MinhNhut223/Automated-Poultry-Farming-Machine/HinhAnh/z6175985604822_b02541a4a94ac1b592ec28021ac87eae.jpg

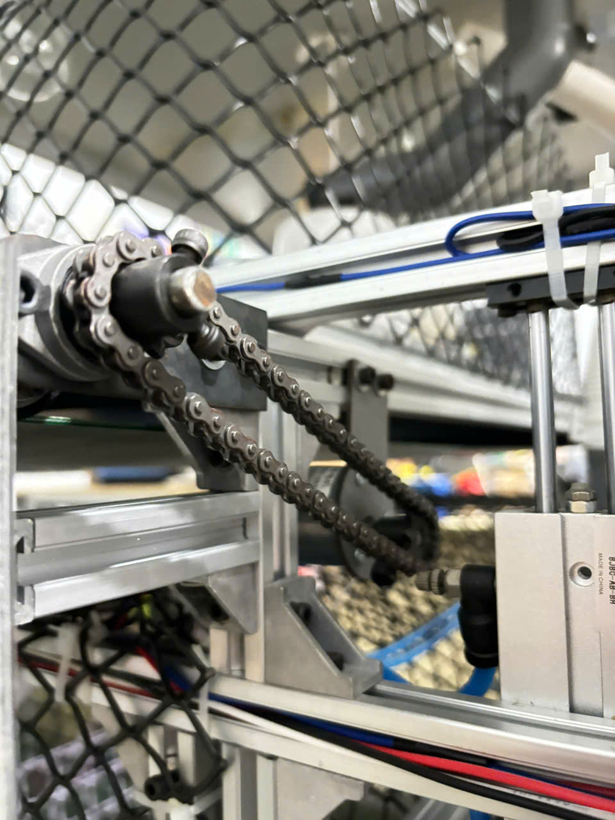
HinhAnh/z6175985604822_b02541a4a94ac1b592ec28021ac87eae.jpg
