MinhNhut223/Automated-Poultry-Farming-Machine/HinhAnh/z6175985603185_9a857a15ade55823d01da177bfa1e83b.jpg

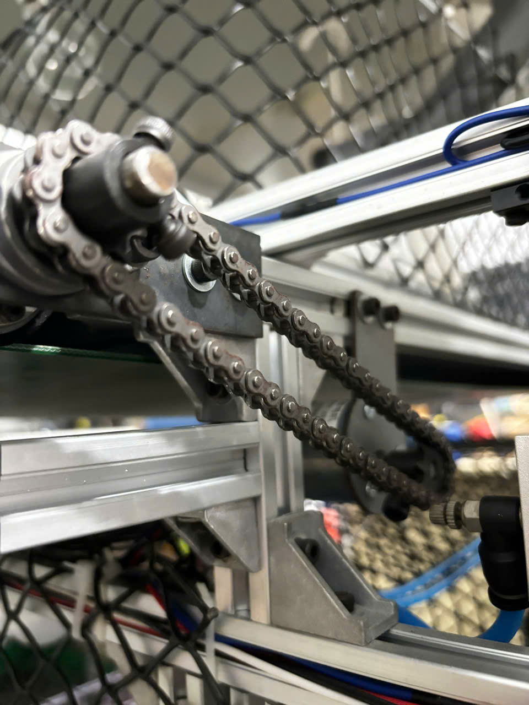
HinhAnh/z6175985603185_9a857a15ade55823d01da177bfa1e83b.jpg
