MinhNhut223/Automated-Poultry-Farming-Machine/chuongga/PerformanceLog.txt

Number of Contacts: 0
Number of contact data: 0
