MinhNhut223/Automated-Poultry-Farming-Machine/chuongga/khung-Static 1-1.docx

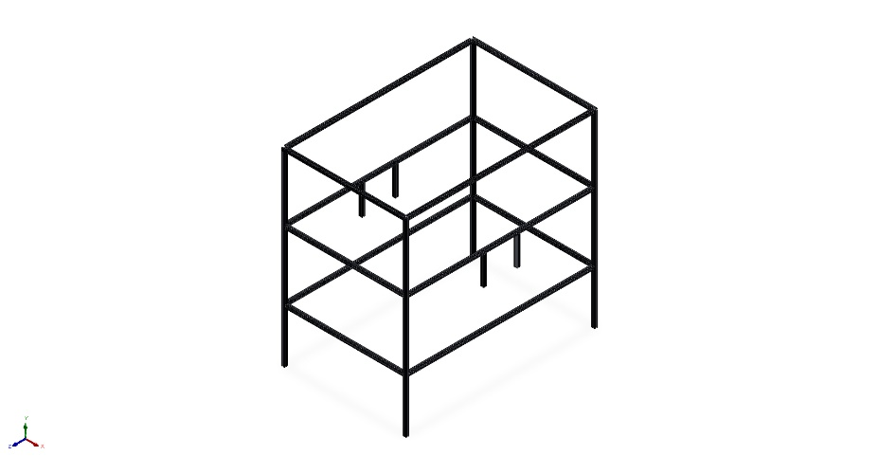
[picture p3: figure]

Simulation of khung

Date: Friday, December 27, 2024
Designer: Solidworks

Study name: Static 1

Analysis type: Static
Description No Data

# Assumptions

# Model Information

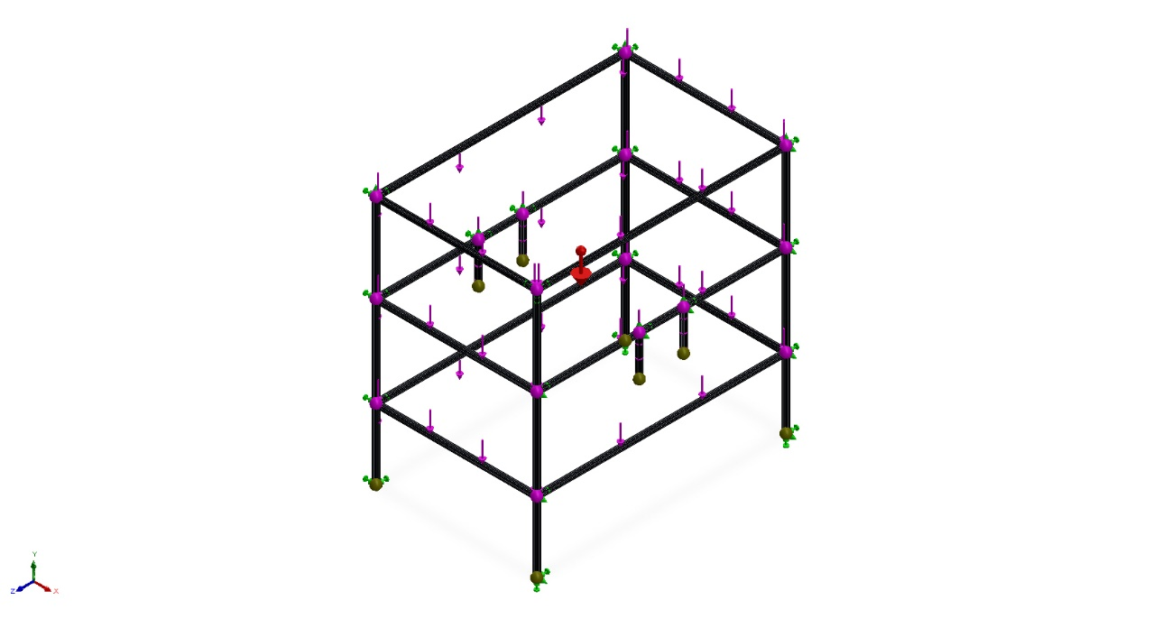
[picture p4: figure]

Model name: khung

Current Configuration: Default<As Machined>

Beam Bodies:
Document Name and Reference | Formulation | Properties | Document Path/Date Modified
SolidBody 1( C:\THUVIENSOLIDWORKS\ALUMINUM FRAMES25102020\SERI 5 (20,40)\20X20S5 - IS MISSING(1)[8]) | Beam – Uniform C/S | Section Standard-Aluminum Frames25102020/SERI 5 (20,40)/20x20S5 Section Area: 0.000172186m^2 Length:780mm Volume:0.000134512m^3 Mass Density:2,700kg/m^3 Mass:0.363182kg Weight:3.55919N | C:\Users\Asus\Desktop\chuongga\chuongga\khung.SLDPRT Dec 23 21:09:03 2024
SolidBody 2( C:\THUVIENSOLIDWORKS\ALUMINUM FRAMES25102020\SERI 5 (20,40)\20X20S5 - IS MISSING(1)[6]) | Beam – Uniform C/S | Section Standard-Aluminum Frames25102020/SERI 5 (20,40)/20x20S5 Section Area: 0.000172186m^2 Length:780mm Volume:0.000134512m^3 Mass Density:2,700kg/m^3 Mass:0.363182kg Weight:3.55919N | C:\Users\Asus\Desktop\chuongga\chuongga\khung.SLDPRT Dec 23 21:09:03 2024
SolidBody 3( C:\THUVIENSOLIDWORKS\ALUMINUM FRAMES25102020\SERI 5 (20,40)\20X20S5 - IS MISSING(1)[16]) | Beam – Uniform C/S | Section Standard-Aluminum Frames25102020/SERI 5 (20,40)/20x20S5 Section Area: 0.000172186m^2 Length:190.4mm Volume:3.27842e-05m^3 Mass Density:2,700kg/m^3 Mass:0.0885173kg Weight:0.86747N | C:\Users\Asus\Desktop\chuongga\chuongga\khung.SLDPRT Dec 23 21:09:03 2024
SolidBody 4( C:\THUVIENSOLIDWORKS\ALUMINUM FRAMES25102020\SERI 5 (20,40)\20X20S5 - IS MISSING(1)[10]) | Beam – Uniform C/S | Section Standard-Aluminum Frames25102020/SERI 5 (20,40)/20x20S5 Section Area: 0.000172186m^2 Length:1,220.8mm Volume:0.000210205m^3 Mass Density:2,700kg/m^3 Mass:0.567552kg Weight:5.56201N | C:\Users\Asus\Desktop\chuongga\chuongga\khung.SLDPRT Dec 23 21:09:03 2024
SolidBody 5( C:\THUVIENSOLIDWORKS\ALUMINUM FRAMES25102020\SERI 5 (20,40)\20X20S5 - IS MISSING(1)[11]) | Beam – Uniform C/S | Section Standard-Aluminum Frames25102020/SERI 5 (20,40)/20x20S5 Section Area: 0.000172186m^2 Length:1,220.8mm Volume:0.000210205m^3 Mass Density:2,700kg/m^3 Mass:0.567552kg Weight:5.56201N | C:\Users\Asus\Desktop\chuongga\chuongga\khung.SLDPRT Dec 23 21:09:03 2024
SolidBody 6( C:\THUVIENSOLIDWORKS\ALUMINUM FRAMES25102020\SERI 5 (20,40)\20X20S5 - IS MISSING(1)[2]) | Beam – Uniform C/S | Section Standard-Aluminum Frames25102020/SERI 5 (20,40)/20x20S5 Section Area: 0.000172186m^2 Length:1,240mm Volume:0.00021351m^3 Mass Density:2,700kg/m^3 Mass:0.576478kg Weight:5.64949N | C:\Users\Asus\Desktop\chuongga\chuongga\khung.SLDPRT Dec 23 21:09:03 2024
SolidBody 7( C:\THUVIENSOLIDWORKS\ALUMINUM FRAMES25102020\SERI 5 (20,40)\20X20S5 - IS MISSING(1)[14]) | Beam – Uniform C/S | Section Standard-Aluminum Frames25102020/SERI 5 (20,40)/20x20S5 Section Area: 0.000172186m^2 Length:190.4mm Volume:3.27842e-05m^3 Mass Density:2,700kg/m^3 Mass:0.0885173kg Weight:0.86747N | C:\Users\Asus\Desktop\chuongga\chuongga\khung.SLDPRT Dec 23 21:09:03 2024
SolidBody 8( C:\THUVIENSOLIDWORKS\ALUMINUM FRAMES25102020\SERI 5 (20,40)\20X20S5 - IS MISSING(1)[18]) | Beam – Uniform C/S | Section Standard-Aluminum Frames25102020/SERI 5 (20,40)/20x20S5 Section Area: 0.000172186m^2 Length:780mm Volume:0.000134305m^3 Mass Density:2,700kg/m^3 Mass:0.362623kg Weight:3.55371N | C:\Users\Asus\Desktop\chuongga\chuongga\khung.SLDPRT Dec 23 21:09:03 2024
SolidBody 9( C:\THUVIENSOLIDWORKS\ALUMINUM FRAMES25102020\SERI 5 (20,40)\20X20S5 - IS MISSING(1)[9]) | Beam – Uniform C/S | Section Standard-Aluminum Frames25102020/SERI 5 (20,40)/20x20S5 Section Area: 0.000172186m^2 Length:1,220.8mm Volume:0.000210205m^3 Mass Density:2,700kg/m^3 Mass:0.567552kg Weight:5.56201N | C:\Users\Asus\Desktop\chuongga\chuongga\khung.SLDPRT Dec 23 21:09:03 2024
SolidBody 10( C:\THUVIENSOLIDWORKS\ALUMINUM FRAMES25102020\SERI 5 (20,40)\20X20S5 - IS MISSING(1)[4]) | Beam – Uniform C/S | Section Standard-Aluminum Frames25102020/SERI 5 (20,40)/20x20S5 Section Area: 0.000172186m^2 Length:1,240mm Volume:0.00021351m^3 Mass Density:2,700kg/m^3 Mass:0.576478kg Weight:5.64949N | C:\Users\Asus\Desktop\chuongga\chuongga\khung.SLDPRT Dec 23 21:09:03 2024
SolidBody 11( C:\THUVIENSOLIDWORKS\ALUMINUM FRAMES25102020\SERI 5 (20,40)\20X20S5 - IS MISSING(1)[19]) | Beam – Uniform C/S | Section Standard-Aluminum Frames25102020/SERI 5 (20,40)/20x20S5 Section Area: 0.000172186m^2 Length:780mm Volume:0.000134305m^3 Mass Density:2,700kg/m^3 Mass:0.362623kg Weight:3.55371N | C:\Users\Asus\Desktop\chuongga\chuongga\khung.SLDPRT Dec 23 21:09:03 2024
SolidBody 12( C:\THUVIENSOLIDWORKS\ALUMINUM FRAMES25102020\SERI 5 (20,40)\20X20S5 - IS MISSING(1)[12]) | Beam – Uniform C/S | Section Standard-Aluminum Frames25102020/SERI 5 (20,40)/20x20S5 Section Area: 0.000172186m^2 Length:1,220.8mm Volume:0.000210205m^3 Mass Density:2,700kg/m^3 Mass:0.567552kg Weight:5.56201N | C:\Users\Asus\Desktop\chuongga\chuongga\khung.SLDPRT Dec 23 21:09:03 2024
SolidBody 13( C:\THUVIENSOLIDWORKS\ALUMINUM FRAMES25102020\SERI 5 (20,40)\20X20S5 - IS MISSING(1)[1]) | Beam – Uniform C/S | Section Standard-Aluminum Frames25102020/SERI 5 (20,40)/20x20S5 Section Area: 0.000172186m^2 Length:1,240mm Volume:0.00021351m^3 Mass Density:2,700kg/m^3 Mass:0.576478kg Weight:5.64949N | C:\Users\Asus\Desktop\chuongga\chuongga\khung.SLDPRT Dec 23 21:09:03 2024
SolidBody 14( C:\THUVIENSOLIDWORKS\ALUMINUM FRAMES25102020\SERI 5 (20,40)\20X20S5 - IS MISSING(1)[5]) | Beam – Uniform C/S | Section Standard-Aluminum Frames25102020/SERI 5 (20,40)/20x20S5 Section Area: 0.000172186m^2 Length:1,220.8mm Volume:0.000210203m^3 Mass Density:2,700kg/m^3 Mass:0.567547kg Weight:5.56196N | C:\Users\Asus\Desktop\chuongga\chuongga\khung.SLDPRT Dec 23 21:09:03 2024
SolidBody 15( C:\THUVIENSOLIDWORKS\ALUMINUM FRAMES25102020\SERI 5 (20,40)\20X20S5 - IS MISSING(1)[15]) | Beam – Uniform C/S | Section Standard-Aluminum Frames25102020/SERI 5 (20,40)/20x20S5 Section Area: 0.000172186m^2 Length:190.4mm Volume:3.27842e-05m^3 Mass Density:2,700kg/m^3 Mass:0.0885173kg Weight:0.86747N | C:\Users\Asus\Desktop\chuongga\chuongga\khung.SLDPRT Dec 23 21:09:03 2024
SolidBody 16( C:\THUVIENSOLIDWORKS\ALUMINUM FRAMES25102020\SERI 5 (20,40)\20X20S5 - IS MISSING(1)[7]) | Beam – Uniform C/S | Section Standard-Aluminum Frames25102020/SERI 5 (20,40)/20x20S5 Section Area: 0.000172186m^2 Length:1,220.8mm Volume:0.000210203m^3 Mass Density:2,700kg/m^3 Mass:0.567547kg Weight:5.56196N | C:\Users\Asus\Desktop\chuongga\chuongga\khung.SLDPRT Dec 23 21:09:03 2024
SolidBody 17( C:\THUVIENSOLIDWORKS\ALUMINUM FRAMES25102020\SERI 5 (20,40)\20X20S5 - IS MISSING(1)[17]) | Beam – Uniform C/S | Section Standard-Aluminum Frames25102020/SERI 5 (20,40)/20x20S5 Section Area: 0.000172186m^2 Length:780mm Volume:0.000134305m^3 Mass Density:2,700kg/m^3 Mass:0.362623kg Weight:3.55371N | C:\Users\Asus\Desktop\chuongga\chuongga\khung.SLDPRT Dec 23 21:09:03 2024
SolidBody 18( C:\THUVIENSOLIDWORKS\ALUMINUM FRAMES25102020\SERI 5 (20,40)\20X20S5 - IS MISSING(1)[3]) | Beam – Uniform C/S | Section Standard-Aluminum Frames25102020/SERI 5 (20,40)/20x20S5 Section Area: 0.000172186m^2 Length:1,240mm Volume:0.00021351m^3 Mass Density:2,700kg/m^3 Mass:0.576478kg Weight:5.64949N | C:\Users\Asus\Desktop\chuongga\chuongga\khung.SLDPRT Dec 23 21:09:03 2024
SolidBody 19( C:\THUVIENSOLIDWORKS\ALUMINUM FRAMES25102020\SERI 5 (20,40)\20X20S5 - IS MISSING(1)[20]) | Beam – Uniform C/S | Section Standard-Aluminum Frames25102020/SERI 5 (20,40)/20x20S5 Section Area: 0.000172186m^2 Length:780mm Volume:0.000134305m^3 Mass Density:2,700kg/m^3 Mass:0.362623kg Weight:3.55371N | C:\Users\Asus\Desktop\chuongga\chuongga\khung.SLDPRT Dec 23 21:09:03 2024
SolidBody 20( C:\THUVIENSOLIDWORKS\ALUMINUM FRAMES25102020\SERI 5 (20,40)\20X20S5 - IS MISSING(1)[13]) | Beam – Uniform C/S | Section Standard-Aluminum Frames25102020/SERI 5 (20,40)/20x20S5 Section Area: 0.000172186m^2 Length:190.4mm Volume:3.27842e-05m^3 Mass Density:2,700kg/m^3 Mass:0.0885173kg Weight:0.86747N | C:\Users\Asus\Desktop\chuongga\chuongga\khung.SLDPRT Dec 23 21:09:03 2024

# Study Properties

Study name | Static 1
Analysis type | Static
Mesh type | Beam Mesh
Solver type | Automatic
Inplane Effect: | Off
Soft Spring: | Off
Inertial Relief: | Off
Incompatible bonding options | Automatic
Large displacement | Off
Compute free body forces | On
Result folder | SOLIDWORKS document (C:\Users\Asus\Desktop\chuongga\chuongga)

# Units

Unit system: | SI (MKS)
Length/Displacement | mm
Temperature | Kelvin
Angular velocity | Rad/sec
Pressure/Stress | N/m^2

# Material Properties

Model Reference | Properties | Components

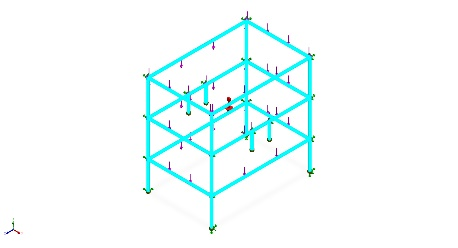
[picture p5: figure]

Name: | 6061 Alloy
Model type: | Linear Elastic Isotropic
Default failure criterion: | Unknown
Yield strength: | 5.51485e+07 N/m^2
Tensile strength: | 1.24084e+08 N/m^2
Elastic modulus: | 6.9e+10 N/m^2
Poisson's ratio: | 0.33
Mass density: | 2,700 kg/m^3
Shear modulus: | 2.6e+10 N/m^2
Thermal expansion coefficient: | 2.4e-05 /Kelvin

SolidBody 1( C:\THUVIENSOLIDWORKS\ALUMINUM FRAMES25102020\SERI 5 (20,40)\20X20S5 - IS MISSING(1)[8])(khung),

SolidBody 2( C:\THUVIENSOLIDWORKS\ALUMINUM FRAMES25102020\SERI 5 (20,40)\20X20S5 - IS MISSING(1)[6])(khung),

SolidBody 3( C:\THUVIENSOLIDWORKS\ALUMINUM FRAMES25102020\SERI 5 (20,40)\20X20S5 - IS MISSING(1)[16])(khung),

SolidBody 4( C:\THUVIENSOLIDWORKS\ALUMINUM FRAMES25102020\SERI 5 (20,40)\20X20S5 - IS MISSING(1)[10])(khung),

SolidBody 5( C:\THUVIENSOLIDWORKS\ALUMINUM FRAMES25102020\SERI 5 (20,40)\20X20S5 - IS MISSING(1)[11])(khung),

SolidBody 6( C:\THUVIENSOLIDWORKS\ALUMINUM FRAMES25102020\SERI 5 (20,40)\20X20S5 - IS MISSING(1)[2])(khung),

SolidBody 7( C:\THUVIENSOLIDWORKS\ALUMINUM FRAMES25102020\SERI 5 (20,40)\20X20S5 - IS MISSING(1)[14])(khung),

SolidBody 8( C:\THUVIENSOLIDWORKS\ALUMINUM FRAMES25102020\SERI 5 (20,40)\20X20S5 - IS MISSING(1)[18])(khung),

SolidBody 9( C:\THUVIENSOLIDWORKS\ALUMINUM FRAMES25102020\SERI 5 (20,40)\20X20S5 - IS MISSING(1)[9])(khung),

SolidBody 10( C:\THUVIENSOLIDWORKS\ALUMINUM FRAMES25102020\SERI 5 (20,40)\20X20S5 - IS MISSING(1)[4])(khung),

SolidBody 11( C:\THUVIENSOLIDWORKS\ALUMINUM FRAMES25102020\SERI 5 (20,40)\20X20S5 - IS MISSING(1)[19])(khung),

SolidBody 12( C:\THUVIENSOLIDWORKS\ALUMINUM FRAMES25102020\SERI 5 (20,40)\20X20S5 - IS MISSING(1)[12])(khung),

SolidBody 13( C:\THUVIENSOLIDWORKS\ALUMINUM FRAMES25102020\SERI 5 (20,40)\20X20S5 - IS MISSING(1)[1])(khung),

SolidBody 14( C:\THUVIENSOLIDWORKS\ALUMINUM FRAMES25102020\SERI 5 (20,40)\20X20S5 - IS MISSING(1)[5])(khung),

SolidBody 15( C:\THUVIENSOLIDWORKS\ALUMINUM FRAMES25102020\SERI 5 (20,40)\20X20S5 - IS MISSING(1)[15])(khung),

SolidBody 16( C:\THUVIENSOLIDWORKS\ALUMINUM FRAMES25102020\SERI 5 (20,40)\20X20S5 - IS MISSING(1)[7])(khung),

SolidBody 17( C:\THUVIENSOLIDWORKS\ALUMINUM FRAMES25102020\SERI 5 (20,40)\20X20S5 - IS MISSING(1)[17])(khung),

SolidBody 18( C:\THUVIENSOLIDWORKS\ALUMINUM FRAMES25102020\SERI 5 (20,40)\20X20S5 - IS MISSING(1)[3])(khung),

SolidBody 19( C:\THUVIENSOLIDWORKS\ALUMINUM FRAMES25102020\SERI 5 (20,40)\20X20S5 - IS MISSING(1)[20])(khung),

SolidBody 20( C:\THUVIENSOLIDWORKS\ALUMINUM FRAMES25102020\SERI 5 (20,40)\20X20S5 - IS MISSING(1)[13])(khung)

Curve Data:N/A

# Loads and Fixtures

Fixture name | Fixture Image | Fixture Details

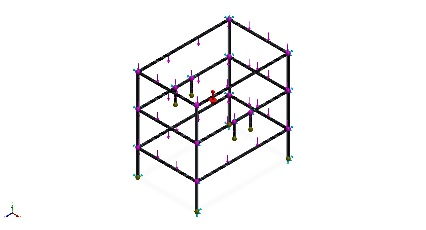
[picture p6: figure]

Fixed-1 | | Entities: 20 Joint(s) Type: Fixed Geometry

Load name | Load Image | Load Details

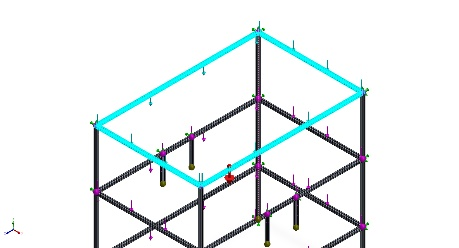
[picture p7: figure]

Force-1 | | Entities: 4 Beam (s) Reference: Edge< 1 > Type: Apply force Values: ---, ---, -10 N Moments: ---, ---, --- N.m

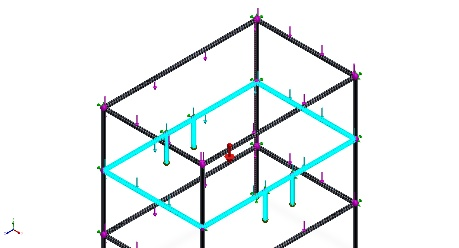
[picture p8: figure]

Force-2 | | Entities: 8 Beam (s) Reference: Edge< 1 > Type: Apply force Values: ---, ---, -30 N Moments: ---, ---, --- N.m

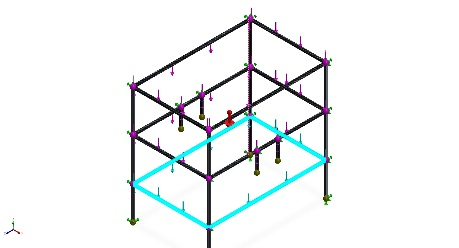
[picture p9: figure]

Force-3 | | Entities: 4 Beam (s) Reference: Edge< 1 > Type: Apply force Values: ---, ---, -50 N Moments: ---, ---, --- N.m

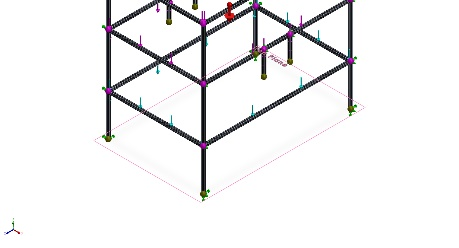
[picture p10: figure]

Gravity-1 | | Reference: Top Plane Values: 0 0 -9.81 Units: m/s^2

# Connector Definitions

No Data

# Contact Information

No Data

# Mesh information

Mesh type | Beam Mesh

## Mesh information - Details

Total Nodes | 534
Total Elements | 522
Time to complete mesh(hh;mm;ss): | 00:00:02
Computer name:

# Sensor Details

No Data

# Resultant Forces

## Reaction forces

Selection set | Units | Sum X | Sum Y | Sum Z | Resultant
Entire Model | N | -3.52429e-12 | 562.219 | -7.16227e-12 | 562.219

## Reaction Moments

Selection set | Units | Sum X | Sum Y | Sum Z | Resultant
Entire Model | N.m | 1.66893e-06 | -1.36078e-06 | 1.00662e-06 | 2.37704e-06

## Free body forces

Selection set | Units | Sum X | Sum Y | Sum Z | Resultant
Entire Model | N | 0 | 0 | 0 | 0

## Free body moments

Selection set | Units | Sum X | Sum Y | Sum Z | Resultant
Entire Model | N.m | 0 | 0 | 0 | 0

# Beams

## Beam Forces

Beam Name | Joints | Axial(N) | Shear1(N) | Shear2(N) | Moment1(N.m) | Moment2(N.m) | Torque(N.m)
Beam-1( C:\THUVIENSOLIDWORKS\ALUMINUM FRAMES25102020\SERI 5 (20,40)\20X20S5 - IS MISSING(1)[8]) | 1 | -1.77085e-16 | -9.06675e-16 | 6.88757 | -0.918342 | -1.2089e-16 | 3.66772e-23
| 2 | -1.77085e-16 | -9.06675e-16 | 6.88757 | 0.918342 | 1.2089e-16 | -3.81442e-23
Beam-2( C:\THUVIENSOLIDWORKS\ALUMINUM FRAMES25102020\SERI 5 (20,40)\20X20S5 - IS MISSING(1)[6]) | 1 | 1.74871e-16 | -6.82428 | 8.95341e-16 | -1.19379e-16 | -0.909903 | 0
| 2 | 1.74871e-16 | -6.82428 | 8.95341e-16 | 1.19379e-16 | 0.909903 | 0
Beam-3( C:\THUVIENSOLIDWORKS\ALUMINUM FRAMES25102020\SERI 5 (20,40)\20X20S5 - IS MISSING(1)[16]) | 1 | -6.31308e-08 | -1.26216e-18 | -1.06341e-13 | 1.22094e-15 | -2.83555e-21 | -4.73604e-31
| 2 | 30.9121 | -4.53032e-10 | -5.52753e-05 | -6.14169e-07 | 5.03368e-12 | -1.05574e-23
Beam-4( C:\THUVIENSOLIDWORKS\ALUMINUM FRAMES25102020\SERI 5 (20,40)\20X20S5 - IS MISSING(1)[10]) | 1 | 0.000216503 | -2.09023e-15 | 27.8276 | -5.75104 | -3.92446e-08 | 4.56072e-22
| 2 | -0.000216503 | 3.87871e-15 | 27.8276 | 5.75104 | 3.92446e-08 | -2.81416e-22
Beam-5( C:\THUVIENSOLIDWORKS\ALUMINUM FRAMES25102020\SERI 5 (20,40)\20X20S5 - IS MISSING(1)[11]) | 1 | -0.000216503 | 3.88184e-15 | 27.8276 | 5.75104 | 3.924e-08 | 9.21475e-08
| 2 | 0.000216503 | -2.0802e-15 | 27.8276 | -5.75104 | -3.924e-08 | 9.21475e-08
Beam-6( C:\THUVIENSOLIDWORKS\ALUMINUM FRAMES25102020\SERI 5 (20,40)\20X20S5 - IS MISSING(1)[2]) | 1 | 0.79812 | -9.93364e-24 | 0 | 0 | -1.53932e-25 | 0
| 2 | 1.00335 | 1.233e-23 | -9.86403e-23 | -1.14358e-24 | -1.42944e-25 | 0
| 3 | 0.79812 | 9.93364e-24 | 0 | 0 | -1.53932e-25 | 0
| 4 | 1.02615 | 1.23306e-23 | -9.86449e-23 | -1.17058e-24 | -1.4632e-25 | 0
Beam-7( C:\THUVIENSOLIDWORKS\ALUMINUM FRAMES25102020\SERI 5 (20,40)\20X20S5 - IS MISSING(1)[14]) | 1 | -6.31308e-08 | -1.7651e-24 | 1.46579e-23 | 1.41025e-26 | -1.67768e-26 | 0
| 2 | 30.9121 | 1.0912e-15 | 5.37205e-15 | 5.37205e-16 | -1.0912e-16 | 0
Beam-8( C:\THUVIENSOLIDWORKS\ALUMINUM FRAMES25102020\SERI 5 (20,40)\20X20S5 - IS MISSING(1)[18]) | 1 | -5.45599e-16 | -2.68602e-15 | 16.8243 | -2.24324 | -3.58136e-16 | 8.95916e-23
| 2 | -5.45599e-16 | -2.68602e-15 | 16.8243 | 2.24324 | 3.58136e-16 | -9.31749e-23
Beam-9( C:\THUVIENSOLIDWORKS\ALUMINUM FRAMES25102020\SERI 5 (20,40)\20X20S5 - IS MISSING(1)[9]) | 1 | -1.53871e-06 | -5.52206e-06 | 6.35469 | 0.390569 | 1.66734e-07 | -2.84458e-14
| 2 | 1.43929e-05 | -0.00023052 | 7.33233 | -0.623248 | -1.98611e-05 | -5.58873e-13
| 3 | -1.43929e-05 | -5.93324e-05 | 7.33233 | 0.623248 | 5.08344e-06 | -7.04428e-14
| 4 | -4.76553e-16 | 9.67998e-17 | 3.16297 | 0.115975 | -3.54932e-18 | -5.44744e-25
Beam-10( C:\THUVIENSOLIDWORKS\ALUMINUM FRAMES25102020\SERI 5 (20,40)\20X20S5 - IS MISSING(1)[4]) | 1 | 0.79812 | 0 | 0 | 0 | 0 | 0
| 2 | 1.00335 | -1.77699e-06 | -3.55387e-06 | -4.12014e-08 | 2.0601e-08 | -1.5734e-17
| 3 | 0.79812 | 0 | 0 | 0 | 0 | 0
| 4 | 1.02615 | -1.77698e-06 | -3.55408e-06 | -4.21749e-08 | 2.10863e-08 | -1.57168e-17
Beam-11( C:\THUVIENSOLIDWORKS\ALUMINUM FRAMES25102020\SERI 5 (20,40)\20X20S5 - IS MISSING(1)[19]) | 1 | 0.000154913 | -6.53009e-14 | 26.8243 | -3.57657 | -4.70573e-08 | 1.43147e-21
| 2 | -0.000154913 | 5.63506e-14 | 26.8243 | 3.57657 | 4.70573e-08 | -1.29185e-21
Beam-12( C:\THUVIENSOLIDWORKS\ALUMINUM FRAMES25102020\SERI 5 (20,40)\20X20S5 - IS MISSING(1)[12]) | 1 | -1.26789e-05 | 5.14208e-05 | -6.35468 | 0.390569 | 3.20058e-06 | -8.0124e-07
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
| 2 | -3.16866e-12 | 3.35221e+06 | -5.13629e-10 | 0 | 3.35221e+06
Beam-18( C:\THUVIENSOLIDWORKS\ALUMINUM FRAMES25102020\SERI 5 (20,40)\20X20S5 - IS MISSING(1)[3]) | 1 | 5,827.14 | 0.0307853 | -2.07063e-07 | -3.11671e-14 | 5,827.17
| 2 | -4,635.23 | 0 | 0 | 0 | 4,635.23
| 3 | 4,635.23 | 0 | 0 | 0 | 4,635.23
| 4 | 5,959.58 | 0.0315122 | 2.06334e-07 | 1.32972e-14 | 5,959.61
Beam-19( C:\THUVIENSOLIDWORKS\ALUMINUM FRAMES25102020\SERI 5 (20,40)\20X20S5 - IS MISSING(1)[20]) | 1 | -0.899684 | 5.3447e+06 | -0.0674883 | -2.30936e-14 | 5.3447e+06
| 2 | -0.899684 | 5.3447e+06 | -0.0674882 | -2.04871e-14 | 5.3447e+06
Beam-20( C:\THUVIENSOLIDWORKS\ALUMINUM FRAMES25102020\SERI 5 (20,40)\20X20S5 - IS MISSING(1)[13]) | 1 | 0.000366643 | -2.10735e-20 | -6.0194e-22 | 0 | 0.000366643
| 2 | 179,528 | 8.02779e-10 | 9.45912e-12 | 3.89062e-31 | 179,528

# Study Results

Name | Type | Min | Max
Stress1 | Upper bound axial and bending | 4.482e+02N/m^2 Element: 154 | 8.594e+06N/m^2 Element: 53

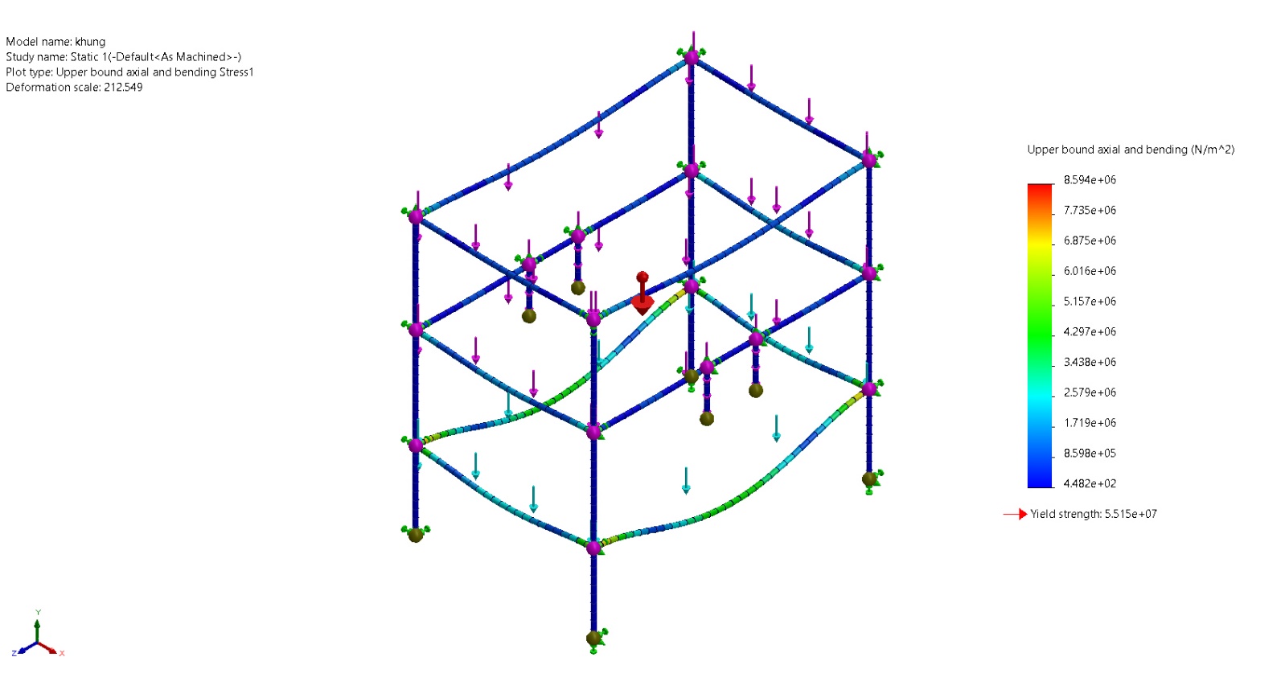
[picture p11: figure]

khung-Static 1-Stress-Stress1

Name | Type | Min | Max
Displacement1 | URES: Resultant Displacement | 0.000e+00mm Node: 1 | 6.304e-01mm Node: 74

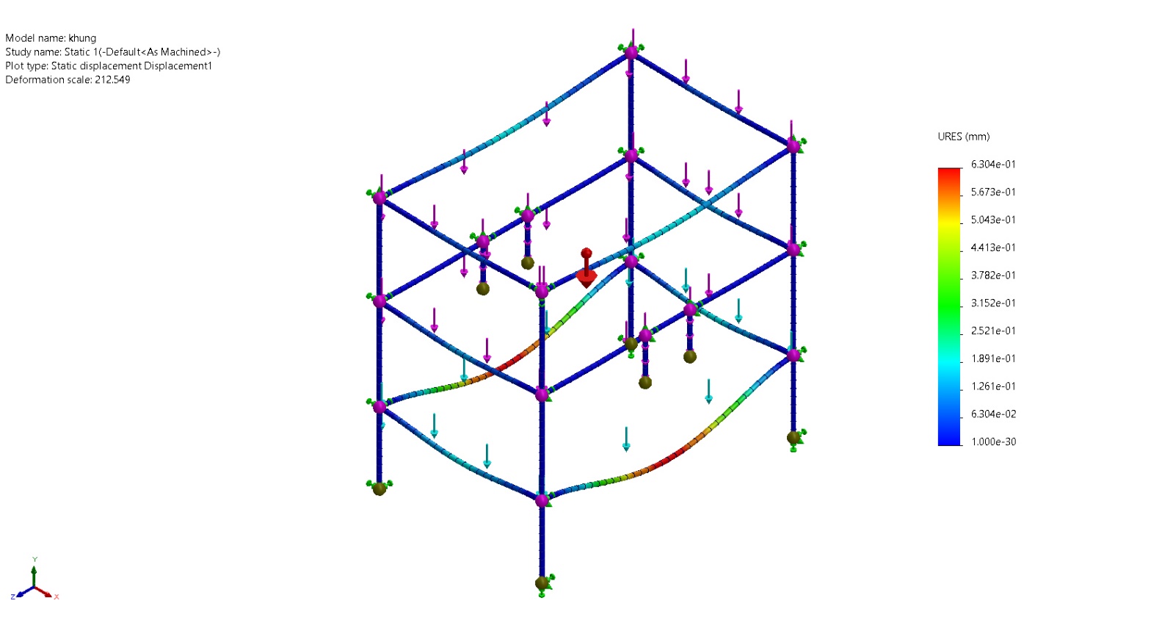
[picture p12: figure]

khung-Static 1-Displacement-Displacement1

Name | Type | Min | Max
Factor of Safety1 | Automatic | 6.417e+00 Node: 56 | 5.949e+04 Node: 135

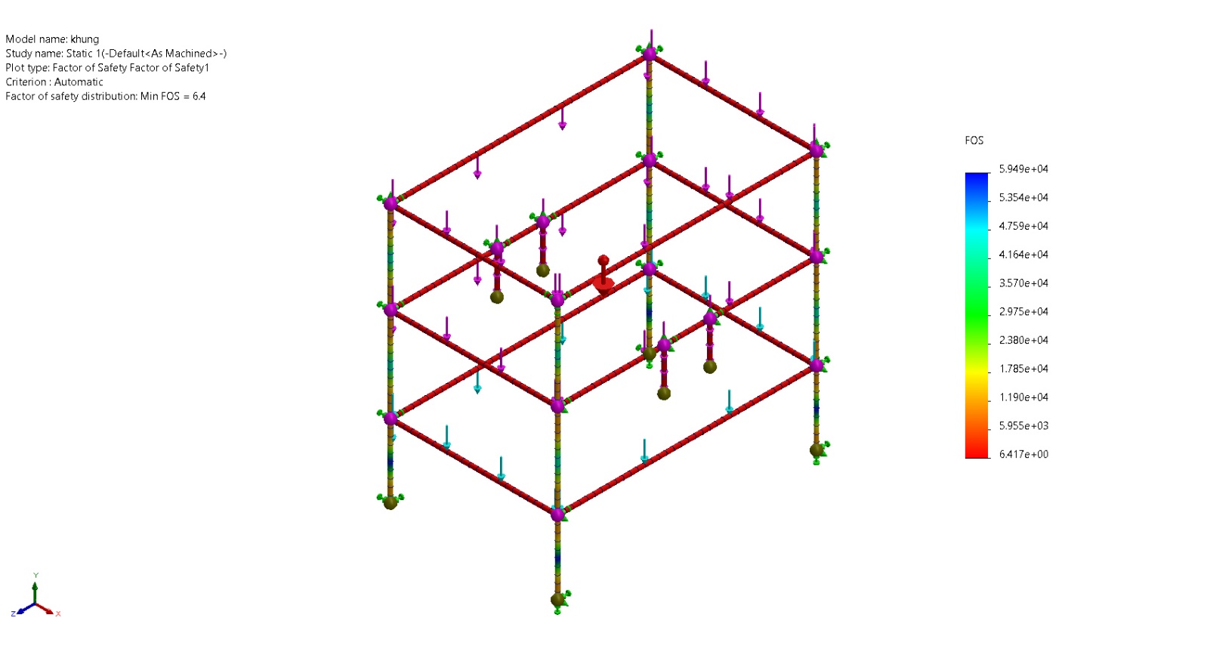
[picture p13: figure]

khung-Static 1-Factor of Safety-Factor of Safety1

# Conclusion

Analyzed with SOLIDWORKS Simulation Simulation of khung 16

Analyzed with SOLIDWORKS Simulation Simulation of khung 1
