MinhNhut223/Automated-Poultry-Farming-Machine/HinhAnh/z6133500936533_f67e374bdd0fcb332703e1a60a8dc8ce.jpg

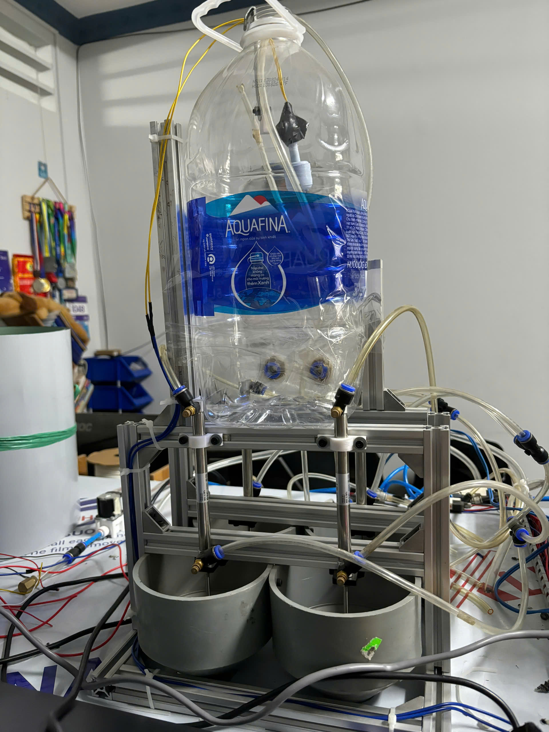
HinhAnh/z6133500936533_f67e374bdd0fcb332703e1a60a8dc8ce.jpg
