MinhNhut223/Automated-Poultry-Farming-Machine/HinhAnh/z6147042925820_783dffd860c2b915a9cced8f3b0c9add.jpg

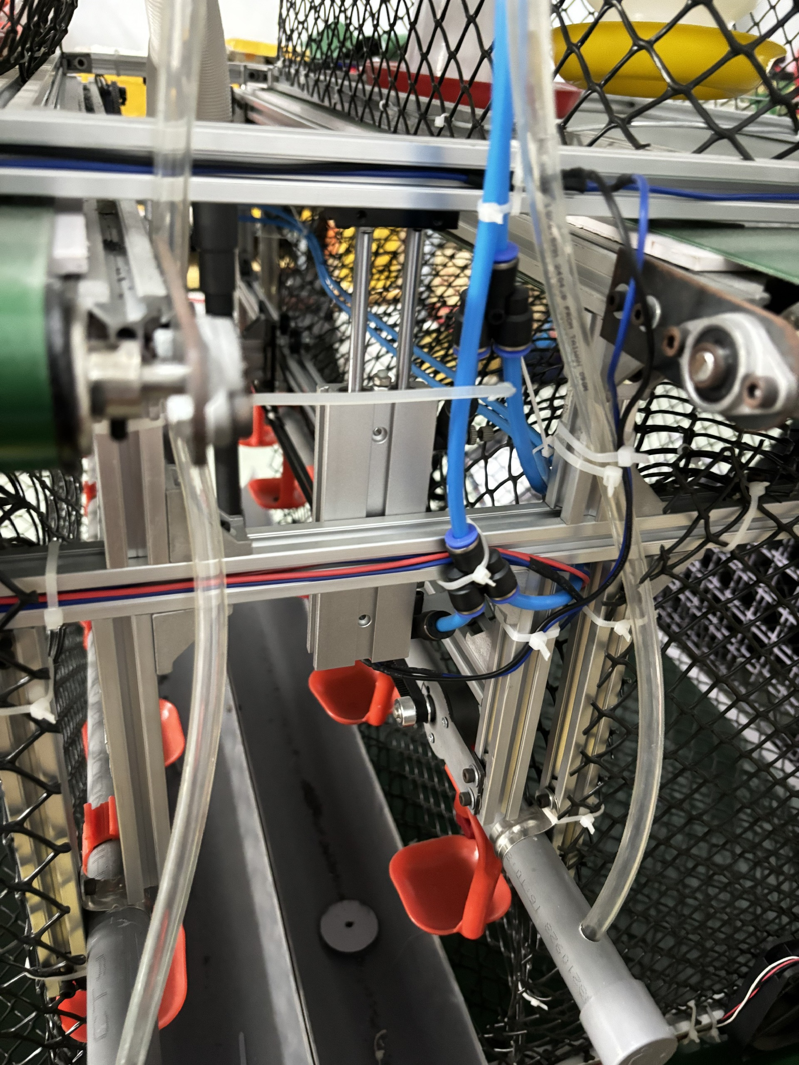
HinhAnh/z6147042925820_783dffd860c2b915a9cced8f3b0c9add.jpg
