MinhNhut223/Automated-Poultry-Farming-Machine/HinhAnh/z6175985514939_288a3877c3d74501aef89e6e031daaca.jpg

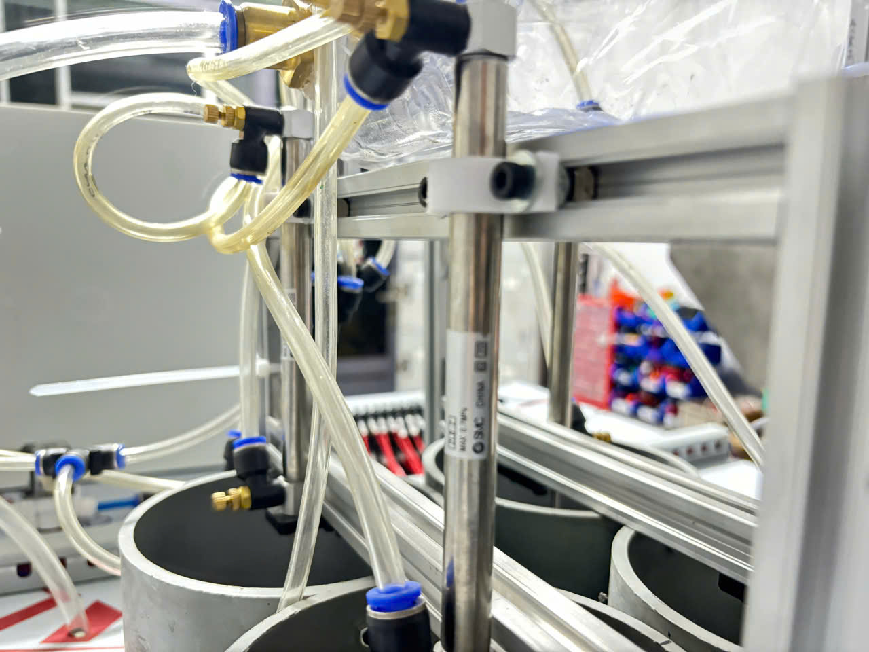
HinhAnh/z6175985514939_288a3877c3d74501aef89e6e031daaca.jpg
