MinhNhut223/Automated-Poultry-Farming-Machine/HinhAnh/z6175985522130_83845dab220dedee1d31ad316e043a9e.jpg

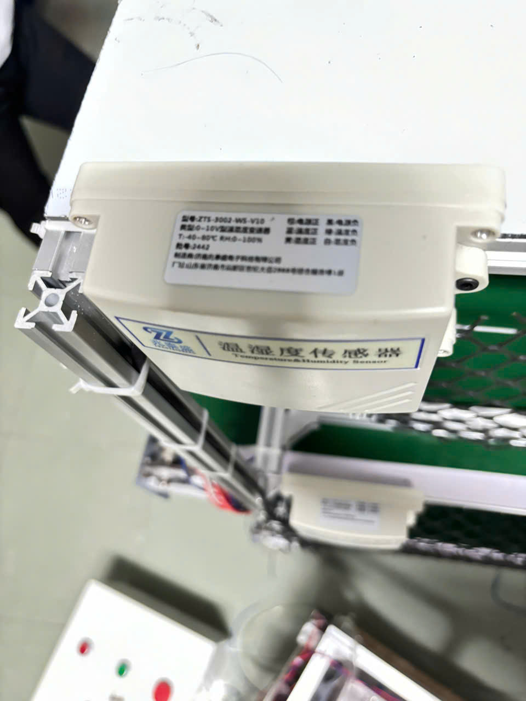
HinhAnh/z6175985522130_83845dab220dedee1d31ad316e043a9e.jpg
