MinhNhut223/Automated-Poultry-Farming-Machine/HinhAnh/z6175985527701_5b1d5e3dc922e62f0e787b937440c625.jpg

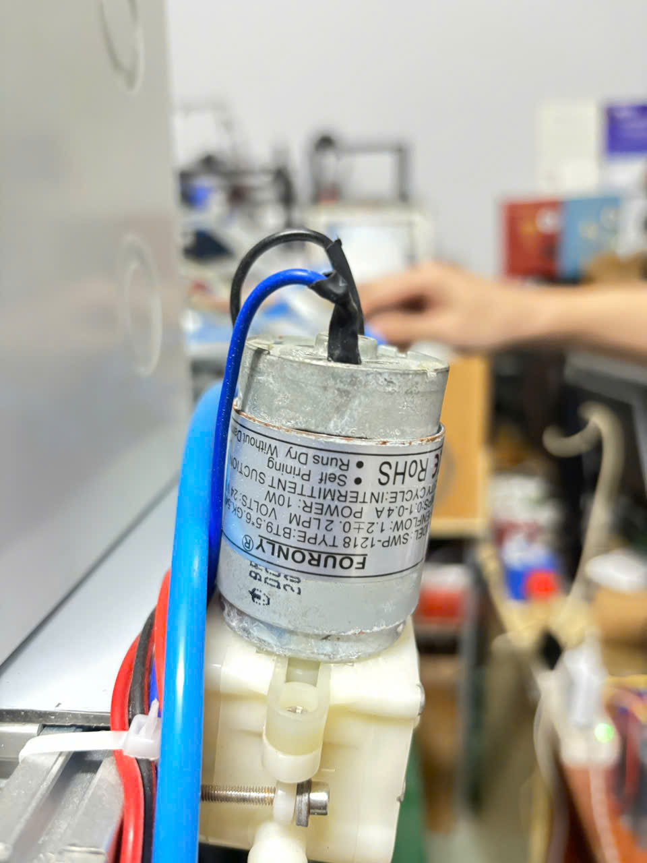
HinhAnh/z6175985527701_5b1d5e3dc922e62f0e787b937440c625.jpg
