MinhNhut223/Automated-Poultry-Farming-Machine/HinhAnh/z6175985534618_f18e18349bee8b5670a0fcbffc3b1ef2.jpg

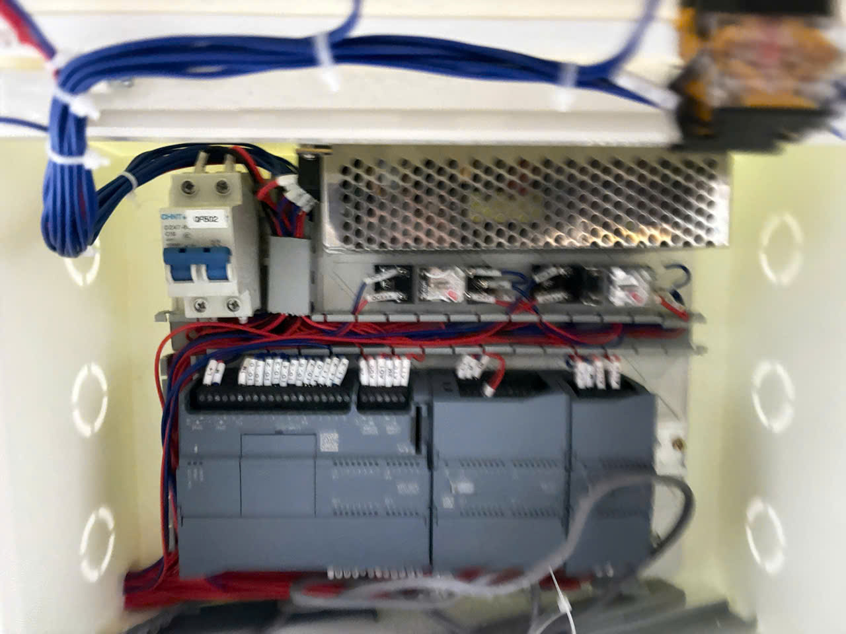
HinhAnh/z6175985534618_f18e18349bee8b5670a0fcbffc3b1ef2.jpg
