MinhNhut223/Automated-Poultry-Farming-Machine/HinhAnh/z6175985535728_11be2fed2e8fe7dd487282a688a94e54.jpg

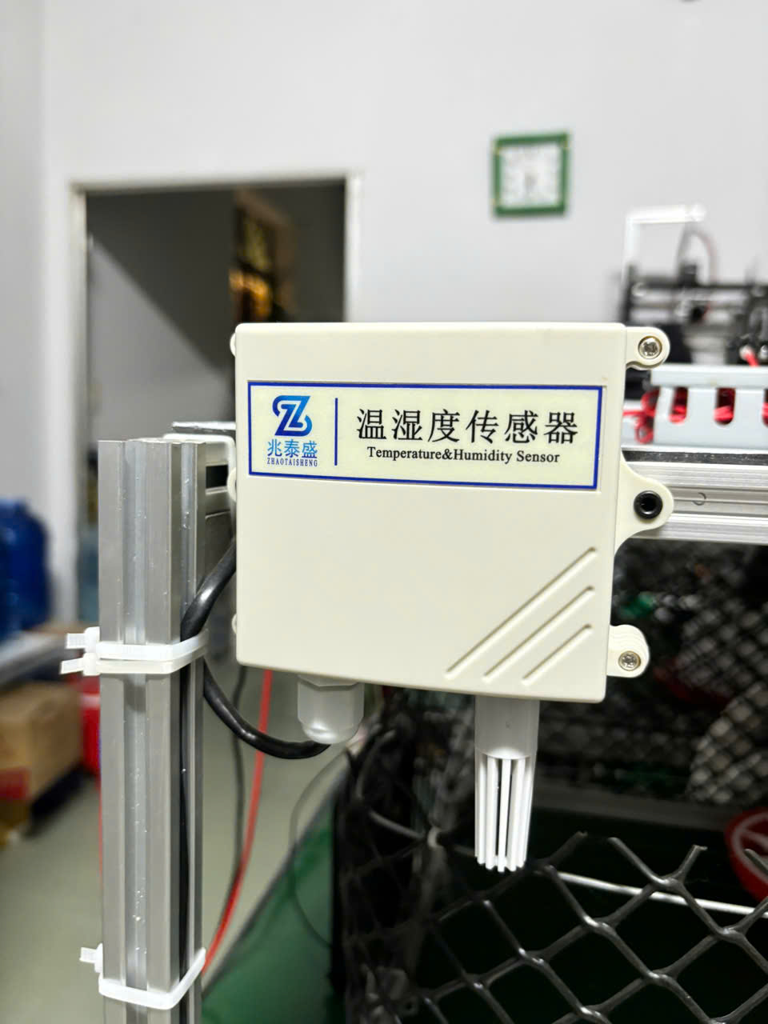
HinhAnh/z6175985535728_11be2fed2e8fe7dd487282a688a94e54.jpg
