MinhNhut223/Automated-Poultry-Farming-Machine/HinhAnh/z6175985539687_55dcc8e0c95181a05c519e080be61253.jpg

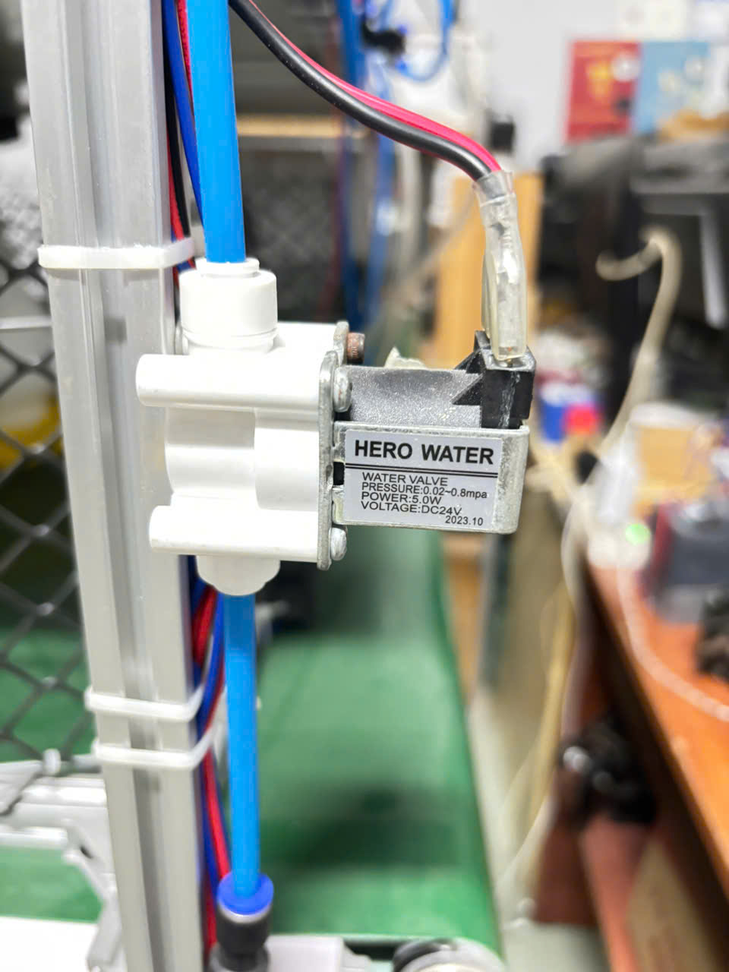
HinhAnh/z6175985539687_55dcc8e0c95181a05c519e080be61253.jpg
