MinhNhut223/Automated-Poultry-Farming-Machine/HinhAnh/z6175985541596_ed6177d2220c7401a862fb1e90e1272f.jpg

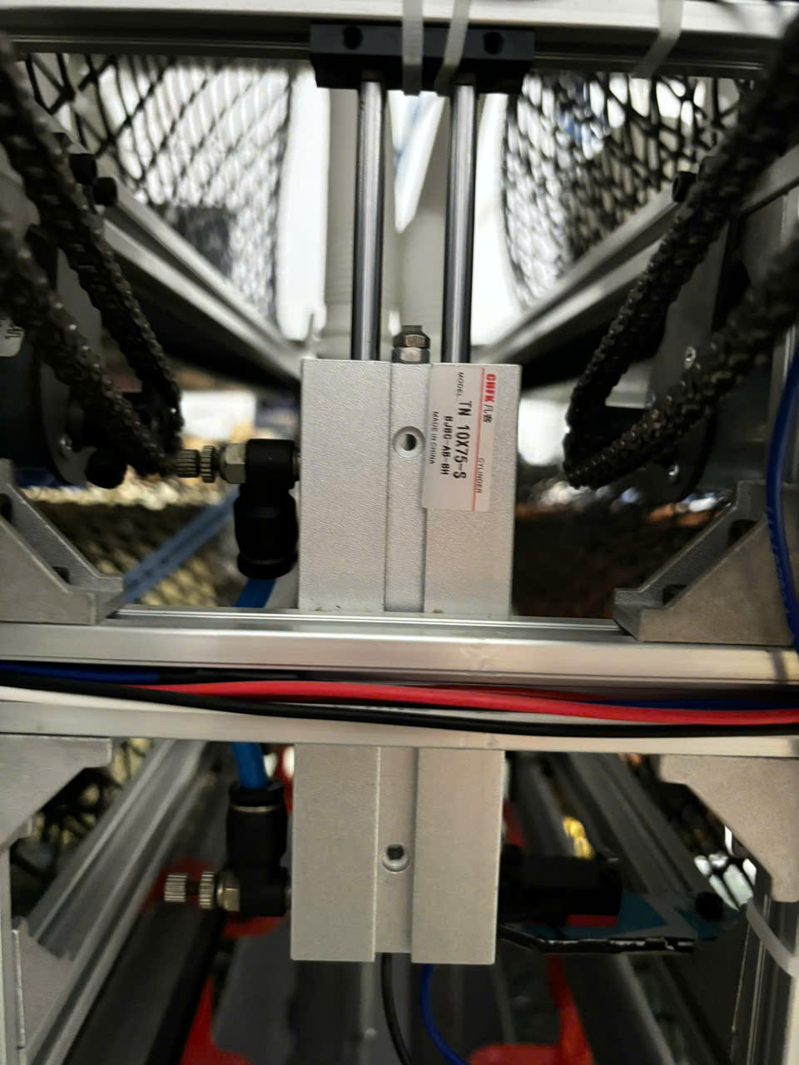
HinhAnh/z6175985541596_ed6177d2220c7401a862fb1e90e1272f.jpg
