MinhNhut223/Automated-Poultry-Farming-Machine/HinhAnh/z6175985547227_1bd644113b6d162239f35bd4506fcd88.jpg

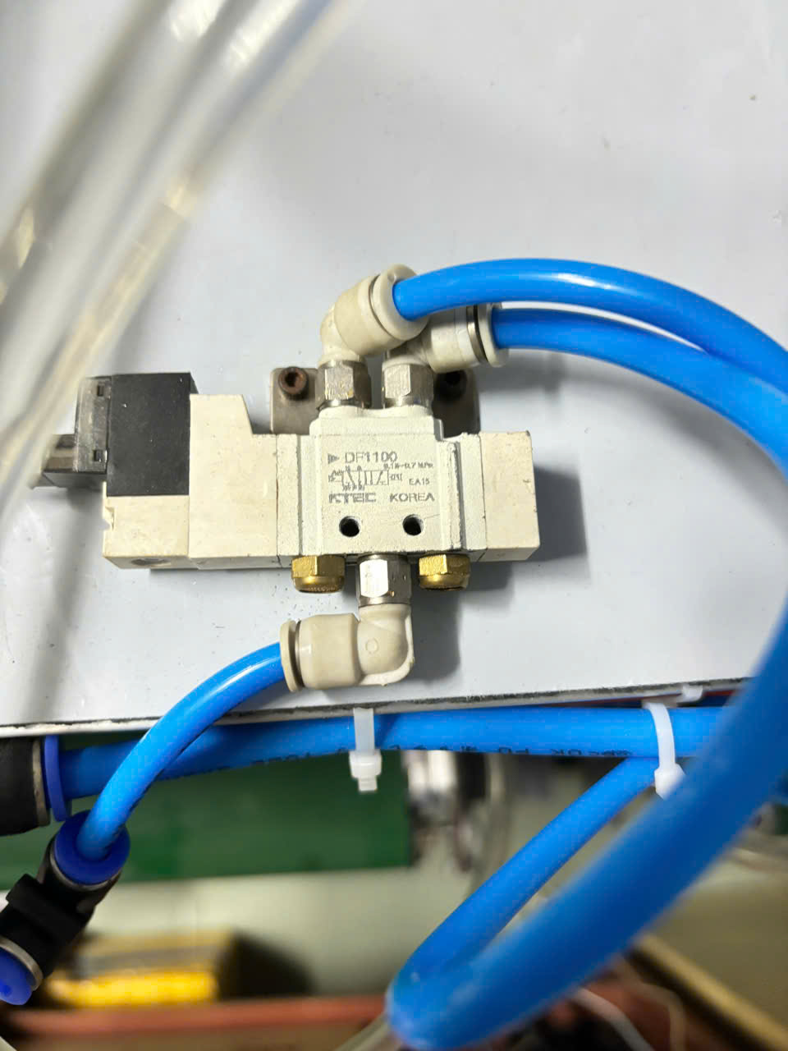
HinhAnh/z6175985547227_1bd644113b6d162239f35bd4506fcd88.jpg
