MinhNhut223/Automated-Poultry-Farming-Machine/HinhAnh/z6175985589705_baeef1de1ef4c2e4808714e5e42f03f7.jpg

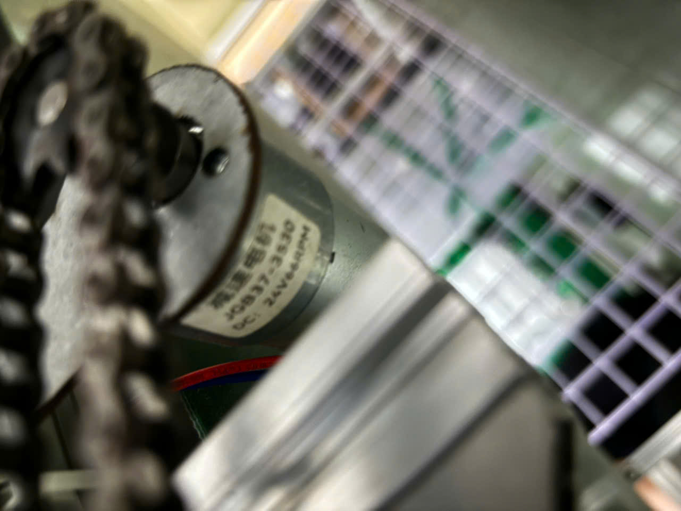
HinhAnh/z6175985589705_baeef1de1ef4c2e4808714e5e42f03f7.jpg
