MinhNhut223/Automated-Poultry-Farming-Machine/HinhAnh/z6175985590844_4abc7c96e6b7e47cde0360b80029135b.jpg

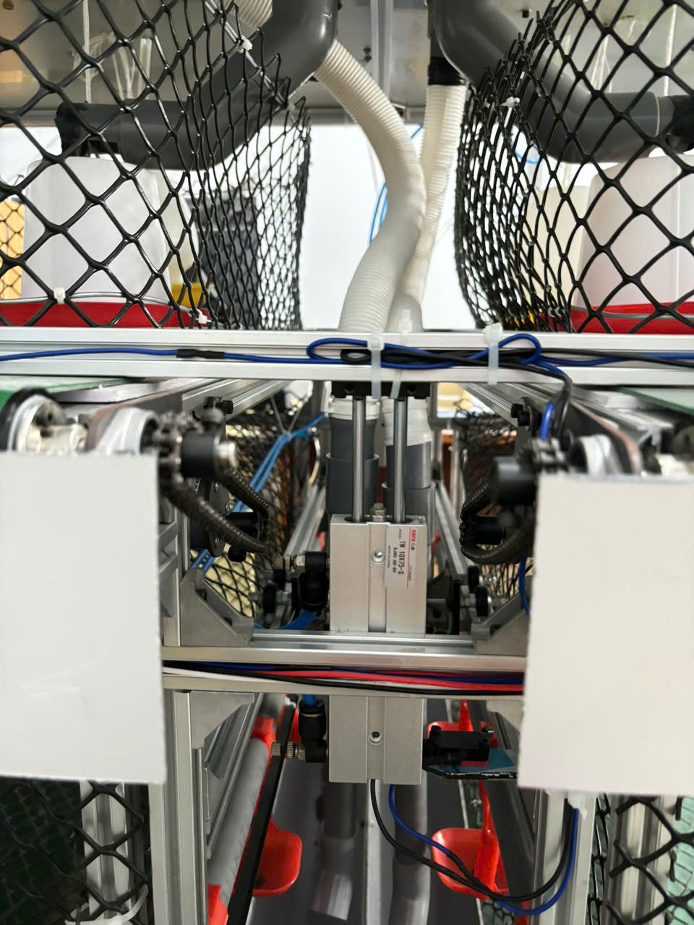
HinhAnh/z6175985590844_4abc7c96e6b7e47cde0360b80029135b.jpg
