MinhNhut223/Automated-Poultry-Farming-Machine/HinhAnh/z6175985599233_fd49453efe321ff98339c8ec095f6222.jpg

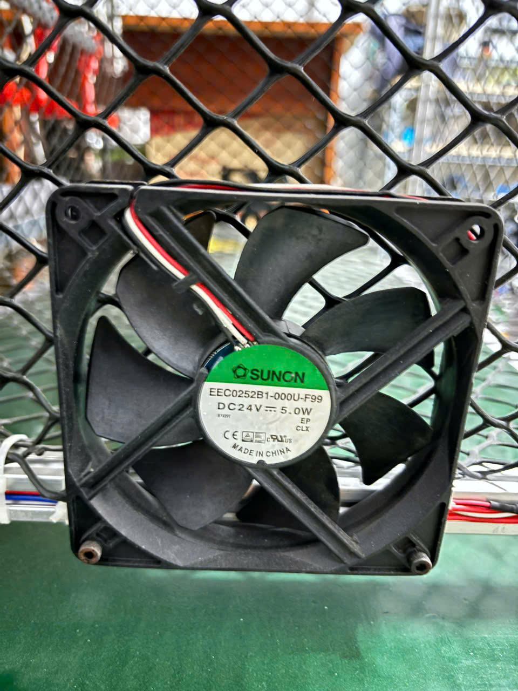
HinhAnh/z6175985599233_fd49453efe321ff98339c8ec095f6222.jpg
