MinhNhut223/Automated-Poultry-Farming-Machine/HinhAnh/z6175985605198_5d6e343832682354420701f3862bd3a5.jpg

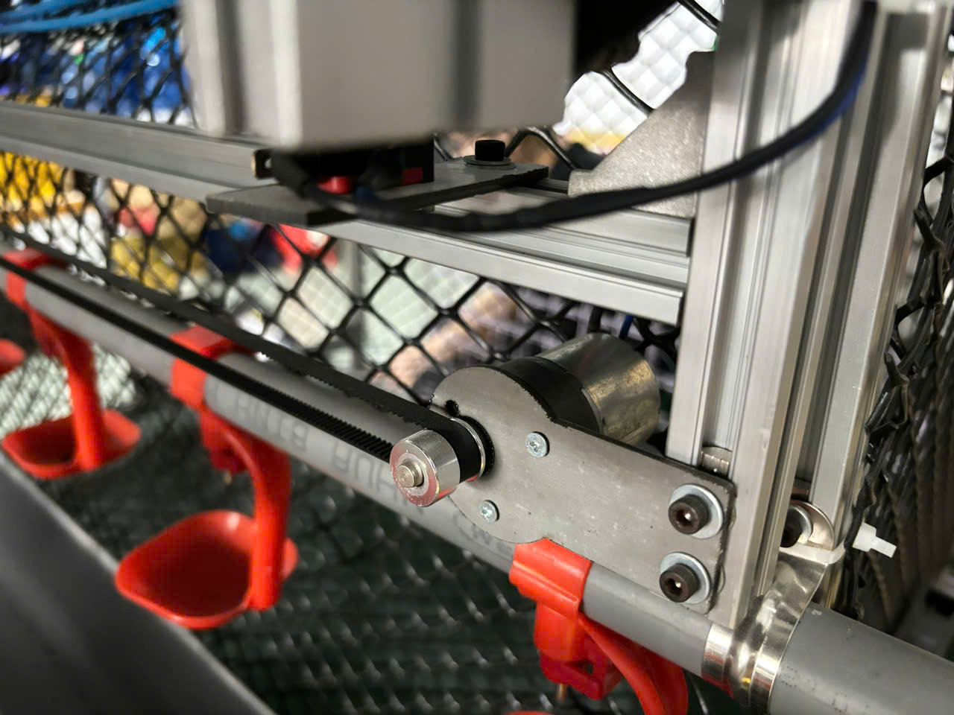
HinhAnh/z6175985605198_5d6e343832682354420701f3862bd3a5.jpg
