MinhNhut223/Automated-Poultry-Farming-Machine/HinhAnh/z6175985608458_d32dac861b734126c05554ae6e281720.jpg

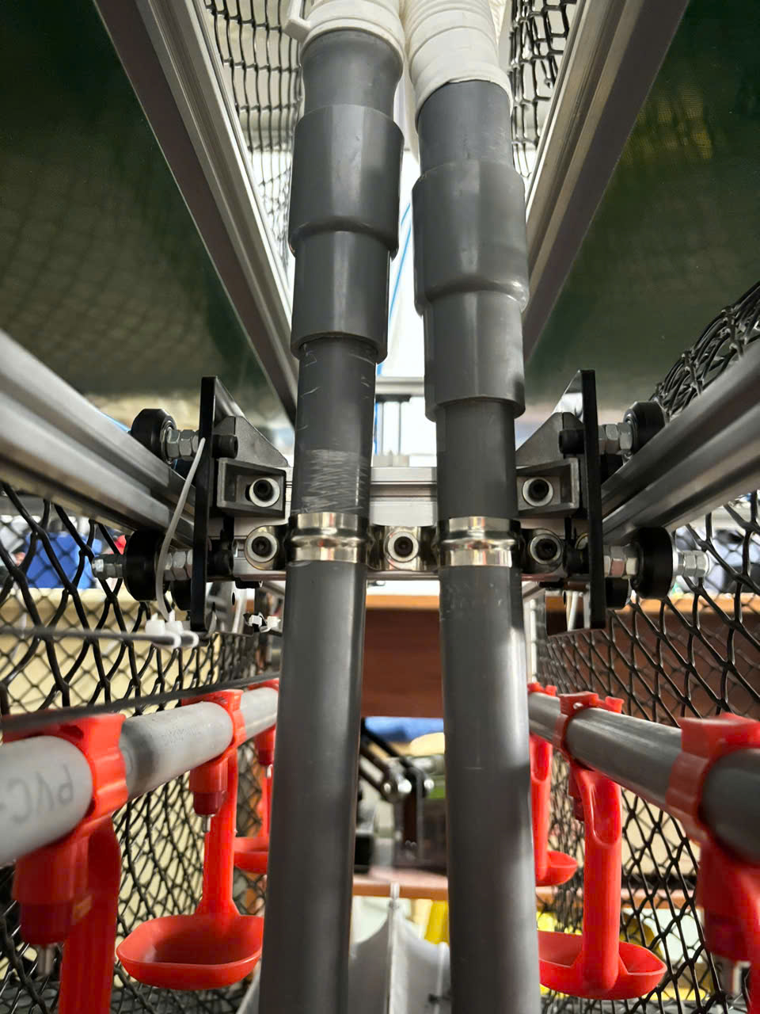
HinhAnh/z6175985608458_d32dac861b734126c05554ae6e281720.jpg
