MinhNhut223/Automated-Poultry-Farming-Machine/HinhAnh/z6175985616857_c82ac1a947d9183dc23fbea4e9678dff.jpg

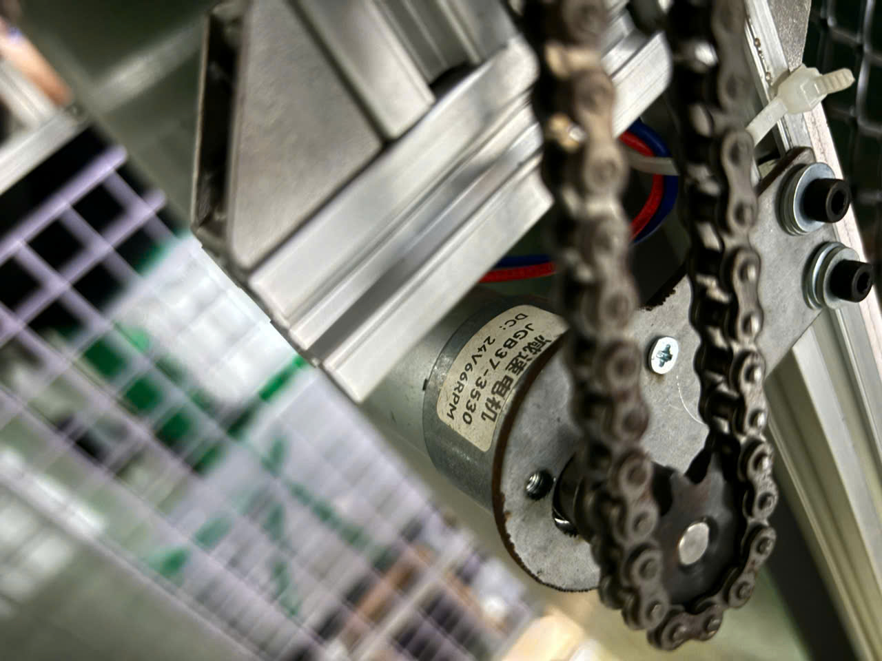
HinhAnh/z6175985616857_c82ac1a947d9183dc23fbea4e9678dff.jpg
