MinhNhut223/Automated-Poultry-Farming-Machine/HinhAnh/z6175985617010_a42d2ca3950fb5d358b09714c0bc3013.jpg

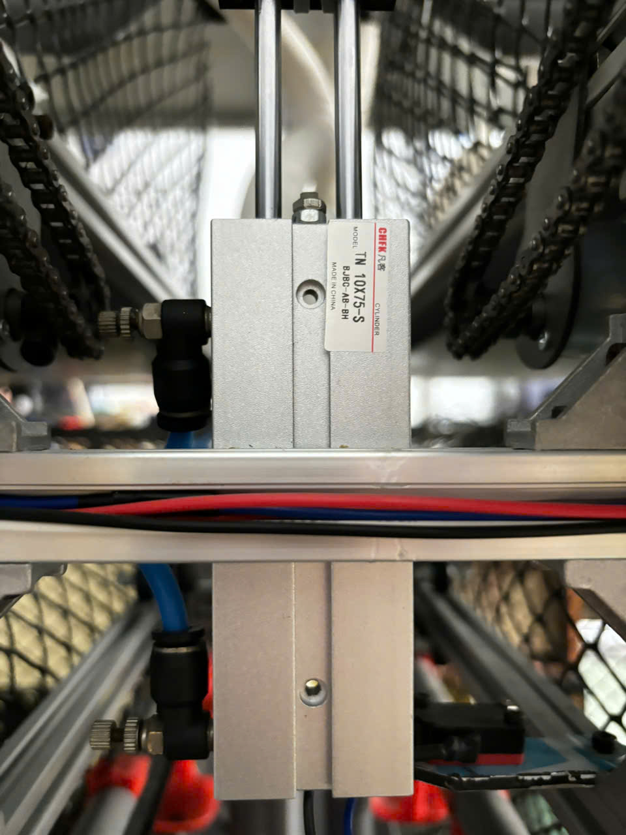
HinhAnh/z6175985617010_a42d2ca3950fb5d358b09714c0bc3013.jpg
