MinhNhut223/Automated-Poultry-Farming-Machine/HinhAnh/z6175985623816_c94f6d3f9d52ea5da7471bce4ad5ae5d.jpg

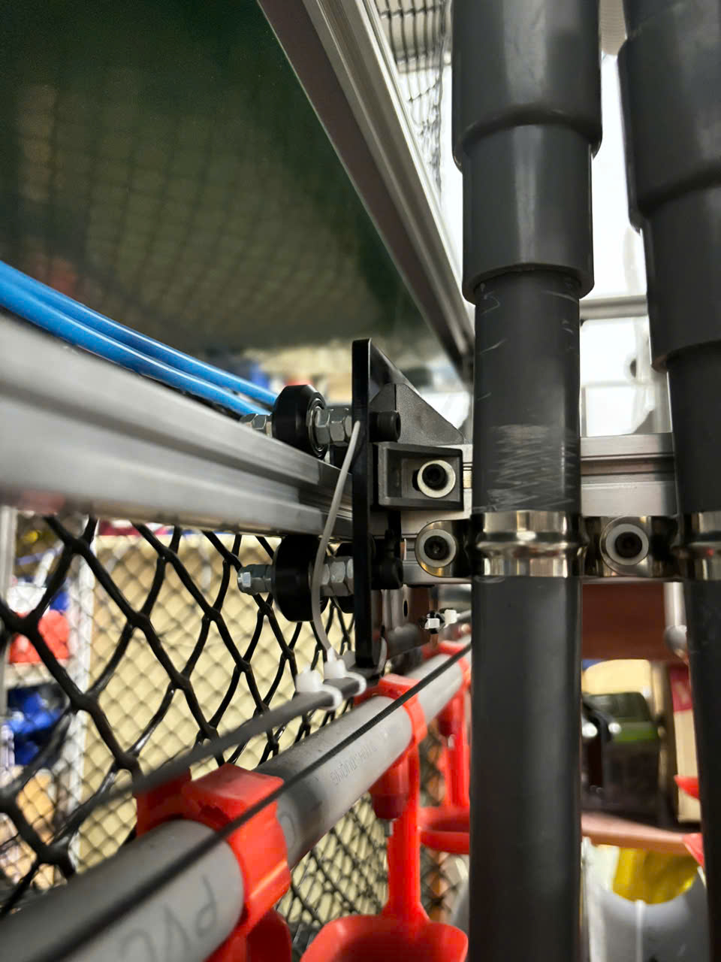
HinhAnh/z6175985623816_c94f6d3f9d52ea5da7471bce4ad5ae5d.jpg
