MinhNhut223/Automated-Poultry-Farming-Machine/HinhAnh/z6175986195078_cad02310e310b46676ffe9fb7b9901ec.jpg

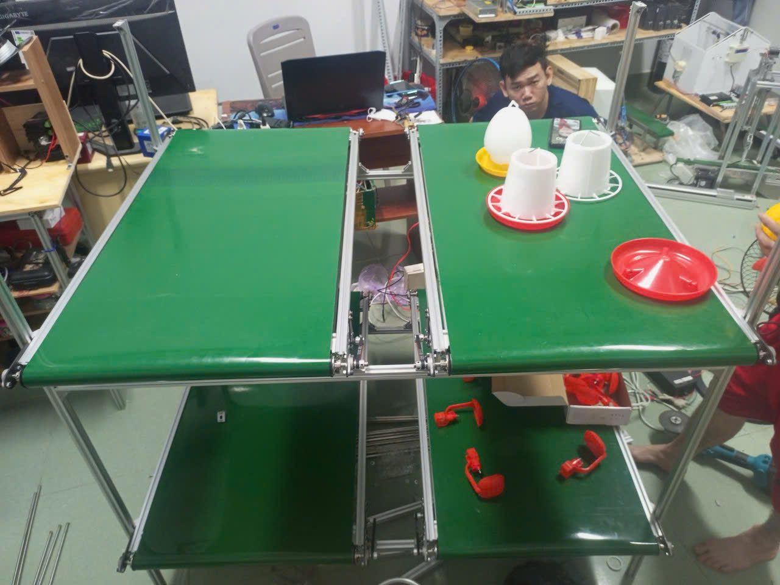
HinhAnh/z6175986195078_cad02310e310b46676ffe9fb7b9901ec.jpg
