MinhNhut223/Automated-Poultry-Farming-Machine/HinhAnh/z6175986197322_ae5d46eedf371baf78ecfcb012fe6f74.jpg

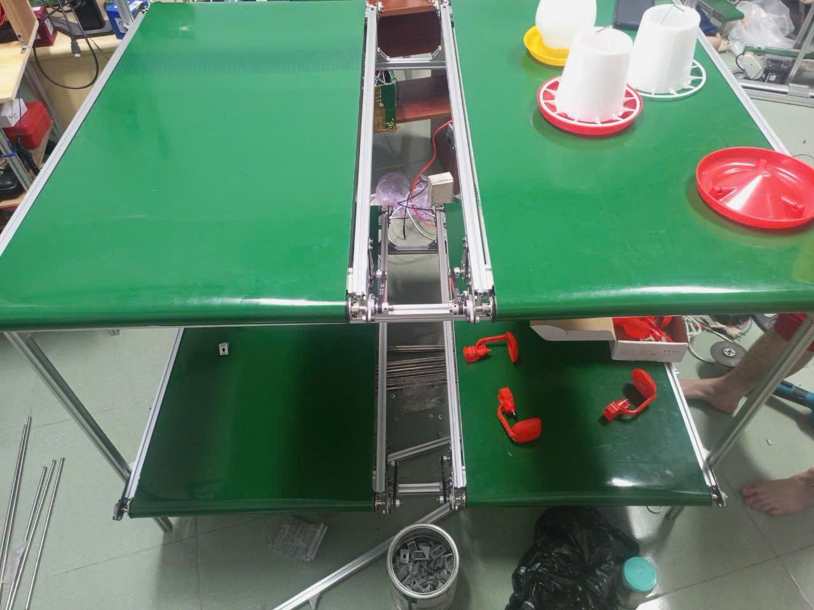
HinhAnh/z6175986197322_ae5d46eedf371baf78ecfcb012fe6f74.jpg
