MinhNhut223/Automated-Poultry-Farming-Machine/HinhAnh/z6175986197750_954cad96693ecf9ddb63daeb40de5900.jpg

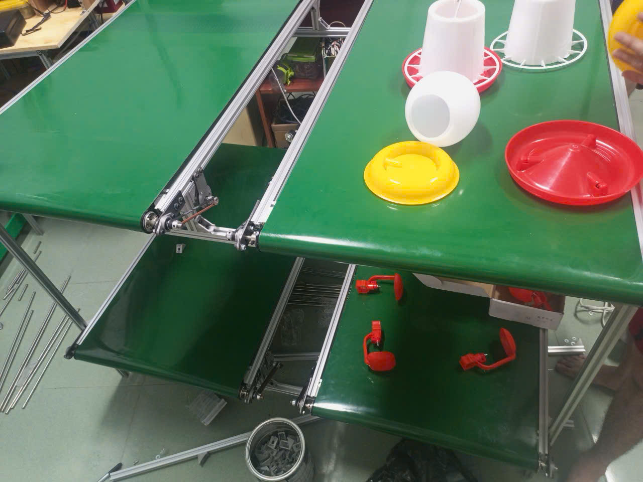
HinhAnh/z6175986197750_954cad96693ecf9ddb63daeb40de5900.jpg
