MinhNhut223/Automated-Poultry-Farming-Machine/HinhAnh/z6175986199265_552692ddbe54ad78f66dc20c59b46ce7.jpg

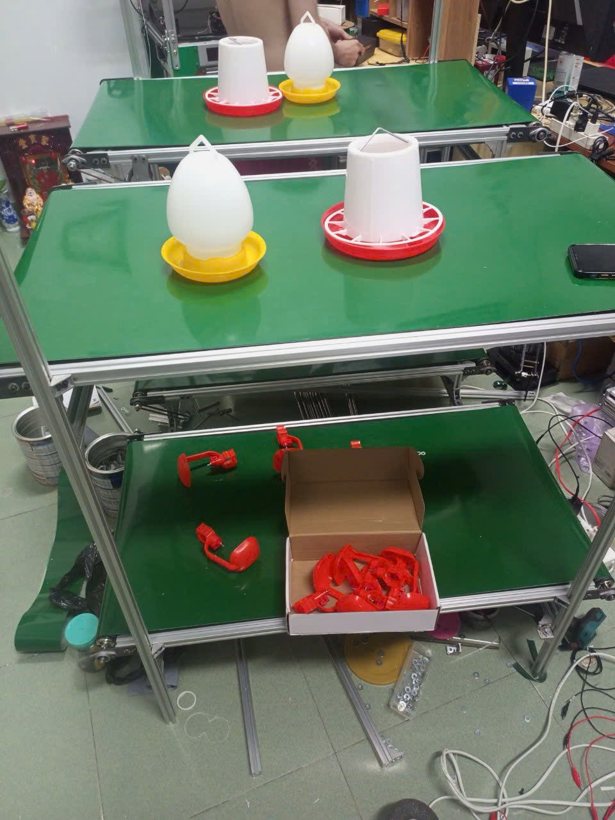
HinhAnh/z6175986199265_552692ddbe54ad78f66dc20c59b46ce7.jpg
