MinhNhut223/Automated-Poultry-Farming-Machine/HinhAnh/z6175986207404_664077bfcce8e5b64ab29852c66789bf.jpg

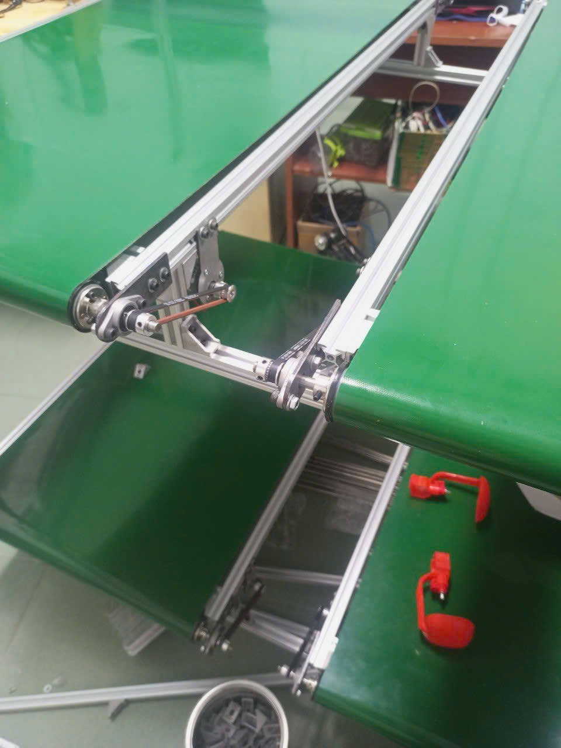
HinhAnh/z6175986207404_664077bfcce8e5b64ab29852c66789bf.jpg
