MinhNhut223/Automated-Poultry-Farming-Machine/HinhAnh/z6175986208022_e011ff081874fc2db4289617dfa2cf06.jpg

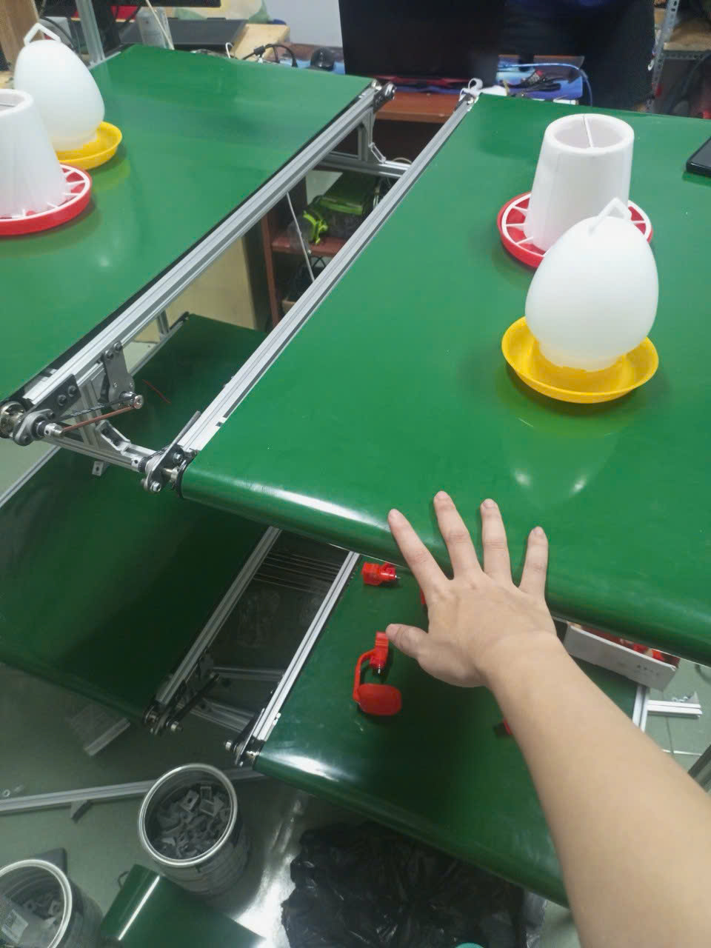
HinhAnh/z6175986208022_e011ff081874fc2db4289617dfa2cf06.jpg
