MinhNhut223/Automated-Poultry-Farming-Machine/HinhAnh/z6203705830008_c08bd596902ccff51ce6e4a904293440.jpg

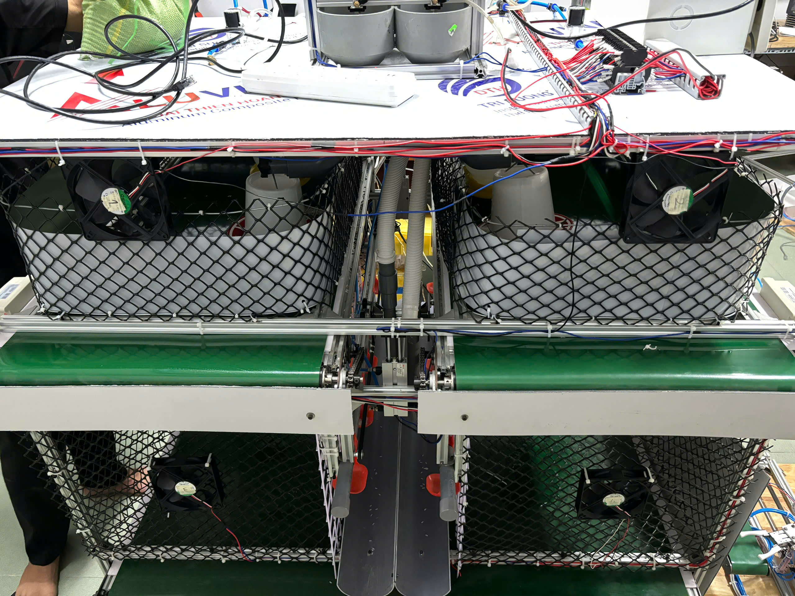
HinhAnh/z6203705830008_c08bd596902ccff51ce6e4a904293440.jpg
