MinhNhut223/Automated-Poultry-Farming-Machine/HinhAnh/z6203705830009_9e08e3556d0b65a6c82757ca12a4472c.jpg

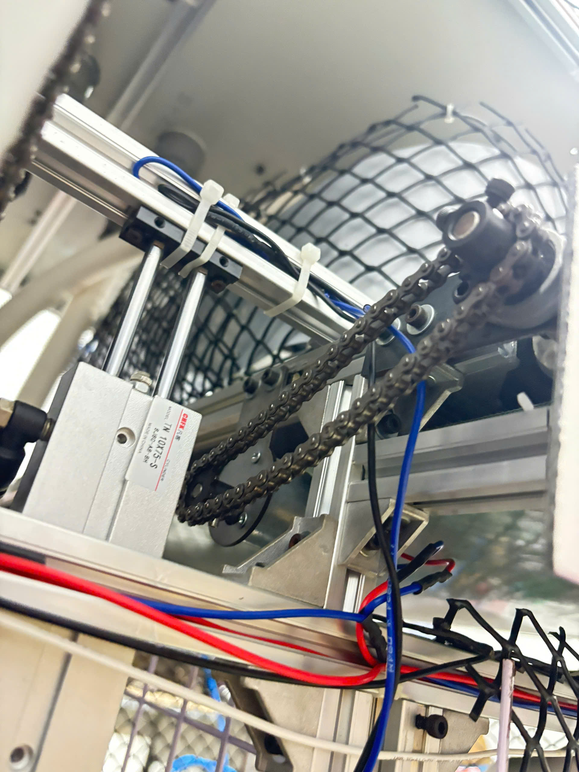
HinhAnh/z6203705830009_9e08e3556d0b65a6c82757ca12a4472c.jpg
