MinhNhut223/Automated-Poultry-Farming-Machine/HinhAnh/z6203705830010_fb7a308fda7bdcaefb058e98c608ee8b.jpg

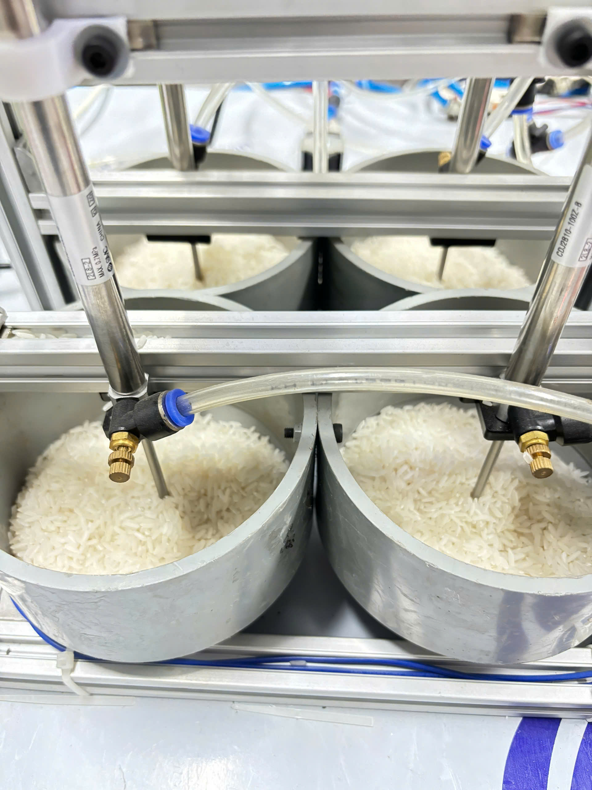
HinhAnh/z6203705830010_fb7a308fda7bdcaefb058e98c608ee8b.jpg
