MinhNhut223/Automated-Poultry-Farming-Machine/HinhAnh/z6203705830460_16ed2099a5f639fa446e1a28b4ee799f.jpg

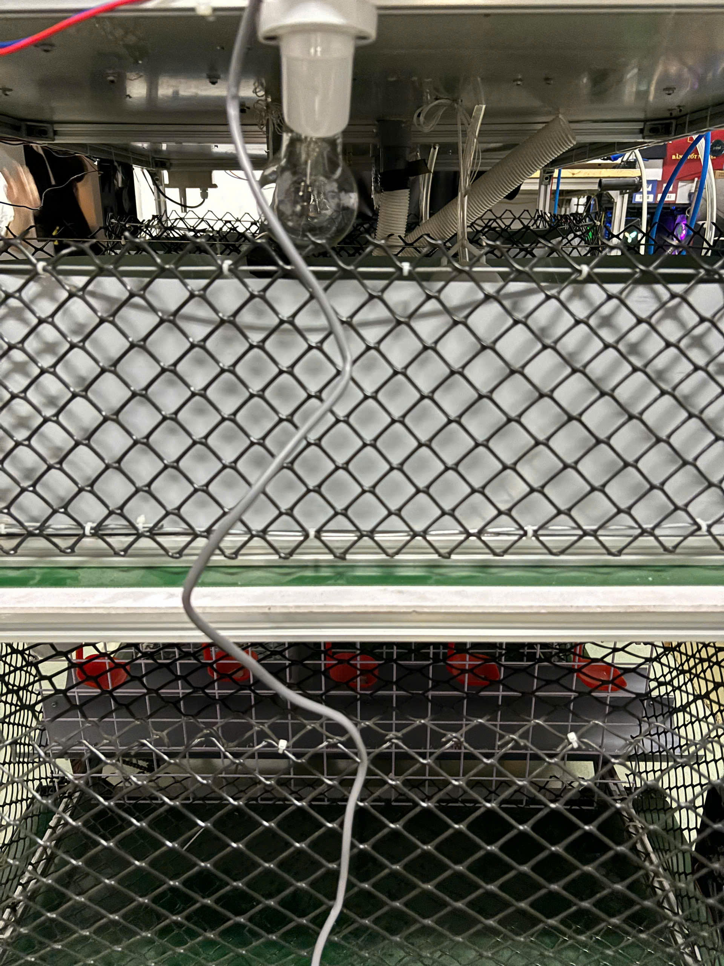
HinhAnh/z6203705830460_16ed2099a5f639fa446e1a28b4ee799f.jpg
