MinhNhut223/Automated-Poultry-Farming-Machine/HinhAnh/z6203705835590_263ccfd5a4e08e3ba379bd19c54865cc.jpg

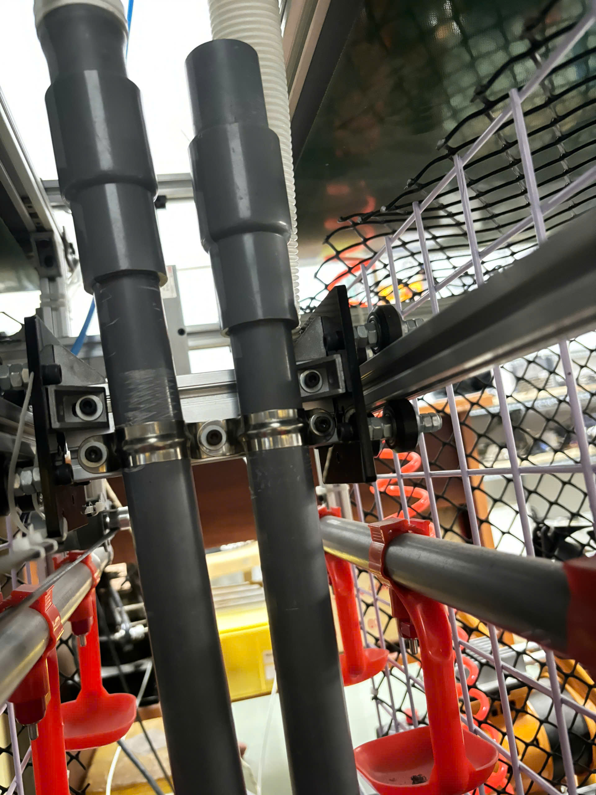
HinhAnh/z6203705835590_263ccfd5a4e08e3ba379bd19c54865cc.jpg
