MinhNhut223/Automated-Poultry-Farming-Machine/HinhAnh/z6203705835791_cddcb8f88e2031293794924304c519c4.jpg

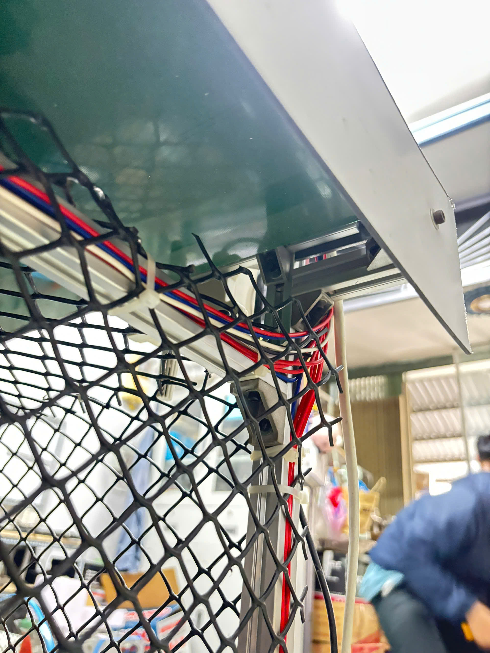
HinhAnh/z6203705835791_cddcb8f88e2031293794924304c519c4.jpg
