MinhNhut223/Automated-Poultry-Farming-Machine/HinhAnh/z6203705835792_c690b186209888b516f0a61a6bd865b2.jpg

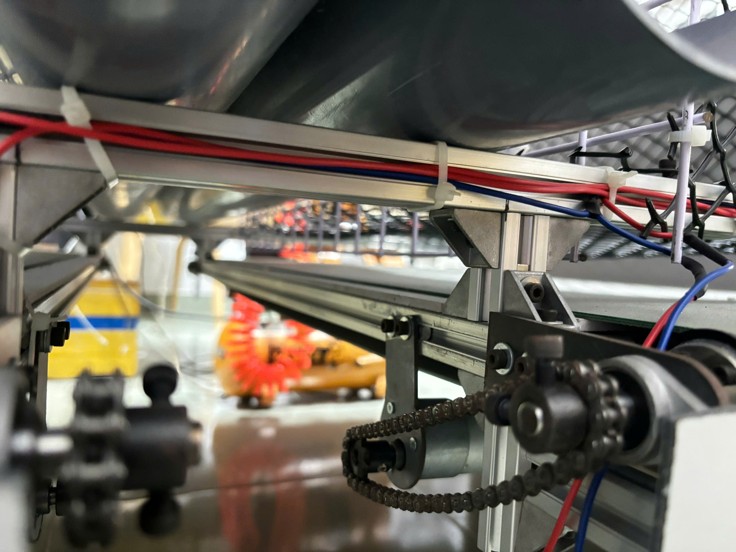
HinhAnh/z6203705835792_c690b186209888b516f0a61a6bd865b2.jpg
