MinhNhut223/Automated-Poultry-Farming-Machine/HinhAnh/z6203705838537_271d74e0b1460745cacf8c31b6496656.jpg

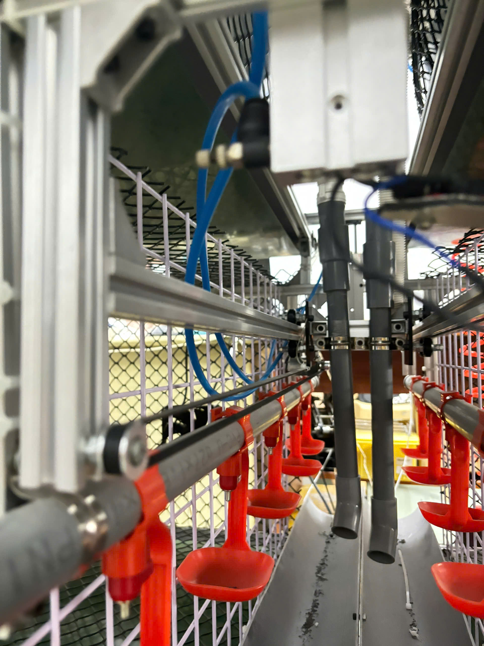
HinhAnh/z6203705838537_271d74e0b1460745cacf8c31b6496656.jpg
