MinhNhut223/Automated-Poultry-Farming-Machine/HinhAnh/z6203705838627_fcbb581a2e3909b1268e37fdecee727e.jpg

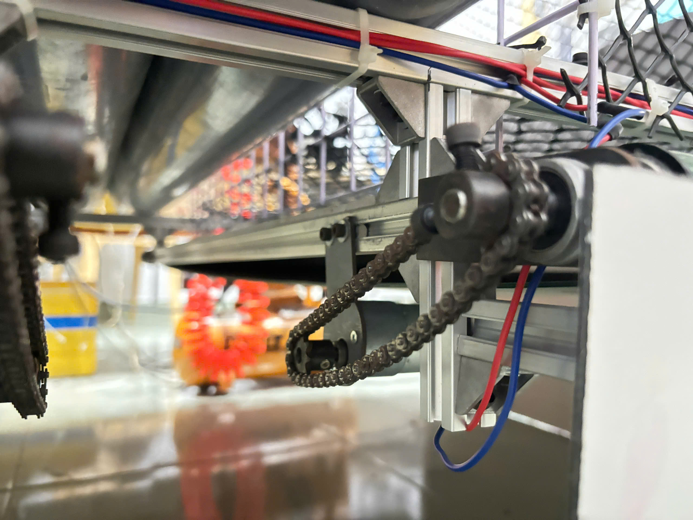
HinhAnh/z6203705838627_fcbb581a2e3909b1268e37fdecee727e.jpg
