MinhNhut223/Automated-Poultry-Farming-Machine/HinhAnh/z6203705839928_d98f24721bfacda6181a50f91a54752f.jpg

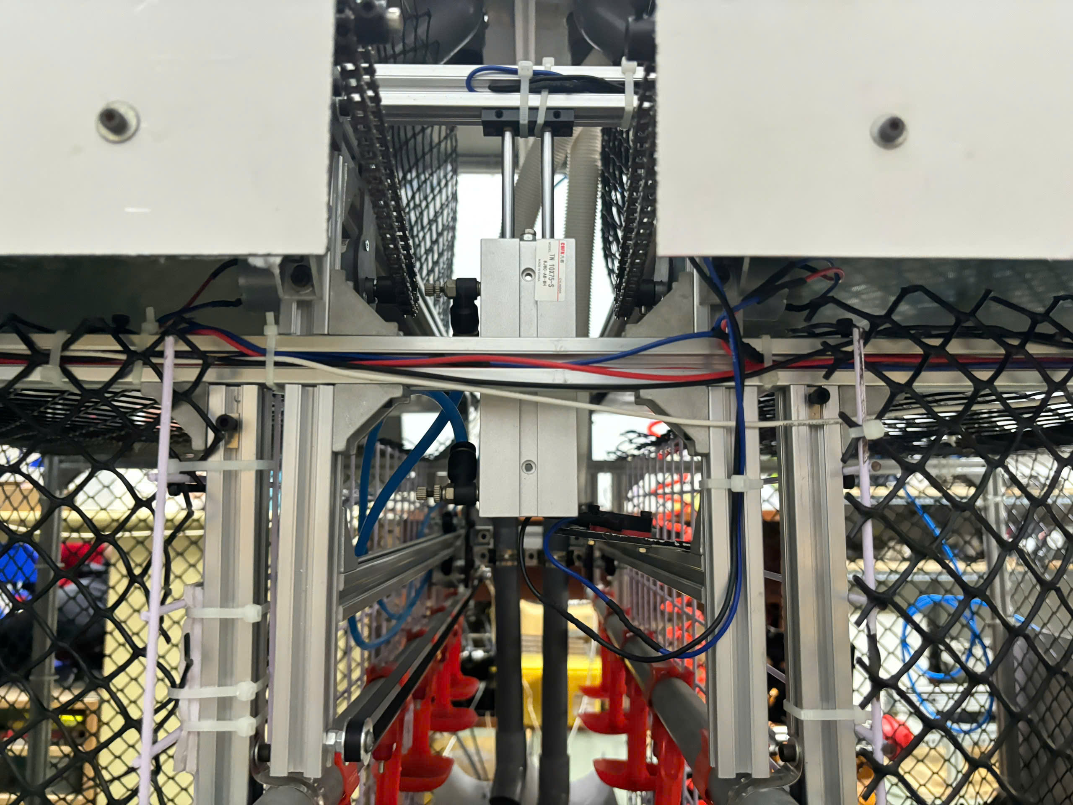
HinhAnh/z6203705839928_d98f24721bfacda6181a50f91a54752f.jpg
