MinhNhut223/Automated-Poultry-Farming-Machine/HinhAnh/z6203705840489_a688f27da2d7c23dc83da3507d9b75e5.jpg

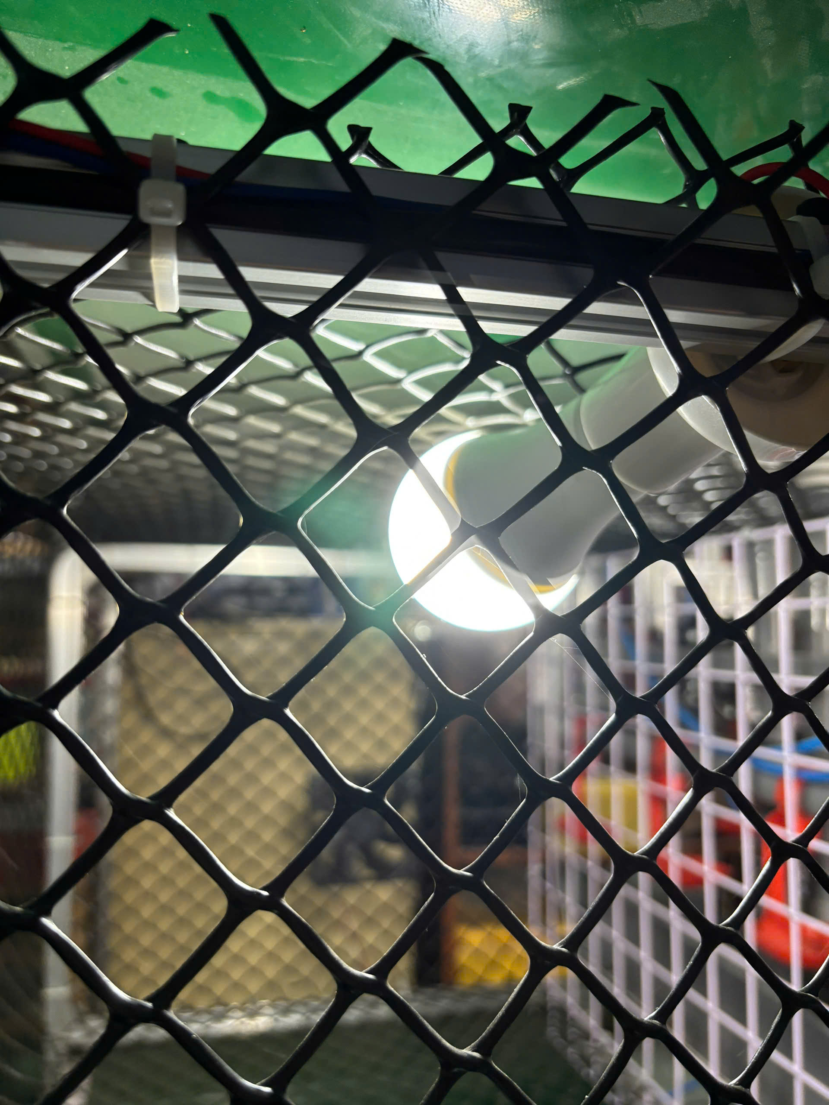
HinhAnh/z6203705840489_a688f27da2d7c23dc83da3507d9b75e5.jpg
