MinhNhut223/Automated-Poultry-Farming-Machine/HinhAnh/z6203705841143_1040e7198baaeded31812c200c242708.jpg

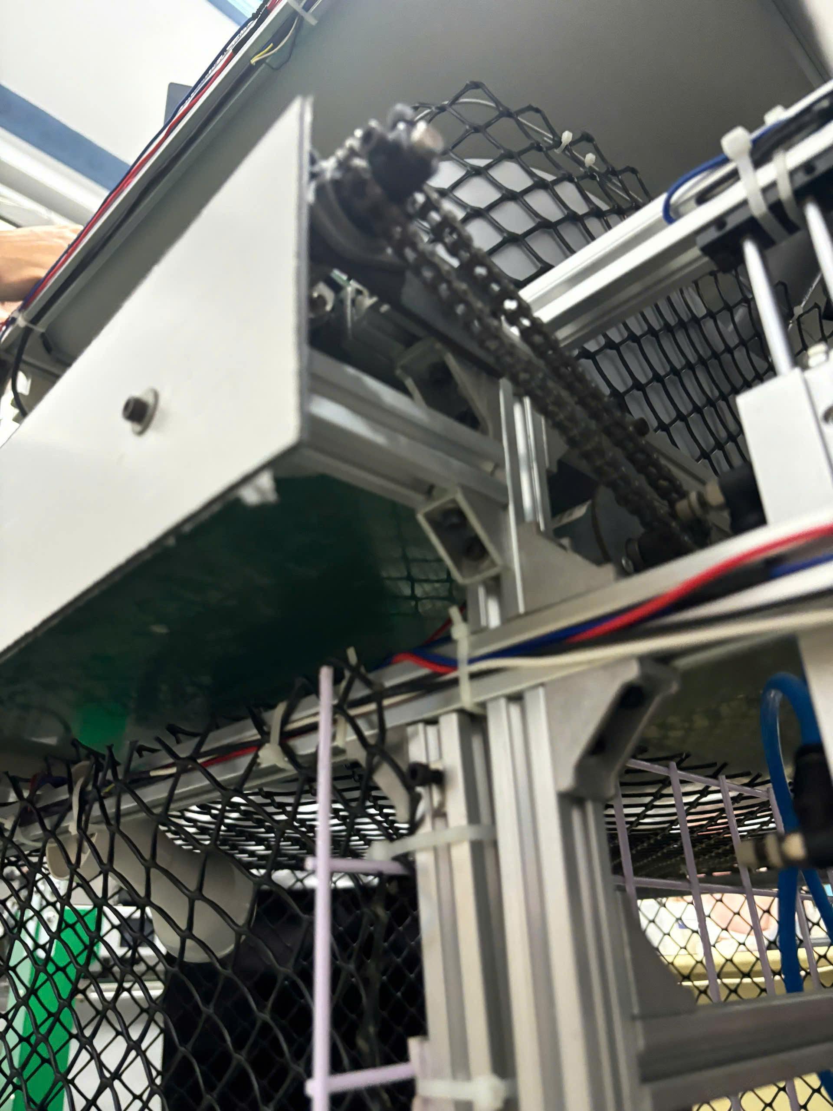
HinhAnh/z6203705841143_1040e7198baaeded31812c200c242708.jpg
