MinhNhut223/Automated-Poultry-Farming-Machine/chuongga/AIRTAC_TN10X60S0/SOLIDWORKS/TN10X50S(0)+().sldasm

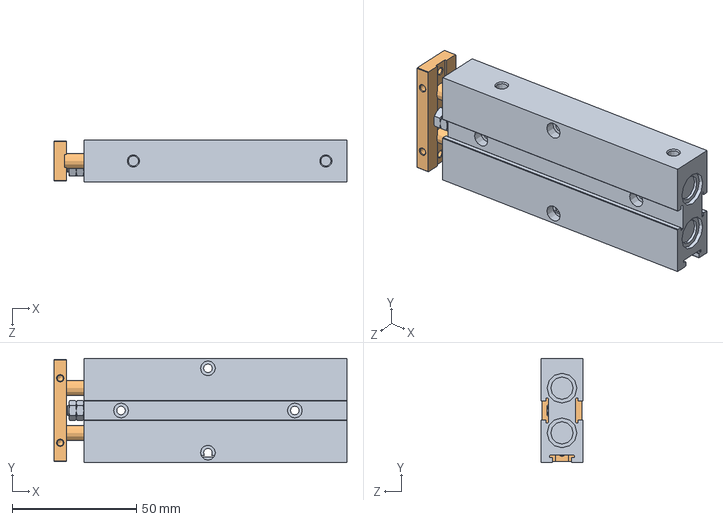
[picture p106: CAD file, 2025-04-01]
chuongga/AIRTAC_TN10X60S0/SOLIDWORKS/TN10X50S(0)+().sldasm
118.0 x 42.0 x 17.0 mm
TN10-60 - 60_b
TN10-60_fp
