MinhNhut223/Automated-Poultry-Farming-Machine/chuongga/betruot/Assem3.SLDASM

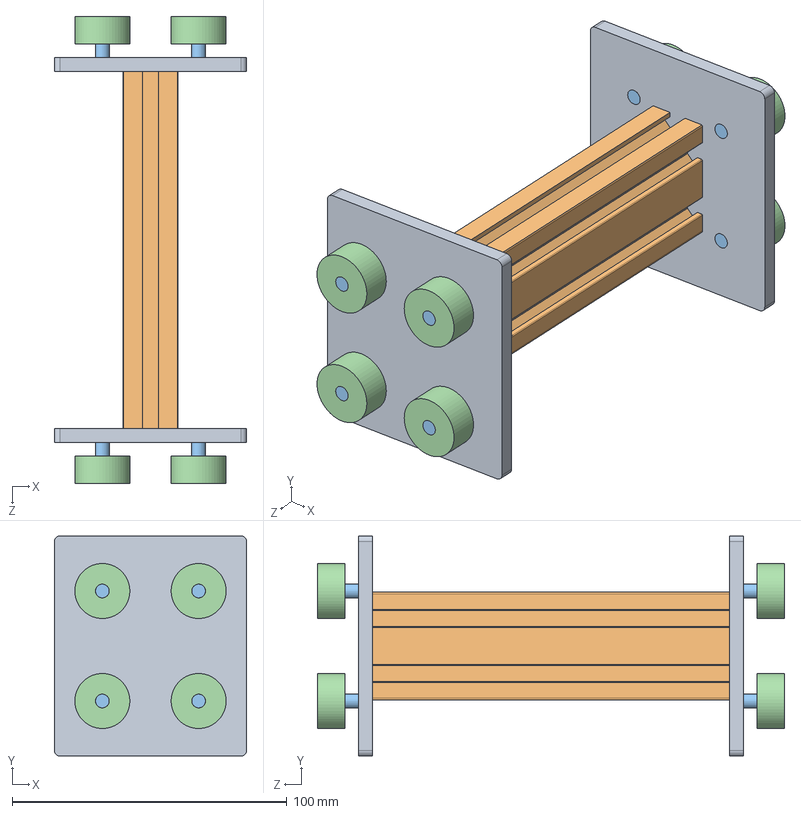
[picture p107: CAD file, 2025-04-01]
chuongga/betruot/Assem3.SLDASM
70.0 x 80.0 x 170.0 mm
padtruot x 2
nhom2040
ti5 x 8
banhxe x 8
