MinhNhut223/Automated-Poultry-Farming-Machine/chuongga/tudein/Assem4.SLDASM

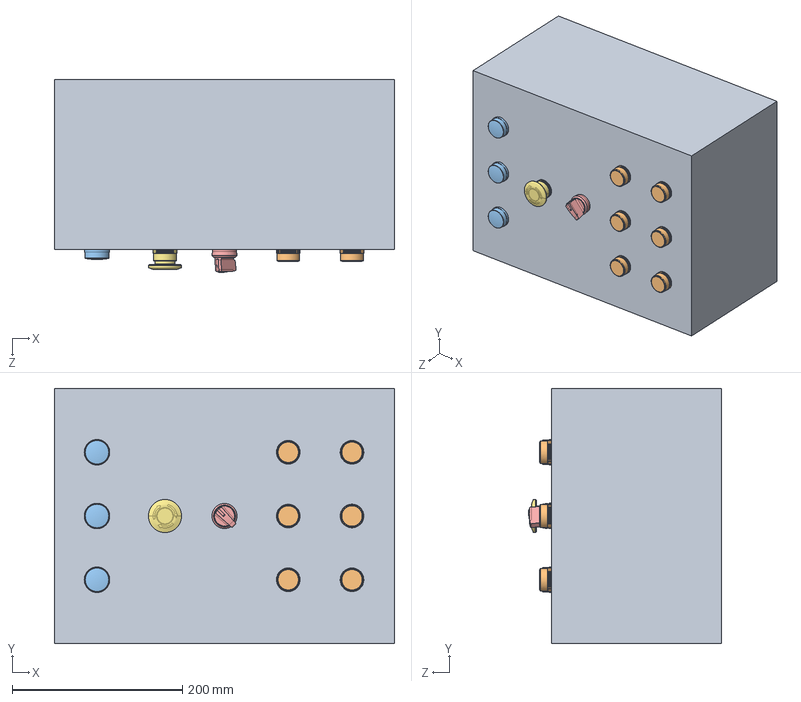
[picture p108: CAD file, 2025-04-01]
chuongga/tudein/Assem4.SLDASM
400.0 x 300.0 x 227.5 mm
tu
abb_CB1-603G_Green Compact Buzzer_1 x 3
abb_CB1-603G_Green Compact Buzzer_2 x 3
Imported.STEP
Imported_2.STEP
Imported_3.STEP
Imported_4.STEP
Imported_5.STEP x 4
Imported_6.STEP x 4
Imported_4xanh x 6
3SU11502BC601BA0_PART1
3SU11502BC601BA0_PART2
3SU11502BC601BA0_PART3
