MinhNhut223/Automated-Poultry-Farming-Machine/chuongga/bangtai/Assem1.SLDASM

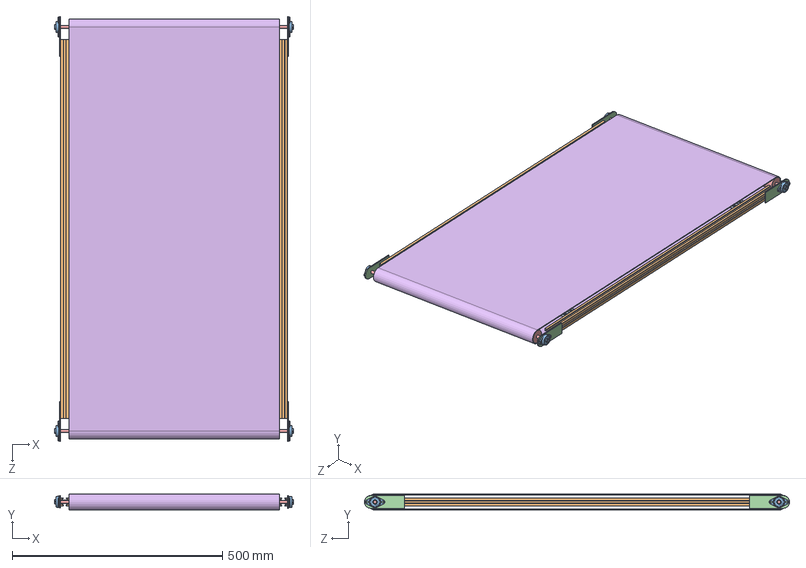
[picture p109: CAD file, 2025-04-01]
chuongga/bangtai/Assem1.SLDASM
567.9 x 38.0 x 1010.0 mm
nhom50 x 2
nhom90 x 2
KFL08 x 4
rulo x 2
Belt2-7^Assem1
