MinhNhut223/Automated-Poultry-Farming-Machine/chuongga/tudein/nutnhanxanh/nutxanh.SLDASM

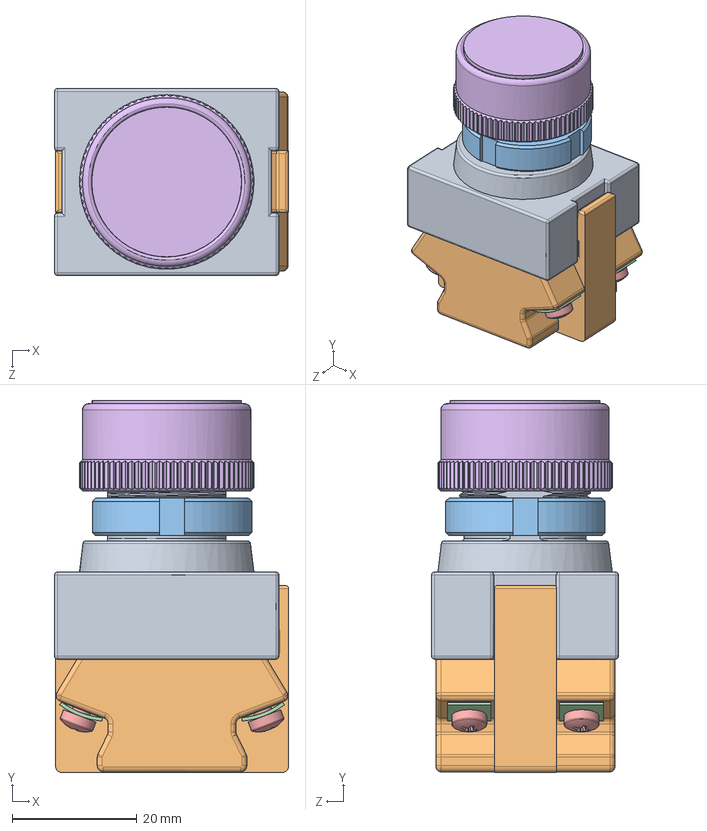
[picture p110: CAD file, 2025-04-01]
chuongga/tudein/nutnhanxanh/nutxanh.SLDASM
37.5 x 59.7 x 30.0 mm
Imported
Imported_2
Imported_3
Imported_5 x 4
Imported_6 x 4
Imported_4xanh
