MinhNhut223/Automated-Poultry-Farming-Machine/chuongga/AIRTAC_TN10X60S0/SOLIDWORKS/TN10X60S(0)+().sldasm

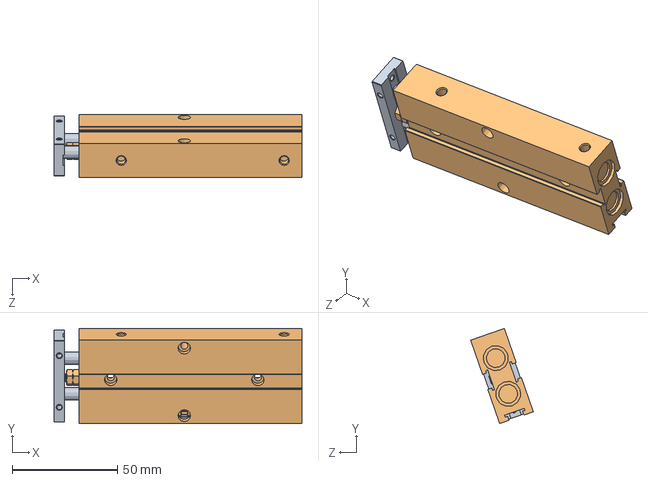
[picture p111: CAD file, 2025-04-01]
chuongga/AIRTAC_TN10X60S0/SOLIDWORKS/TN10X60S(0)+().sldasm
118.0 x 45.3 x 29.9 mm
TN10-60_fp
TN10-60 - 60_b
