MinhNhut223/Automated-Poultry-Farming-Machine/chuongga/20x10.SLDPRT

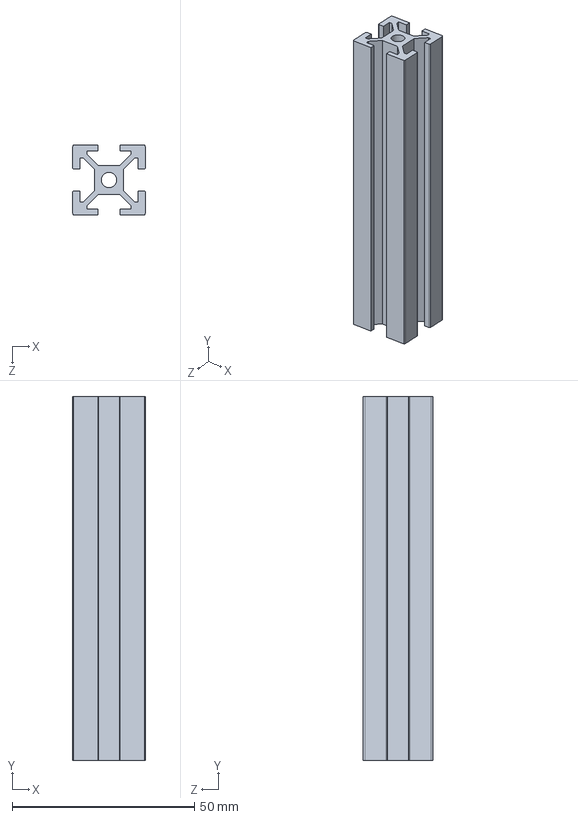
[picture p112: CAD file, 2025-04-01]
chuongga/20x10.SLDPRT
20.0 x 100.0 x 19.2 mm
