MinhNhut223/Automated-Poultry-Farming-Machine/chuongga/bangtai/nhom90.SLDPRT

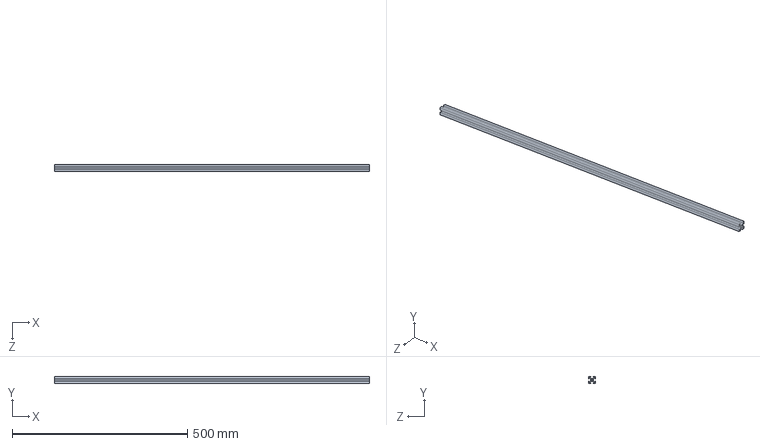
[picture p113: CAD file, 2025-04-01]
chuongga/bangtai/nhom90.SLDPRT
900.0 x 20.0 x 19.2 mm
