MinhNhut223/Automated-Poultry-Farming-Machine/chuongga/fan-12025mbk.step/fan-12025mbk.STEP

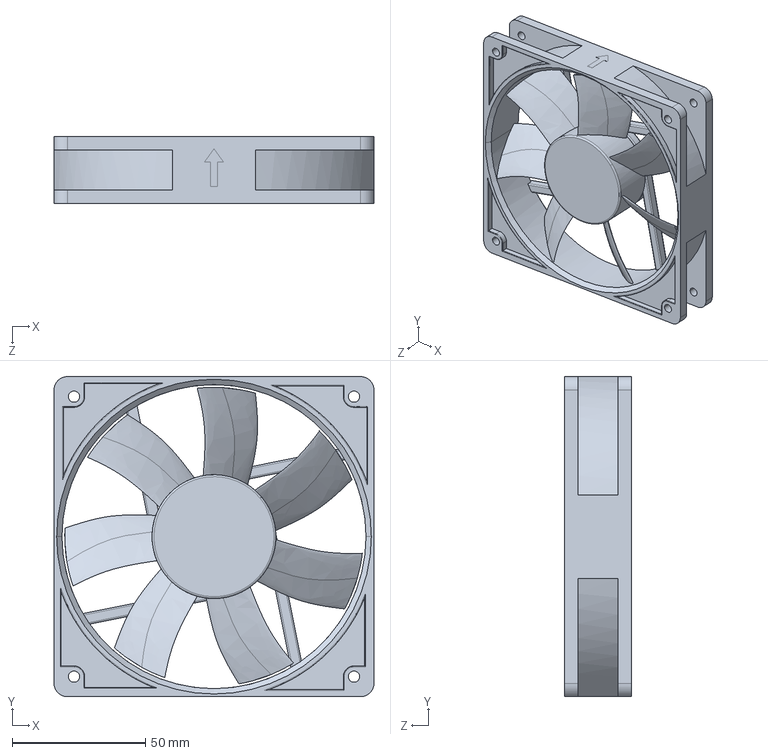
[picture p114: CAD file, 2025-04-01]
chuongga/fan-12025mbk.step/fan-12025mbk.STEP
120.0 x 120.1 x 25.0 mm
