MinhNhut223/Automated-Poultry-Farming-Machine/chuongga/tudein/nutnhanxanh/Imported_4xanh.SLDPRT

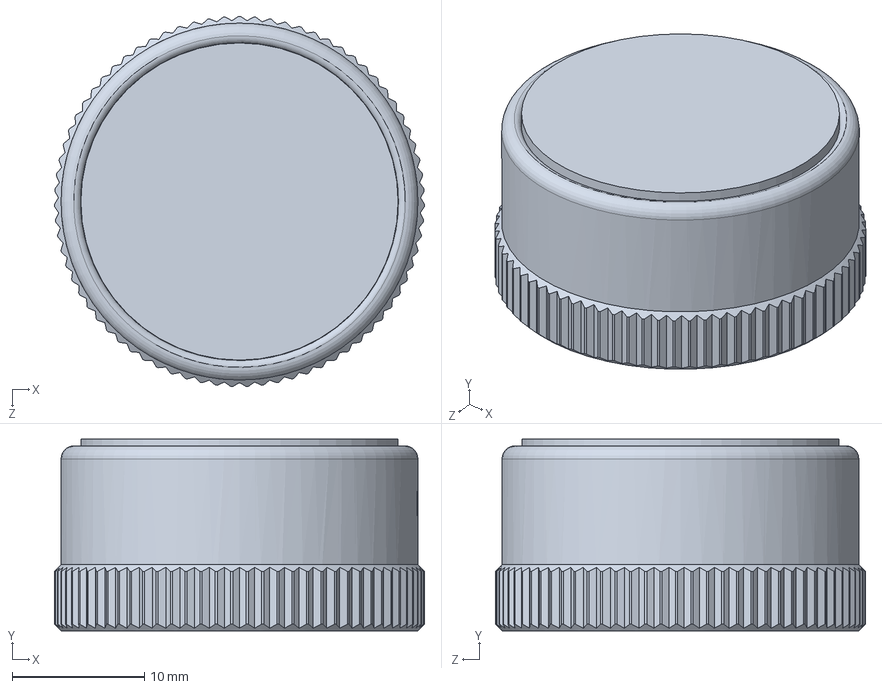
[picture p115: CAD file, 2025-04-01]
chuongga/tudein/nutnhanxanh/Imported_4xanh.SLDPRT
28.0 x 14.5 x 28.0 mm
