MinhNhut223/Automated-Poultry-Farming-Machine/chuongga/betruot/nhom2040.SLDPRT

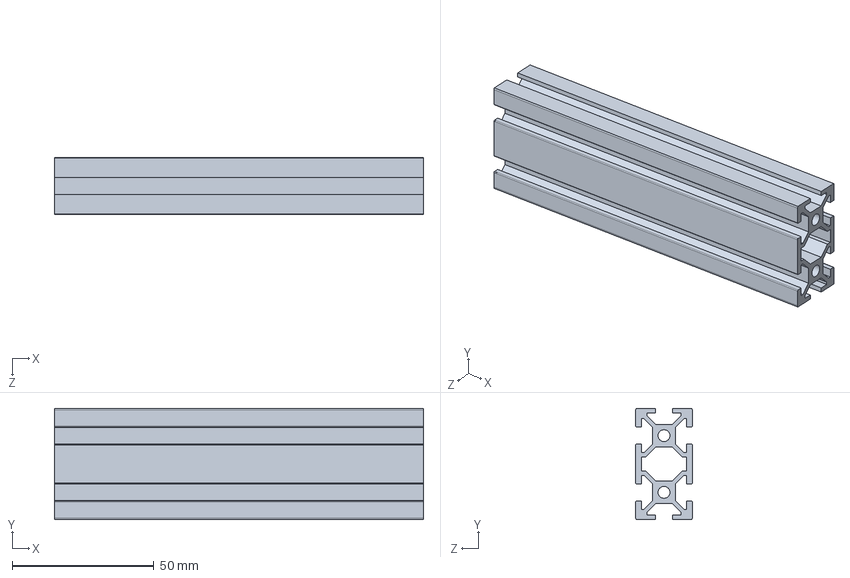
[picture p116: CAD file, 2025-04-01]
chuongga/betruot/nhom2040.SLDPRT
130.0 x 39.2 x 20.0 mm
