MinhNhut223/Automated-Poultry-Farming-Machine/chuongga/chan.SLDPRT

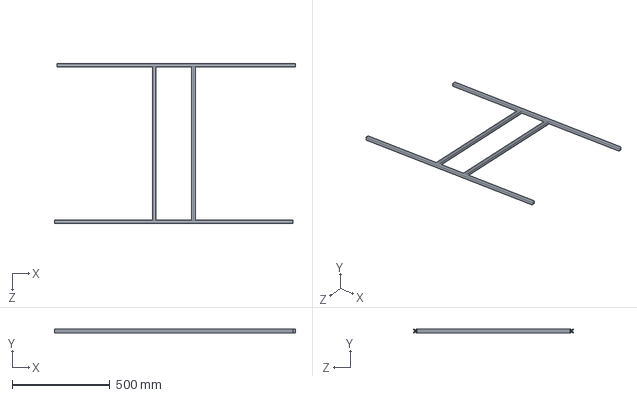
[picture p117: CAD file, 2025-04-01]
chuongga/chan.SLDPRT
1231.7 x 19.2 x 820.0 mm
