MinhNhut223/Automated-Poultry-Farming-Machine/chuongga/tudein/tu.SLDPRT

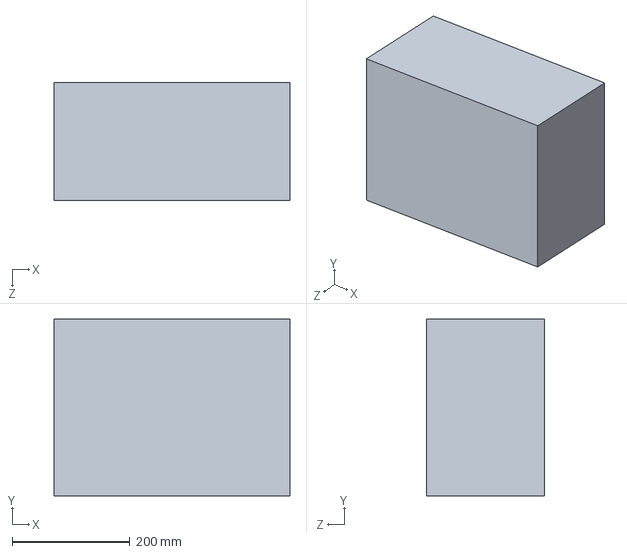
[picture p118: CAD file, 2025-04-01]
chuongga/tudein/tu.SLDPRT
400.0 x 300.0 x 200.0 mm
