MinhNhut223/Automated-Poultry-Farming-Machine/chuongga/bangtai/rulo.SLDPRT

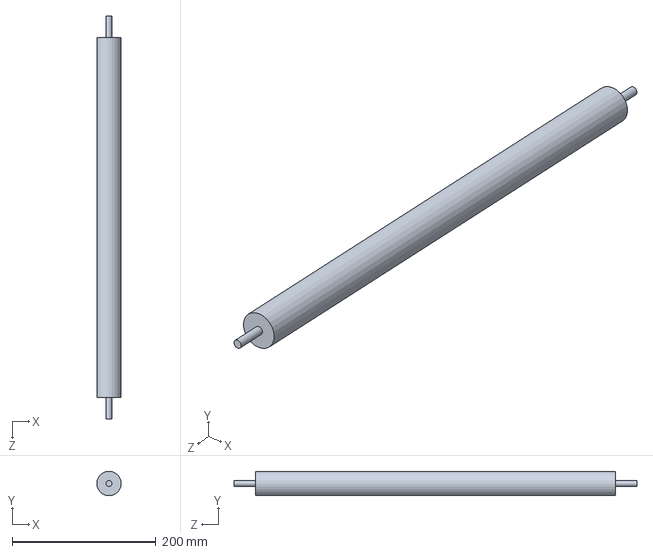
[picture p119: CAD file, 2025-04-01]
chuongga/bangtai/rulo.SLDPRT
34.0 x 34.0 x 560.0 mm
