MinhNhut223/Automated-Poultry-Farming-Machine/chuongga/betruot/ti5.SLDPRT

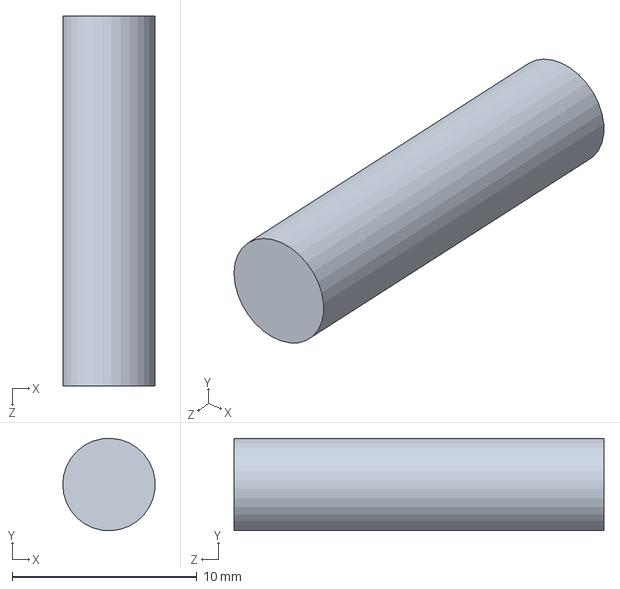
[picture p120: CAD file, 2025-04-01]
chuongga/betruot/ti5.SLDPRT
5.00 x 4.99 x 20.0 mm
