MinhNhut223/Automated-Poultry-Farming-Machine/chuongga/pheu.SLDPRT

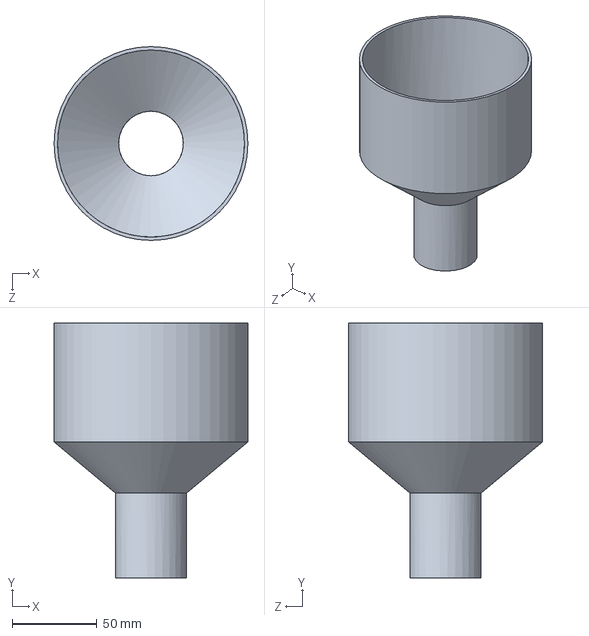
[picture p121: CAD file, 2025-04-01]
chuongga/pheu.SLDPRT
114.0 x 150.0 x 114.0 mm
