MinhNhut223/Automated-Poultry-Farming-Machine/chuongga/bangtai/KFL08 .SLDPRT

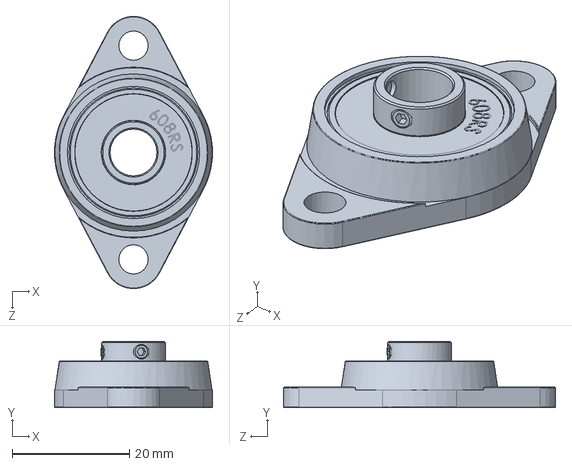
[picture p122: CAD file, 2025-04-01]
chuongga/bangtai/KFL08 .SLDPRT
27.0 x 11.4 x 46.5 mm
