MinhNhut223/Automated-Poultry-Farming-Machine/chuongga/betruot/banhxe.SLDPRT

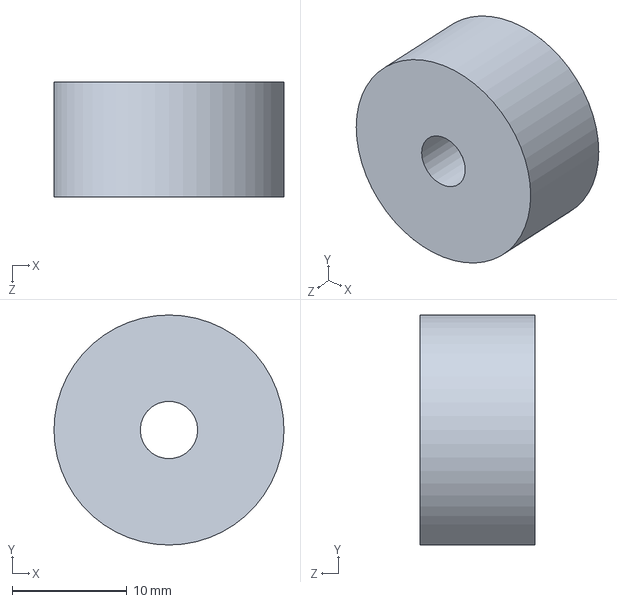
[picture p123: CAD file, 2025-04-01]
chuongga/betruot/banhxe.SLDPRT
20.0 x 20.0 x 10.0 mm
