MinhNhut223/Automated-Poultry-Farming-Machine/chuongga/nap.SLDPRT

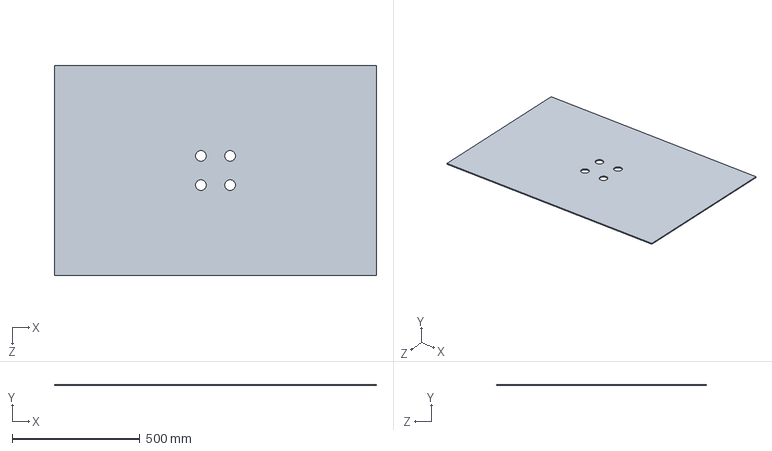
[picture p124: CAD file, 2025-04-01]
chuongga/nap.SLDPRT
1260.0 x 5.00 x 820.0 mm
