MinhNhut223/Automated-Poultry-Farming-Machine/chuongga/bangtai/pad.SLDPRT

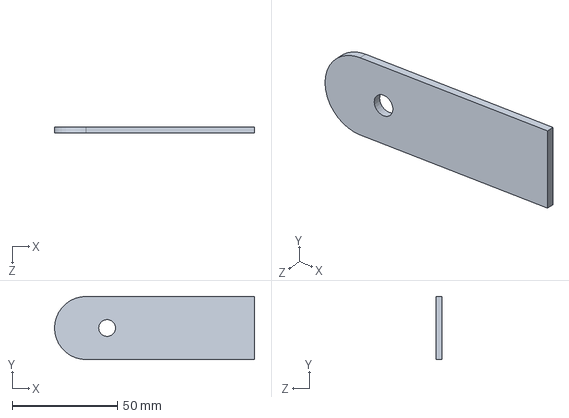
[picture p125: CAD file, 2025-04-01]
chuongga/bangtai/pad.SLDPRT
95.0 x 30.0 x 3.00 mm
