MinhNhut223/Automated-Poultry-Farming-Machine/chuongga/betruot/padtruot.SLDPRT

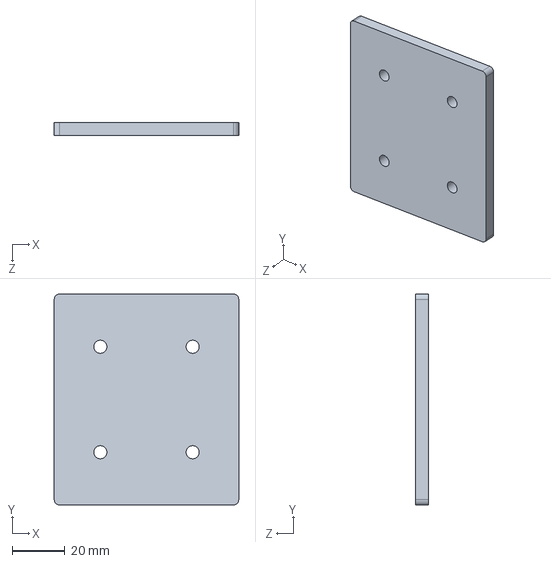
[picture p126: CAD file, 2025-04-01]
chuongga/betruot/padtruot.SLDPRT
70.0 x 80.0 x 5.00 mm
