MinhNhut223/Automated-Poultry-Farming-Machine/chuongga/ongthucan.SLDPRT

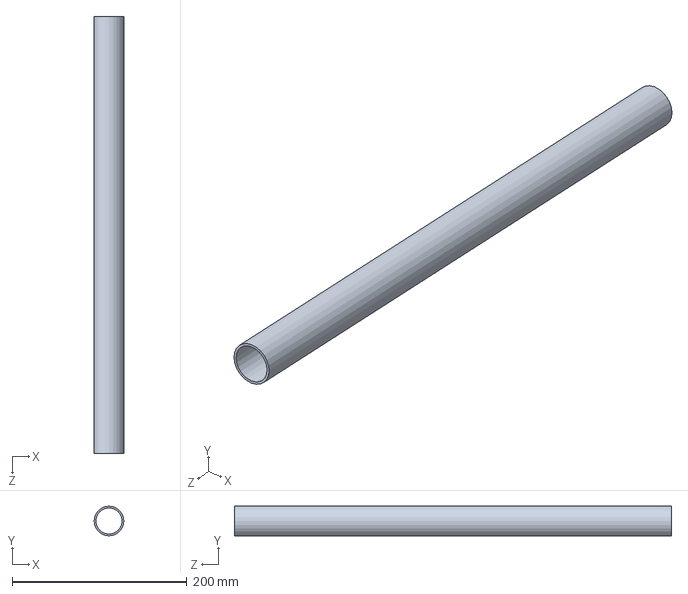
[picture p127: CAD file, 2025-04-01]
chuongga/ongthucan.SLDPRT
34.0 x 34.0 x 500.0 mm
