MinhNhut223/Automated-Poultry-Farming-Machine/chuongga/bangtai/nhom50.SLDPRT

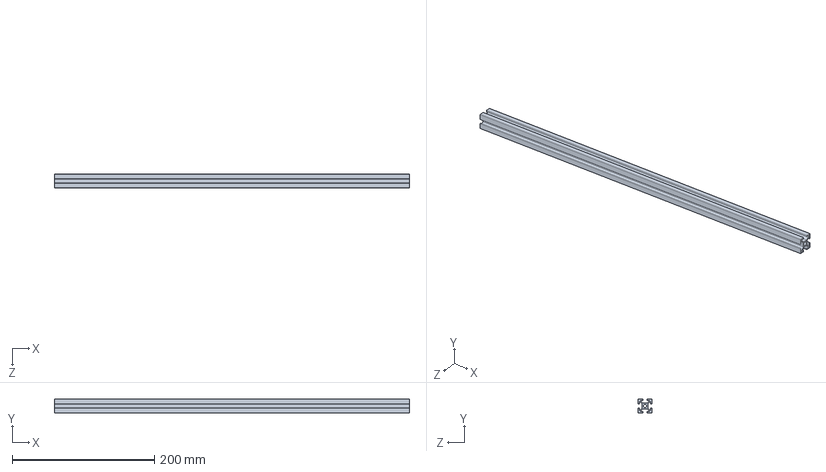
[picture p128: CAD file, 2025-04-01]
chuongga/bangtai/nhom50.SLDPRT
500.0 x 20.0 x 19.2 mm
