MinhNhut223/Automated-Poultry-Farming-Machine/chuongga/ongnuoc.SLDPRT

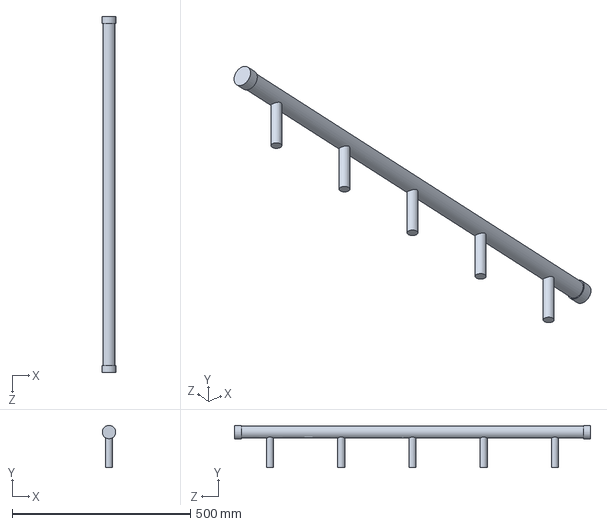
[picture p129: CAD file, 2025-04-01]
chuongga/ongnuoc.SLDPRT
38.0 x 119.0 x 1000.0 mm
