MinhNhut223/Automated-Poultry-Farming-Machine/chuongga/khungpheu.SLDPRT

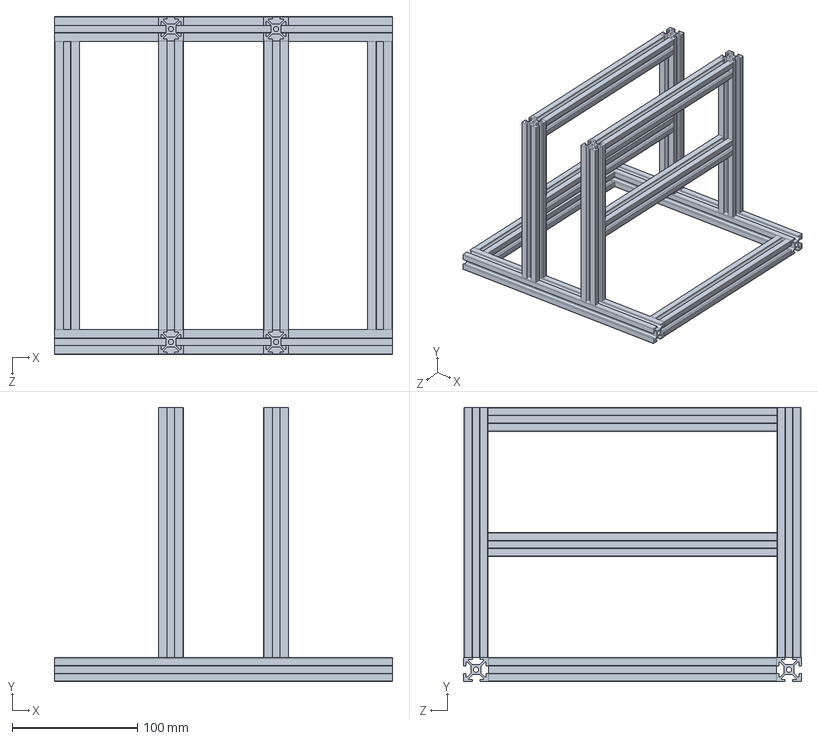
[picture p130: CAD file, 2025-04-01]
chuongga/khungpheu.SLDPRT
270.0 x 219.2 x 270.0 mm
