MinhNhut223/Automated-Poultry-Farming-Machine/chuongga/khung.SLDPRT

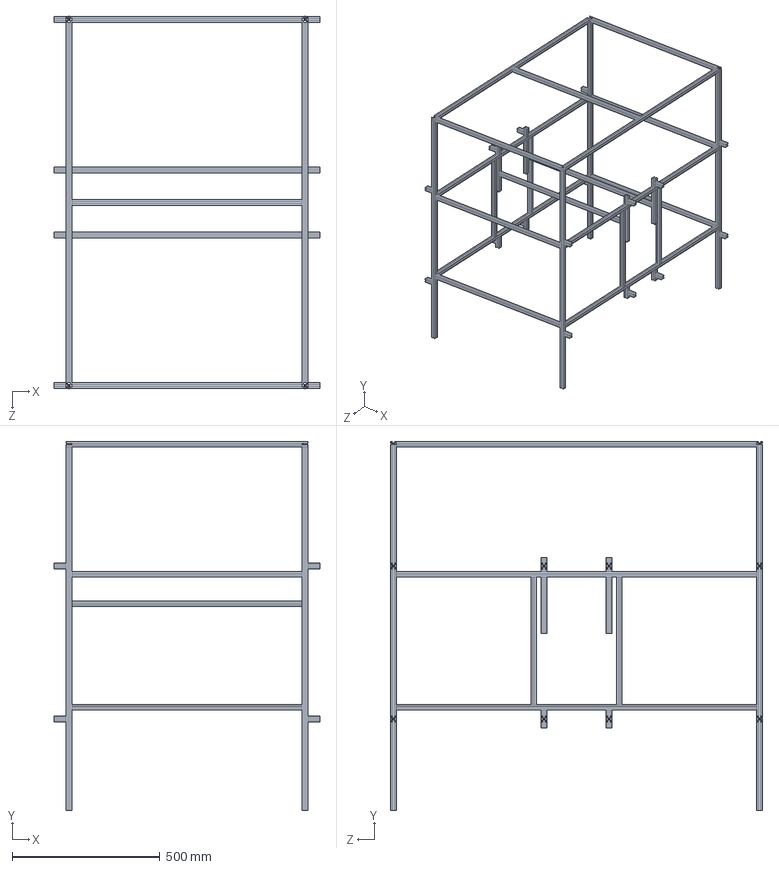
[picture p131: CAD file, 2025-04-01]
chuongga/khung.SLDPRT
900.0 x 1249.6 x 1260.0 mm
