MinhNhut223/Automated-Poultry-Farming-Machine/chuongga/mangnhua.SLDPRT

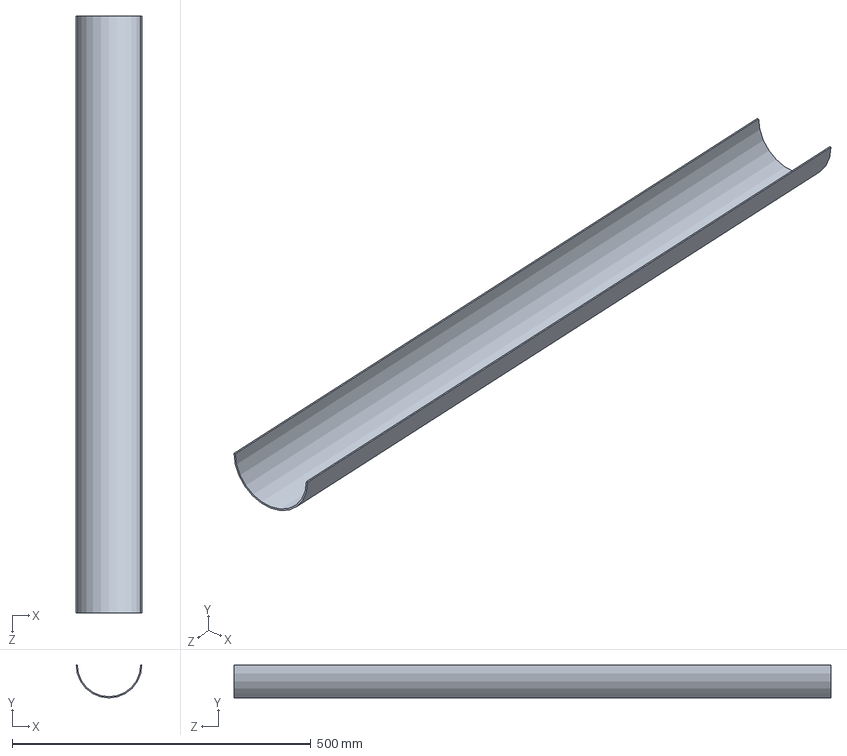
[picture p132: CAD file, 2025-04-01]
chuongga/mangnhua.SLDPRT
110.0 x 55.0 x 1000.0 mm
