MinhNhut223/Automated-Poultry-Farming-Machine/(list of files, cad)

Other CAD files:
chuongga/3dfindit-Festo-2418_EG-12-80---_80_0_-22024110408430313512059d0b6156e/SOLIDWORKS/2418 EG-12-80---(80_0).sldasm
chuongga/tudein/3dfindit-ABB_Low_Voltage___Systems-abb_1SFA619600R6032_CB1-603G_Buzzer-22024101917225392444267d0b6156e/SOLIDWORKS/abb_1SFA619600R6032_CB1-603G Buzzer.sldasm
chuongga/tudein/3dfindit-Siemens_Industry-3SU11502BC601BA0-22024110405584059557500d0b6156e/SOLIDWORKS/3SU11502BC601BA0.sldasm
chuongga/tudein/3dfindit-ABB_Low_Voltage___Systems-abb_1SFA619600R6032_CB1-603G_Buzzer-22024101917225392444267d0b6156e/SOLIDWORKS/abb_CB1-603G_Green Compact Buzzer_1.sldprt
chuongga/tudein/3dfindit-Siemens_Industry-3SU11502BC601BA0-22024110405584059557500d0b6156e/SOLIDWORKS/3SU11502BC601BA0_PART2.sldprt
chuongga/3dfindit-Festo-2418_EG-12-80---_80_0_-22024110408430313512059d0b6156e/SOLIDWORKS/2418 EG-12-80---(80_KS).sldprt
chuongga/AIRTAC_TN10X60S0/SOLIDWORKS/TN10-60_fp.sldprt
chuongga/3dfindit-Festo-2418_EG-12-80---_80_0_-22024110408430313512059d0b6156e/SOLIDWORKS/2418 EG-12-80---(ZR_80_0).sldprt
chuongga/tudein/3dfindit-ABB_Low_Voltage___Systems-abb_1SFA619600R6032_CB1-603G_Buzzer-22024101917225392444267d0b6156e/SOLIDWORKS/abb_CB1-603G_Green Compact Buzzer_2.sldprt
chuongga/tudein/3dfindit-Siemens_Industry-3SU11502BC601BA0-22024110405584059557500d0b6156e/SOLIDWORKS/3SU11502BC601BA0_PART3.sldprt
chuongga/3dfindit-Festo-2418_EG-12-80---_80_0_-22024110408430313512059d0b6156e/SOLIDWORKS/2418 EG-12-80-(N).sldprt
chuongga/AIRTAC_TN10X60S0/SOLIDWORKS/TN10-60 - 60_b.sldprt
chuongga/tudein/3dfindit-Siemens_Industry-3SU11502BC601BA0-22024110405584059557500d0b6156e/SOLIDWORKS/3SU11502BC601BA0_PART1.sldprt
Drawing/BangTai_TiLe110.SLDDRW
Drawing/BeTruot_TiLe12.SLDDRW
Drawing/ChanTang2_TiLe110.SLDDRW
Drawing/CoOng1.SLDDRW
Drawing/CoOng2.SLDDRW
Drawing/KhungPheu_TiLe15 - Copy.SLDDRW
Drawing/KhungPheu_TiLe15.SLDDRW
Drawing/KhungThan_TiLe115 - Copy.SLDDRW
Drawing/KhungThan_TiLe115.SLDDRW
Drawing/MangAnDuoi.SLDDRW
Drawing/MangGat.SLDDRW
Drawing/NapChuong.SLDDRW
Drawing/OngDanThucAn.SLDDRW
Drawing/OngNuocDuoi.SLDDRW
Drawing/Pheu_TiLe12 - Copy.SLDDRW
Drawing/Pheu_TiLe12.SLDDRW
chuongga/3dfindit-Festo-15884_EG-2_5-10-PK-2---_10_0_-22024110408410898511802d0b6156e/SOLIDWORKS/15884 EG-2,5-10-PK-2-(N).sldprt
chuongga/3dfindit-Festo-15884_EG-2_5-10-PK-2---_10_0_-22024110408410898511802d0b6156e/SOLIDWORKS/15884 EG-2,5-10-PK-2---(10_0).sldasm
chuongga/3dfindit-Festo-15884_EG-2_5-10-PK-2---_10_0_-22024110408410898511802d0b6156e/SOLIDWORKS/15884 EG-2,5-10-PK-2---(10_KS).sldprt
chuongga/3dfindit-Festo-15884_EG-2_5-10-PK-2---_10_0_-22024110408410898511802d0b6156e/SOLIDWORKS/15884 EG-2,5-10-PK-2---(ZR_10_0).sldprt
chuongga/tudein/nut_emo.STEP.SLDASM
