MinhNhut223/Automated-Poultry-Farming-Machine/Print/KhungPheu-V2.pdf

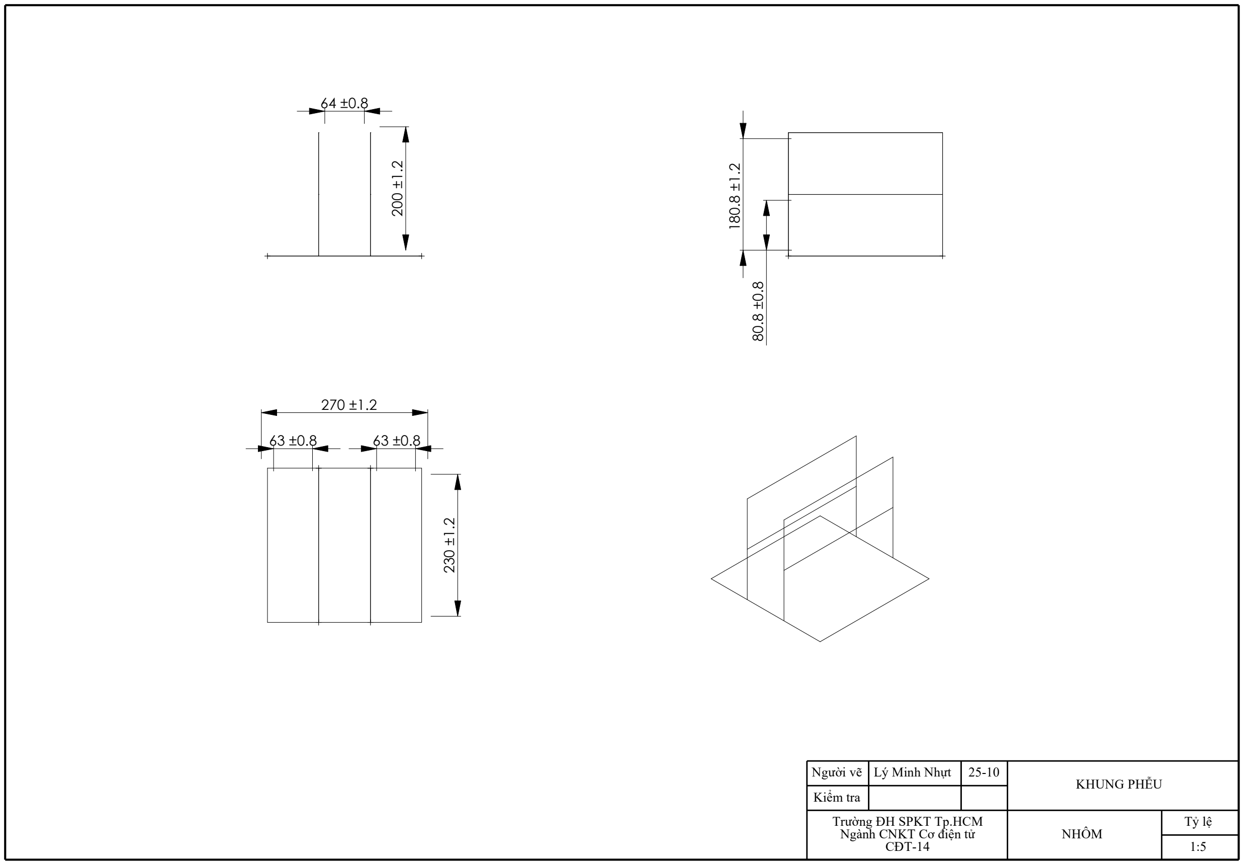
[picture p133: page 1]

Người vẽ | Lý Minh Nhựt | 25-10 | KHUNG PHỄU
Kiểm tra
Trường ĐH SPKT Tp.HCM CĐT-14 | | Tỷ lệ
1:5
Ngành CNKT Cơ điện tử | NHÔM ²⁰⁰ ±1.2

64 ±0.8

63 ±0.8

270 ±1.2

63 ±0.8 | 230 ±1.2 | 80.8 ±0.8 180.8 ±1.2
