MinhNhut223/Automated-Poultry-Farming-Machine/Print/MangGat-V12.pdf

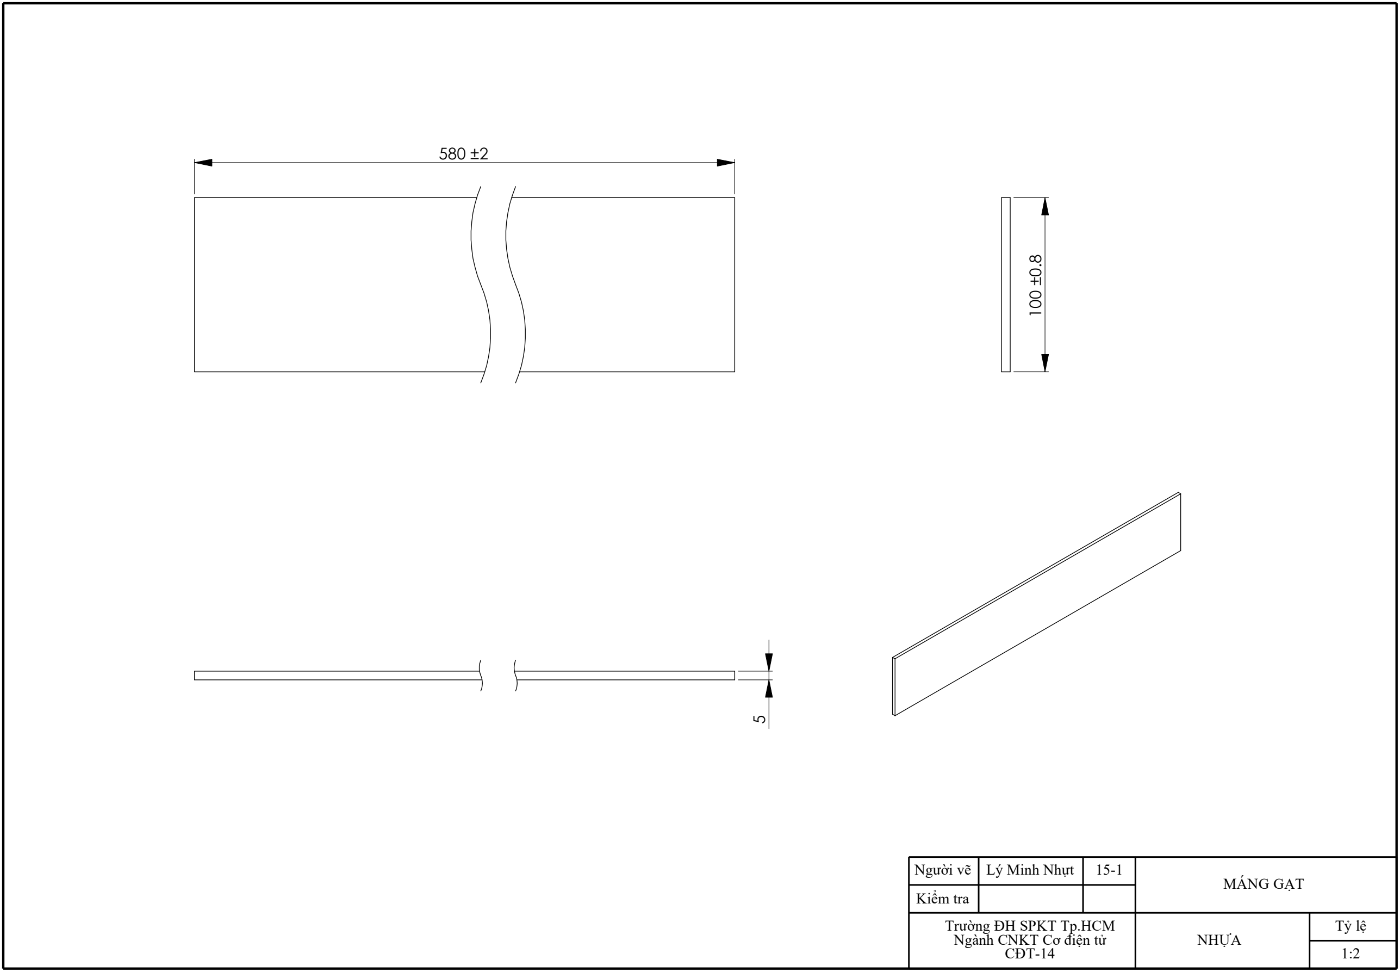
[picture p134: figure]
Người vẽ; Lý Minh Nhựt; MÁNG GẠT; Trường ĐH SPKT Tp.HCM CĐT-14; Kiểm tra; Ngành CNKT Cơ điện tử; NHỰA ⁵
