MinhNhut223/Automated-Poultry-Farming-Machine/chuongga/khung-Static 1-1 (fix).docx

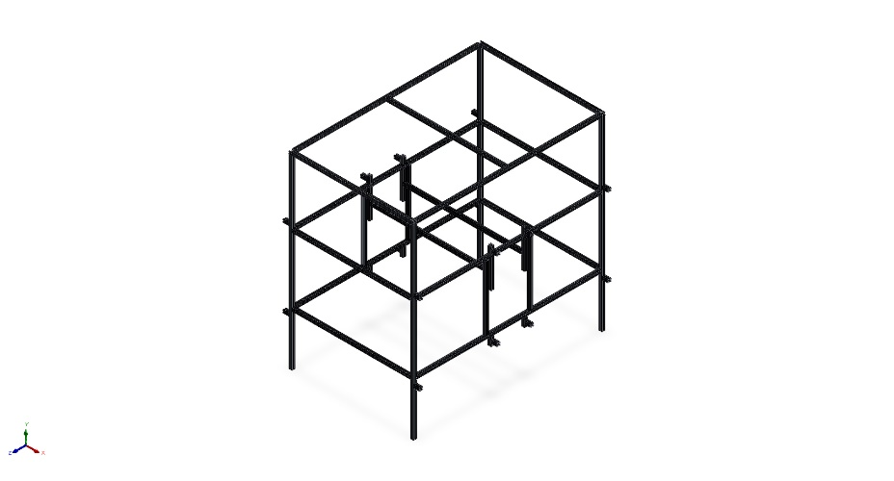
[picture p135: figure]

Simulation of khung

Date: Saturday, January 4, 2025
Designer: Solidworks

Study name: Static 1

Analysis type: Static
Description No Data

# Assumptions

# Model Information

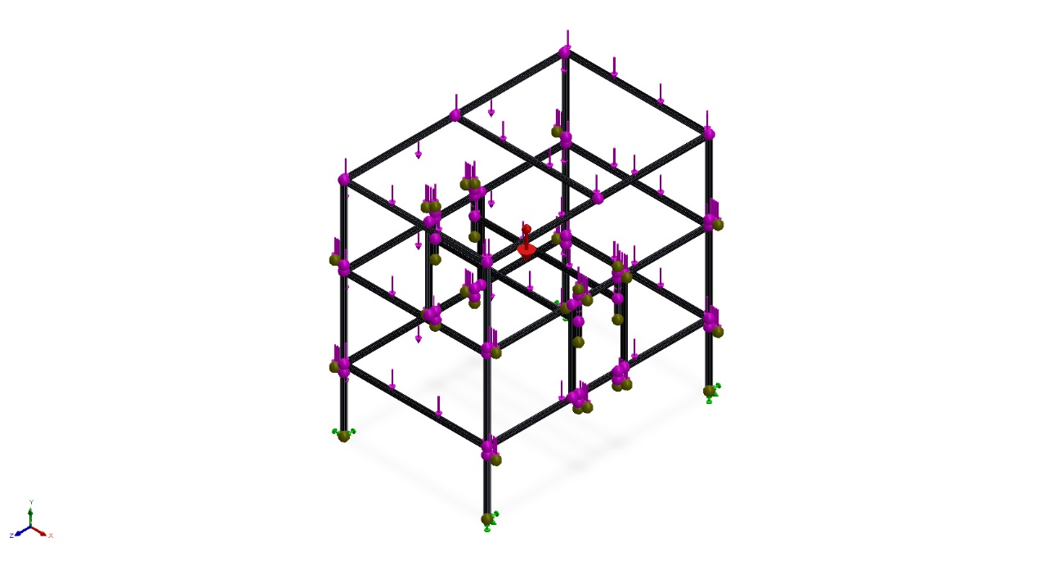
[picture p136: figure]

Model name: khung

Current Configuration: Default<As Machined>

Beam Bodies:
Document Name and Reference | Formulation | Properties | Document Path/Date Modified
SolidBody 1( C:\THUVIENSOLIDWORKS\ALUMINUM FRAMES25102020\SERI 5 (20,40)\20X20S5 - IS MISSING(1)[26]) | Beam – Uniform C/S | Section Standard-Aluminum Frames25102020/SERI 5 (20,40)/20x20S5 Section Area: 0.000172186m^2 Length:780mm Volume:0.000134305m^3 Mass Density:2,700kg/m^3 Mass:0.362623kg Weight:3.55371N | C:\Users\Asus\Desktop\chuongga\chuongga\khung.SLDPRT Jan 4 21:18:41 2025
SolidBody 2( C:\THUVIENSOLIDWORKS\ALUMINUM FRAMES25102020\SERI 5 (20,40)\20X20S5 - IS MISSING(1)[44]) | Beam – Uniform C/S | Section Standard-Aluminum Frames25102020/SERI 5 (20,40)/20x20S5 Section Area: 0.000172186m^2 Length:40mm Volume:6.88744e-06m^3 Mass Density:2,700kg/m^3 Mass:0.0185961kg Weight:0.182242N | C:\Users\Asus\Desktop\chuongga\chuongga\khung.SLDPRT Jan 4 21:18:41 2025
SolidBody 3( C:\THUVIENSOLIDWORKS\ALUMINUM FRAMES25102020\SERI 5 (20,40)\20X20S5 - IS MISSING(1)[7]) | Beam – Uniform C/S | Section Standard-Aluminum Frames25102020/SERI 5 (20,40)/20x20S5 Section Area: 0.000172186m^2 Length:1,220.8mm Volume:0.000210203m^3 Mass Density:2,700kg/m^3 Mass:0.567547kg Weight:5.56196N | C:\Users\Asus\Desktop\chuongga\chuongga\khung.SLDPRT Jan 4 21:18:41 2025
SolidBody 4( C:\THUVIENSOLIDWORKS\ALUMINUM FRAMES25102020\SERI 5 (20,40)\20X20S5 - IS MISSING(1)[31]) | Beam – Uniform C/S | Section Standard-Aluminum Frames25102020/SERI 5 (20,40)/20x20S5 Section Area: 0.000172186m^2 Length:46.4mm Volume:7.98943e-06m^3 Mass Density:2,700kg/m^3 Mass:0.0215714kg Weight:0.2114N | C:\Users\Asus\Desktop\chuongga\chuongga\khung.SLDPRT Jan 4 21:18:41 2025
SolidBody 5( C:\THUVIENSOLIDWORKS\ALUMINUM FRAMES25102020\SERI 5 (20,40)\20X20S5 - IS MISSING(1)[10]) | Beam – Uniform C/S | Section Standard-Aluminum Frames25102020/SERI 5 (20,40)/20x20S5 Section Area: 0.000172186m^2 Length:1,220.8mm Volume:0.000210205m^3 Mass Density:2,700kg/m^3 Mass:0.567552kg Weight:5.56201N | C:\Users\Asus\Desktop\chuongga\chuongga\khung.SLDPRT Jan 4 21:18:41 2025
SolidBody 6( C:\THUVIENSOLIDWORKS\ALUMINUM FRAMES25102020\SERI 5 (20,40)\20X20S5 - IS MISSING(1)[23]) | Beam – Uniform C/S | Section Standard-Aluminum Frames25102020/SERI 5 (20,40)/20x20S5 Section Area: 0.000172186m^2 Length:430.8mm Volume:7.41777e-05m^3 Mass Density:2,700kg/m^3 Mass:0.20028kg Weight:1.96274N | C:\Users\Asus\Desktop\chuongga\chuongga\khung.SLDPRT Jan 4 21:18:41 2025
SolidBody 7( C:\THUVIENSOLIDWORKS\ALUMINUM FRAMES25102020\SERI 5 (20,40)\20X20S5 - IS MISSING(1)[40]) | Beam – Uniform C/S | Section Standard-Aluminum Frames25102020/SERI 5 (20,40)/20x20S5 Section Area: 0.000172186m^2 Length:40mm Volume:6.88744e-06m^3 Mass Density:2,700kg/m^3 Mass:0.0185961kg Weight:0.182242N | C:\Users\Asus\Desktop\chuongga\chuongga\khung.SLDPRT Jan 4 21:18:41 2025
SolidBody 8( C:\THUVIENSOLIDWORKS\ALUMINUM FRAMES25102020\SERI 5 (20,40)\20X20S5 - IS MISSING(1)[6]) | Beam – Uniform C/S | Section Standard-Aluminum Frames25102020/SERI 5 (20,40)/20x20S5 Section Area: 0.000172186m^2 Length:780mm Volume:0.000134512m^3 Mass Density:2,700kg/m^3 Mass:0.363182kg Weight:3.55919N | C:\Users\Asus\Desktop\chuongga\chuongga\khung.SLDPRT Jan 4 21:18:41 2025
SolidBody 9( C:\THUVIENSOLIDWORKS\ALUMINUM FRAMES25102020\SERI 5 (20,40)\20X20S5 - IS MISSING(1)[8]) | Beam – Uniform C/S | Section Standard-Aluminum Frames25102020/SERI 5 (20,40)/20x20S5 Section Area: 0.000172186m^2 Length:780mm Volume:0.000134512m^3 Mass Density:2,700kg/m^3 Mass:0.363182kg Weight:3.55919N | C:\Users\Asus\Desktop\chuongga\chuongga\khung.SLDPRT Jan 4 21:18:41 2025
SolidBody 10( C:\THUVIENSOLIDWORKS\ALUMINUM FRAMES25102020\SERI 5 (20,40)\20X20S5 - IS MISSING(1)[22]) | Beam – Uniform C/S | Section Standard-Aluminum Frames25102020/SERI 5 (20,40)/20x20S5 Section Area: 0.000172186m^2 Length:430.8mm Volume:7.41777e-05m^3 Mass Density:2,700kg/m^3 Mass:0.20028kg Weight:1.96274N | C:\Users\Asus\Desktop\chuongga\chuongga\khung.SLDPRT Jan 4 21:18:41 2025
SolidBody 11( C:\THUVIENSOLIDWORKS\ALUMINUM FRAMES25102020\SERI 5 (20,40)\20X20S5 - IS MISSING(1)[46]) | Beam – Uniform C/S | Section Standard-Aluminum Frames25102020/SERI 5 (20,40)/20x20S5 Section Area: 0.000172186m^2 Length:40mm Volume:6.88744e-06m^3 Mass Density:2,700kg/m^3 Mass:0.0185961kg Weight:0.182242N | C:\Users\Asus\Desktop\chuongga\chuongga\khung.SLDPRT Jan 4 21:18:41 2025
SolidBody 12( C:\THUVIENSOLIDWORKS\ALUMINUM FRAMES25102020\SERI 5 (20,40)\20X20S5 - IS MISSING(1)[2]) | Beam – Uniform C/S | Section Standard-Aluminum Frames25102020/SERI 5 (20,40)/20x20S5 Section Area: 0.000172186m^2 Length:1,240mm Volume:0.00021351m^3 Mass Density:2,700kg/m^3 Mass:0.576478kg Weight:5.64949N | C:\Users\Asus\Desktop\chuongga\chuongga\khung.SLDPRT Jan 4 21:18:41 2025
SolidBody 13( C:\THUVIENSOLIDWORKS\ALUMINUM FRAMES25102020\SERI 5 (20,40)\20X20S5 - IS MISSING(1)[11]) | Beam – Uniform C/S | Section Standard-Aluminum Frames25102020/SERI 5 (20,40)/20x20S5 Section Area: 0.000172186m^2 Length:1,220.8mm Volume:0.000210205m^3 Mass Density:2,700kg/m^3 Mass:0.567552kg Weight:5.56201N | C:\Users\Asus\Desktop\chuongga\chuongga\khung.SLDPRT Jan 4 21:18:41 2025
SolidBody 14( C:\THUVIENSOLIDWORKS\ALUMINUM FRAMES25102020\SERI 5 (20,40)\20X20S5 - IS MISSING(1)[21]) | Beam – Uniform C/S | Section Standard-Aluminum Frames25102020/SERI 5 (20,40)/20x20S5 Section Area: 0.000172186m^2 Length:430.8mm Volume:7.41777e-05m^3 Mass Density:2,700kg/m^3 Mass:0.20028kg Weight:1.96274N | C:\Users\Asus\Desktop\chuongga\chuongga\khung.SLDPRT Jan 4 21:18:41 2025
SolidBody 15( C:\THUVIENSOLIDWORKS\ALUMINUM FRAMES25102020\SERI 5 (20,40)\20X20S5 - IS MISSING(1)[5]) | Beam – Uniform C/S | Section Standard-Aluminum Frames25102020/SERI 5 (20,40)/20x20S5 Section Area: 0.000172186m^2 Length:1,220.8mm Volume:0.000210203m^3 Mass Density:2,700kg/m^3 Mass:0.567547kg Weight:5.56196N | C:\Users\Asus\Desktop\chuongga\chuongga\khung.SLDPRT Jan 4 21:18:41 2025
SolidBody 16( C:\THUVIENSOLIDWORKS\ALUMINUM FRAMES25102020\SERI 5 (20,40)\20X20S5 - IS MISSING(1)[16]) | Beam – Uniform C/S | Section Standard-Aluminum Frames25102020/SERI 5 (20,40)/20x20S5 Section Area: 0.000172186m^2 Length:190.4mm Volume:3.27842e-05m^3 Mass Density:2,700kg/m^3 Mass:0.0885173kg Weight:0.86747N | C:\Users\Asus\Desktop\chuongga\chuongga\khung.SLDPRT Jan 4 21:18:41 2025
SolidBody 17( C:\THUVIENSOLIDWORKS\ALUMINUM FRAMES25102020\SERI 5 (20,40)\20X20S5 - IS MISSING(1)[42]) | Beam – Uniform C/S | Section Standard-Aluminum Frames25102020/SERI 5 (20,40)/20x20S5 Section Area: 0.000172186m^2 Length:40mm Volume:6.88744e-06m^3 Mass Density:2,700kg/m^3 Mass:0.0185961kg Weight:0.182242N | C:\Users\Asus\Desktop\chuongga\chuongga\khung.SLDPRT Jan 4 21:18:41 2025
SolidBody 18( C:\THUVIENSOLIDWORKS\ALUMINUM FRAMES25102020\SERI 5 (20,40)\20X20S5 - IS MISSING(1)[47]) | Beam – Uniform C/S | Section Standard-Aluminum Frames25102020/SERI 5 (20,40)/20x20S5 Section Area: 0.000172186m^2 Length:40mm Volume:6.88744e-06m^3 Mass Density:2,700kg/m^3 Mass:0.0185961kg Weight:0.182242N | C:\Users\Asus\Desktop\chuongga\chuongga\khung.SLDPRT Jan 4 21:18:41 2025
SolidBody 19( C:\THUVIENSOLIDWORKS\ALUMINUM FRAMES25102020\SERI 5 (20,40)\20X20S5 - IS MISSING(1)[48]) | Beam – Uniform C/S | Section Standard-Aluminum Frames25102020/SERI 5 (20,40)/20x20S5 Section Area: 0.000172186m^2 Length:40mm Volume:6.88744e-06m^3 Mass Density:2,700kg/m^3 Mass:0.0185961kg Weight:0.182242N | C:\Users\Asus\Desktop\chuongga\chuongga\khung.SLDPRT Jan 4 21:18:41 2025
SolidBody 20( C:\THUVIENSOLIDWORKS\ALUMINUM FRAMES25102020\SERI 5 (20,40)\20X20S5 - IS MISSING(1)[49]) | Beam – Uniform C/S | Section Standard-Aluminum Frames25102020/SERI 5 (20,40)/20x20S5 Section Area: 0.000172186m^2 Length:40mm Volume:6.88744e-06m^3 Mass Density:2,700kg/m^3 Mass:0.0185961kg Weight:0.182242N | C:\Users\Asus\Desktop\chuongga\chuongga\khung.SLDPRT Jan 4 21:18:41 2025
SolidBody 21( C:\THUVIENSOLIDWORKS\ALUMINUM FRAMES25102020\SERI 5 (20,40)\20X20S5 - IS MISSING(1)[12]) | Beam – Uniform C/S | Section Standard-Aluminum Frames25102020/SERI 5 (20,40)/20x20S5 Section Area: 0.000172186m^2 Length:1,220.8mm Volume:0.000210205m^3 Mass Density:2,700kg/m^3 Mass:0.567552kg Weight:5.56201N | C:\Users\Asus\Desktop\chuongga\chuongga\khung.SLDPRT Jan 4 21:18:41 2025
SolidBody 22( C:\THUVIENSOLIDWORKS\ALUMINUM FRAMES25102020\SERI 5 (20,40)\20X20S5 - IS MISSING(1)[36]) | Beam – Uniform C/S | Section Standard-Aluminum Frames25102020/SERI 5 (20,40)/20x20S5 Section Area: 0.000172186m^2 Length:40mm Volume:6.88744e-06m^3 Mass Density:2,700kg/m^3 Mass:0.0185961kg Weight:0.182242N | C:\Users\Asus\Desktop\chuongga\chuongga\khung.SLDPRT Jan 4 21:18:41 2025
SolidBody 23( C:\THUVIENSOLIDWORKS\ALUMINUM FRAMES25102020\SERI 5 (20,40)\20X20S5 - IS MISSING(1)[50]) | Beam – Uniform C/S | Section Standard-Aluminum Frames25102020/SERI 5 (20,40)/20x20S5 Section Area: 0.000172186m^2 Length:40mm Volume:6.88744e-06m^3 Mass Density:2,700kg/m^3 Mass:0.0185961kg Weight:0.182242N | C:\Users\Asus\Desktop\chuongga\chuongga\khung.SLDPRT Jan 4 21:18:41 2025
SolidBody 24( C:\THUVIENSOLIDWORKS\ALUMINUM FRAMES25102020\SERI 5 (20,40)\20X20S5 - IS MISSING(1)[3]) | Beam – Uniform C/S | Section Standard-Aluminum Frames25102020/SERI 5 (20,40)/20x20S5 Section Area: 0.000172186m^2 Length:1,240mm Volume:0.00021351m^3 Mass Density:2,700kg/m^3 Mass:0.576478kg Weight:5.64949N | C:\Users\Asus\Desktop\chuongga\chuongga\khung.SLDPRT Jan 4 21:18:41 2025
SolidBody 25( C:\THUVIENSOLIDWORKS\ALUMINUM FRAMES25102020\SERI 5 (20,40)\20X20S5 - IS MISSING(1)[37]) | Beam – Uniform C/S | Section Standard-Aluminum Frames25102020/SERI 5 (20,40)/20x20S5 Section Area: 0.000172186m^2 Length:40mm Volume:6.88744e-06m^3 Mass Density:2,700kg/m^3 Mass:0.0185961kg Weight:0.182242N | C:\Users\Asus\Desktop\chuongga\chuongga\khung.SLDPRT Jan 4 21:18:41 2025
SolidBody 26( C:\THUVIENSOLIDWORKS\ALUMINUM FRAMES25102020\SERI 5 (20,40)\20X20S5 - IS MISSING(1)[43]) | Beam – Uniform C/S | Section Standard-Aluminum Frames25102020/SERI 5 (20,40)/20x20S5 Section Area: 0.000172186m^2 Length:40mm Volume:6.88744e-06m^3 Mass Density:2,700kg/m^3 Mass:0.0185961kg Weight:0.182242N | C:\Users\Asus\Desktop\chuongga\chuongga\khung.SLDPRT Jan 4 21:18:41 2025
SolidBody 27( C:\THUVIENSOLIDWORKS\ALUMINUM FRAMES25102020\SERI 5 (20,40)\20X20S5 - IS MISSING(1)[25]) | Beam – Uniform C/S | Section Standard-Aluminum Frames25102020/SERI 5 (20,40)/20x20S5 Section Area: 0.000172186m^2 Length:780mm Volume:0.000134305m^3 Mass Density:2,700kg/m^3 Mass:0.362623kg Weight:3.55371N | C:\Users\Asus\Desktop\chuongga\chuongga\khung.SLDPRT Jan 4 21:18:41 2025
SolidBody 28( C:\THUVIENSOLIDWORKS\ALUMINUM FRAMES25102020\SERI 5 (20,40)\20X20S5 - IS MISSING(1)[28]) | Beam – Uniform C/S | Section Standard-Aluminum Frames25102020/SERI 5 (20,40)/20x20S5 Section Area: 0.000172186m^2 Length:60.4mm Volume:1.04e-05m^3 Mass Density:2,700kg/m^3 Mass:0.0280801kg Weight:0.275185N | C:\Users\Asus\Desktop\chuongga\chuongga\khung.SLDPRT Jan 4 21:18:41 2025
SolidBody 29( C:\THUVIENSOLIDWORKS\ALUMINUM FRAMES25102020\SERI 5 (20,40)\20X20S5 - IS MISSING(1)[9]) | Beam – Uniform C/S | Section Standard-Aluminum Frames25102020/SERI 5 (20,40)/20x20S5 Section Area: 0.000172186m^2 Length:1,220.8mm Volume:0.000210205m^3 Mass Density:2,700kg/m^3 Mass:0.567552kg Weight:5.56201N | C:\Users\Asus\Desktop\chuongga\chuongga\khung.SLDPRT Jan 4 21:18:41 2025
SolidBody 30( C:\THUVIENSOLIDWORKS\ALUMINUM FRAMES25102020\SERI 5 (20,40)\20X20S5 - IS MISSING(1)[27]) | Beam – Uniform C/S | Section Standard-Aluminum Frames25102020/SERI 5 (20,40)/20x20S5 Section Area: 0.000172186m^2 Length:60.4mm Volume:1.04e-05m^3 Mass Density:2,700kg/m^3 Mass:0.0280801kg Weight:0.275185N | C:\Users\Asus\Desktop\chuongga\chuongga\khung.SLDPRT Jan 4 21:18:41 2025
SolidBody 31( C:\THUVIENSOLIDWORKS\ALUMINUM FRAMES25102020\SERI 5 (20,40)\20X20S5 - IS MISSING(1)[38]) | Beam – Uniform C/S | Section Standard-Aluminum Frames25102020/SERI 5 (20,40)/20x20S5 Section Area: 0.000172186m^2 Length:40mm Volume:6.88744e-06m^3 Mass Density:2,700kg/m^3 Mass:0.0185961kg Weight:0.182242N | C:\Users\Asus\Desktop\chuongga\chuongga\khung.SLDPRT Jan 4 21:18:41 2025
SolidBody 32( C:\THUVIENSOLIDWORKS\ALUMINUM FRAMES25102020\SERI 5 (20,40)\20X20S5 - IS MISSING(1)[19]) | Beam – Uniform C/S | Section Standard-Aluminum Frames25102020/SERI 5 (20,40)/20x20S5 Section Area: 0.000172186m^2 Length:780mm Volume:0.000134305m^3 Mass Density:2,700kg/m^3 Mass:0.362623kg Weight:3.55371N | C:\Users\Asus\Desktop\chuongga\chuongga\khung.SLDPRT Jan 4 21:18:41 2025
SolidBody 33( C:\THUVIENSOLIDWORKS\ALUMINUM FRAMES25102020\SERI 5 (20,40)\20X20S5 - IS MISSING(1)[32]) | Beam – Uniform C/S | Section Standard-Aluminum Frames25102020/SERI 5 (20,40)/20x20S5 Section Area: 0.000172186m^2 Length:46.4mm Volume:7.98943e-06m^3 Mass Density:2,700kg/m^3 Mass:0.0215714kg Weight:0.2114N | C:\Users\Asus\Desktop\chuongga\chuongga\khung.SLDPRT Jan 4 21:18:41 2025
SolidBody 34( C:\THUVIENSOLIDWORKS\ALUMINUM FRAMES25102020\SERI 5 (20,40)\20X20S5 - IS MISSING(1)[45]) | Beam – Uniform C/S | Section Standard-Aluminum Frames25102020/SERI 5 (20,40)/20x20S5 Section Area: 0.000172186m^2 Length:40mm Volume:6.88744e-06m^3 Mass Density:2,700kg/m^3 Mass:0.0185961kg Weight:0.182242N | C:\Users\Asus\Desktop\chuongga\chuongga\khung.SLDPRT Jan 4 21:18:41 2025
SolidBody 35( C:\THUVIENSOLIDWORKS\ALUMINUM FRAMES25102020\SERI 5 (20,40)\20X20S5 - IS MISSING(1)[24]) | Beam – Uniform C/S | Section Standard-Aluminum Frames25102020/SERI 5 (20,40)/20x20S5 Section Area: 0.000172186m^2 Length:430.8mm Volume:7.41777e-05m^3 Mass Density:2,700kg/m^3 Mass:0.20028kg Weight:1.96274N | C:\Users\Asus\Desktop\chuongga\chuongga\khung.SLDPRT Jan 4 21:18:41 2025
SolidBody 36( C:\THUVIENSOLIDWORKS\ALUMINUM FRAMES25102020\SERI 5 (20,40)\20X20S5 - IS MISSING(1)[35]) | Beam – Uniform C/S | Section Standard-Aluminum Frames25102020/SERI 5 (20,40)/20x20S5 Section Area: 0.000172186m^2 Length:40mm Volume:6.88744e-06m^3 Mass Density:2,700kg/m^3 Mass:0.0185961kg Weight:0.182242N | C:\Users\Asus\Desktop\chuongga\chuongga\khung.SLDPRT Jan 4 21:18:41 2025
SolidBody 37( C:\THUVIENSOLIDWORKS\ALUMINUM FRAMES25102020\SERI 5 (20,40)\20X20S5 - IS MISSING(1)[17]) | Beam – Uniform C/S | Section Standard-Aluminum Frames25102020/SERI 5 (20,40)/20x20S5 Section Area: 0.000172186m^2 Length:780mm Volume:0.000134305m^3 Mass Density:2,700kg/m^3 Mass:0.362623kg Weight:3.55371N | C:\Users\Asus\Desktop\chuongga\chuongga\khung.SLDPRT Jan 4 21:18:41 2025
SolidBody 38( C:\THUVIENSOLIDWORKS\ALUMINUM FRAMES25102020\SERI 5 (20,40)\20X20S5 - IS MISSING(1)[34]) | Beam – Uniform C/S | Section Standard-Aluminum Frames25102020/SERI 5 (20,40)/20x20S5 Section Area: 0.000172186m^2 Length:46.4mm Volume:7.98943e-06m^3 Mass Density:2,700kg/m^3 Mass:0.0215714kg Weight:0.2114N | C:\Users\Asus\Desktop\chuongga\chuongga\khung.SLDPRT Jan 4 21:18:41 2025
SolidBody 39( C:\THUVIENSOLIDWORKS\ALUMINUM FRAMES25102020\SERI 5 (20,40)\20X20S5 - IS MISSING(1)[41]) | Beam – Uniform C/S | Section Standard-Aluminum Frames25102020/SERI 5 (20,40)/20x20S5 Section Area: 0.000172186m^2 Length:40mm Volume:6.88744e-06m^3 Mass Density:2,700kg/m^3 Mass:0.0185961kg Weight:0.182242N | C:\Users\Asus\Desktop\chuongga\chuongga\khung.SLDPRT Jan 4 21:18:41 2025
SolidBody 40( C:\THUVIENSOLIDWORKS\ALUMINUM FRAMES25102020\SERI 5 (20,40)\20X20S5 - IS MISSING(1)[4]) | Beam – Uniform C/S | Section Standard-Aluminum Frames25102020/SERI 5 (20,40)/20x20S5 Section Area: 0.000172186m^2 Length:1,240mm Volume:0.00021351m^3 Mass Density:2,700kg/m^3 Mass:0.576478kg Weight:5.64949N | C:\Users\Asus\Desktop\chuongga\chuongga\khung.SLDPRT Jan 4 21:18:41 2025
SolidBody 41( C:\THUVIENSOLIDWORKS\ALUMINUM FRAMES25102020\SERI 5 (20,40)\20X20S5 - IS MISSING(1)[13]) | Beam – Uniform C/S | Section Standard-Aluminum Frames25102020/SERI 5 (20,40)/20x20S5 Section Area: 0.000172186m^2 Length:190.4mm Volume:3.27842e-05m^3 Mass Density:2,700kg/m^3 Mass:0.0885173kg Weight:0.86747N | C:\Users\Asus\Desktop\chuongga\chuongga\khung.SLDPRT Jan 4 21:18:41 2025
SolidBody 42( C:\THUVIENSOLIDWORKS\ALUMINUM FRAMES25102020\SERI 5 (20,40)\20X20S5 - IS MISSING(1)[30]) | Beam – Uniform C/S | Section Standard-Aluminum Frames25102020/SERI 5 (20,40)/20x20S5 Section Area: 0.000172186m^2 Length:60.4mm Volume:1.04e-05m^3 Mass Density:2,700kg/m^3 Mass:0.0280801kg Weight:0.275185N | C:\Users\Asus\Desktop\chuongga\chuongga\khung.SLDPRT Jan 4 21:18:41 2025
SolidBody 43( C:\THUVIENSOLIDWORKS\ALUMINUM FRAMES25102020\SERI 5 (20,40)\20X20S5 - IS MISSING(1)[33]) | Beam – Uniform C/S | Section Standard-Aluminum Frames25102020/SERI 5 (20,40)/20x20S5 Section Area: 0.000172186m^2 Length:46.4mm Volume:7.98943e-06m^3 Mass Density:2,700kg/m^3 Mass:0.0215714kg Weight:0.2114N | C:\Users\Asus\Desktop\chuongga\chuongga\khung.SLDPRT Jan 4 21:18:41 2025
SolidBody 44( C:\THUVIENSOLIDWORKS\ALUMINUM FRAMES25102020\SERI 5 (20,40)\20X20S5 - IS MISSING(1)[18]) | Beam – Uniform C/S | Section Standard-Aluminum Frames25102020/SERI 5 (20,40)/20x20S5 Section Area: 0.000172186m^2 Length:780mm Volume:0.000134305m^3 Mass Density:2,700kg/m^3 Mass:0.362623kg Weight:3.55371N | C:\Users\Asus\Desktop\chuongga\chuongga\khung.SLDPRT Jan 4 21:18:41 2025
SolidBody 45( C:\THUVIENSOLIDWORKS\ALUMINUM FRAMES25102020\SERI 5 (20,40)\20X20S5 - IS MISSING(1)[20]) | Beam – Uniform C/S | Section Standard-Aluminum Frames25102020/SERI 5 (20,40)/20x20S5 Section Area: 0.000172186m^2 Length:780mm Volume:0.000134305m^3 Mass Density:2,700kg/m^3 Mass:0.362623kg Weight:3.55371N | C:\Users\Asus\Desktop\chuongga\chuongga\khung.SLDPRT Jan 4 21:18:41 2025
SolidBody 46( C:\THUVIENSOLIDWORKS\ALUMINUM FRAMES25102020\SERI 5 (20,40)\20X20S5 - IS MISSING(1)[29]) | Beam – Uniform C/S | Section Standard-Aluminum Frames25102020/SERI 5 (20,40)/20x20S5 Section Area: 0.000172186m^2 Length:60.4mm Volume:1.04e-05m^3 Mass Density:2,700kg/m^3 Mass:0.0280801kg Weight:0.275185N | C:\Users\Asus\Desktop\chuongga\chuongga\khung.SLDPRT Jan 4 21:18:41 2025
SolidBody 47( C:\THUVIENSOLIDWORKS\ALUMINUM FRAMES25102020\SERI 5 (20,40)\20X20S5 - IS MISSING(1)[14]) | Beam – Uniform C/S | Section Standard-Aluminum Frames25102020/SERI 5 (20,40)/20x20S5 Section Area: 0.000172186m^2 Length:190.4mm Volume:3.27842e-05m^3 Mass Density:2,700kg/m^3 Mass:0.0885173kg Weight:0.86747N | C:\Users\Asus\Desktop\chuongga\chuongga\khung.SLDPRT Jan 4 21:18:41 2025
SolidBody 48( C:\THUVIENSOLIDWORKS\ALUMINUM FRAMES25102020\SERI 5 (20,40)\20X20S5 - IS MISSING(1)[39]) | Beam – Uniform C/S | Section Standard-Aluminum Frames25102020/SERI 5 (20,40)/20x20S5 Section Area: 0.000172186m^2 Length:40mm Volume:6.88744e-06m^3 Mass Density:2,700kg/m^3 Mass:0.0185961kg Weight:0.182242N | C:\Users\Asus\Desktop\chuongga\chuongga\khung.SLDPRT Jan 4 21:18:41 2025
SolidBody 49( C:\THUVIENSOLIDWORKS\ALUMINUM FRAMES25102020\SERI 5 (20,40)\20X20S5 - IS MISSING(1)[15]) | Beam – Uniform C/S | Section Standard-Aluminum Frames25102020/SERI 5 (20,40)/20x20S5 Section Area: 0.000172186m^2 Length:190.4mm Volume:3.27842e-05m^3 Mass Density:2,700kg/m^3 Mass:0.0885173kg Weight:0.86747N | C:\Users\Asus\Desktop\chuongga\chuongga\khung.SLDPRT Jan 4 21:18:41 2025
SolidBody 50( C:\THUVIENSOLIDWORKS\ALUMINUM FRAMES25102020\SERI 5 (20,40)\20X20S5 - IS MISSING(1)[1]) | Beam – Uniform C/S | Section Standard-Aluminum Frames25102020/SERI 5 (20,40)/20x20S5 Section Area: 0.000172186m^2 Length:1,240mm Volume:0.00021351m^3 Mass Density:2,700kg/m^3 Mass:0.576478kg Weight:5.64949N | C:\Users\Asus\Desktop\chuongga\chuongga\khung.SLDPRT Jan 4 21:18:41 2025
SolidBody 51( C:\THUVIENSOLIDWORKS\ALUMINUM FRAMES25102020\SERI 5 (20,40)\20X20S5 - IS MISSING(1)[51]) | Beam – Uniform C/S | Section Standard-Aluminum Frames25102020/SERI 5 (20,40)/20x20S5 Section Area: 0.000172186m^2 Length:780mm Volume:0.000134305m^3 Mass Density:2,700kg/m^3 Mass:0.362623kg Weight:3.55371N | C:\Users\Asus\Desktop\chuongga\chuongga\khung.SLDPRT Jan 4 21:18:41 2025

# Study Properties

Study name | Static 1
Analysis type | Static
Mesh type | Beam Mesh
Solver type | Automatic
Inplane Effect: | Off
Soft Spring: | Off
Inertial Relief: | Off
Incompatible bonding options | Automatic
Large displacement | Off
Compute free body forces | On
Result folder | SOLIDWORKS document (C:\Users\Asus\Desktop\chuongga\chuongga)

# Units

Unit system: | SI (MKS)
Length/Displacement | mm
Temperature | Kelvin
Angular velocity | Rad/sec
Pressure/Stress | N/m^2

# Material Properties

Model Reference | Properties | Components

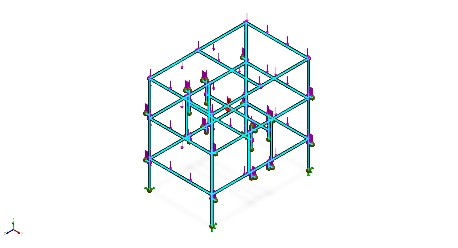
[picture p137: figure]

Name: | 6061 Alloy
Model type: | Linear Elastic Isotropic
Default failure criterion: | Unknown
Yield strength: | 5.51485e+07 N/m^2
Tensile strength: | 1.24084e+08 N/m^2
Elastic modulus: | 6.9e+10 N/m^2
Poisson's ratio: | 0.33
Mass density: | 2,700 kg/m^3
Shear modulus: | 2.6e+10 N/m^2
Thermal expansion coefficient: | 2.4e-05 /Kelvin

SolidBody 1( C:\THUVIENSOLIDWORKS\ALUMINUM FRAMES25102020\SERI 5 (20,40)\20X20S5 - IS MISSING(1)[26])(khung),

SolidBody 2( C:\THUVIENSOLIDWORKS\ALUMINUM FRAMES25102020\SERI 5 (20,40)\20X20S5 - IS MISSING(1)[44])(khung),

SolidBody 3( C:\THUVIENSOLIDWORKS\ALUMINUM FRAMES25102020\SERI 5 (20,40)\20X20S5 - IS MISSING(1)[7])(khung),

SolidBody 4( C:\THUVIENSOLIDWORKS\ALUMINUM FRAMES25102020\SERI 5 (20,40)\20X20S5 - IS MISSING(1)[31])(khung),

SolidBody 5( C:\THUVIENSOLIDWORKS\ALUMINUM FRAMES25102020\SERI 5 (20,40)\20X20S5 - IS MISSING(1)[10])(khung),

SolidBody 6( C:\THUVIENSOLIDWORKS\ALUMINUM FRAMES25102020\SERI 5 (20,40)\20X20S5 - IS MISSING(1)[23])(khung),

SolidBody 7( C:\THUVIENSOLIDWORKS\ALUMINUM FRAMES25102020\SERI 5 (20,40)\20X20S5 - IS MISSING(1)[40])(khung),

SolidBody 8( C:\THUVIENSOLIDWORKS\ALUMINUM FRAMES25102020\SERI 5 (20,40)\20X20S5 - IS MISSING(1)[6])(khung),

SolidBody 9( C:\THUVIENSOLIDWORKS\ALUMINUM FRAMES25102020\SERI 5 (20,40)\20X20S5 - IS MISSING(1)[8])(khung),

SolidBody 10( C:\THUVIENSOLIDWORKS\ALUMINUM FRAMES25102020\SERI 5 (20,40)\20X20S5 - IS MISSING(1)[22])(khung),

SolidBody 11( C:\THUVIENSOLIDWORKS\ALUMINUM FRAMES25102020\SERI 5 (20,40)\20X20S5 - IS MISSING(1)[46])(khung),

SolidBody 12( C:\THUVIENSOLIDWORKS\ALUMINUM FRAMES25102020\SERI 5 (20,40)\20X20S5 - IS MISSING(1)[2])(khung),

SolidBody 13( C:\THUVIENSOLIDWORKS\ALUMINUM FRAMES25102020\SERI 5 (20,40)\20X20S5 - IS MISSING(1)[11])(khung),

SolidBody 14( C:\THUVIENSOLIDWORKS\ALUMINUM FRAMES25102020\SERI 5 (20,40)\20X20S5 - IS MISSING(1)[21])(khung),

SolidBody 15( C:\THUVIENSOLIDWORKS\ALUMINUM FRAMES25102020\SERI 5 (20,40)\20X20S5 - IS MISSING(1)[5])(khung),

SolidBody 16( C:\THUVIENSOLIDWORKS\ALUMINUM FRAMES25102020\SERI 5 (20,40)\20X20S5 - IS MISSING(1)[16])(khung),

SolidBody 17( C:\THUVIENSOLIDWORKS\ALUMINUM FRAMES25102020\SERI 5 (20,40)\20X20S5 - IS MISSING(1)[42])(khung),

SolidBody 18( C:\THUVIENSOLIDWORKS\ALUMINUM FRAMES25102020\SERI 5 (20,40)\20X20S5 - IS MISSING(1)[47])(khung),

SolidBody 19( C:\THUVIENSOLIDWORKS\ALUMINUM FRAMES25102020\SERI 5 (20,40)\20X20S5 - IS MISSING(1)[48])(khung),

SolidBody 20( C:\THUVIENSOLIDWORKS\ALUMINUM FRAMES25102020\SERI 5 (20,40)\20X20S5 - IS MISSING(1)[49])(khung),

SolidBody 21( C:\THUVIENSOLIDWORKS\ALUMINUM FRAMES25102020\SERI 5 (20,40)\20X20S5 - IS MISSING(1)[12])(khung),

SolidBody 22( C:\THUVIENSOLIDWORKS\ALUMINUM FRAMES25102020\SERI 5 (20,40)\20X20S5 - IS MISSING(1)[36])(khung),

SolidBody 23( C:\THUVIENSOLIDWORKS\ALUMINUM FRAMES25102020\SERI 5 (20,40)\20X20S5 - IS MISSING(1)[50])(khung),

SolidBody 24( C:\THUVIENSOLIDWORKS\ALUMINUM FRAMES25102020\SERI 5 (20,40)\20X20S5 - IS MISSING(1)[3])(khung),

SolidBody 25( C:\THUVIENSOLIDWORKS\ALUMINUM FRAMES25102020\SERI 5 (20,40)\20X20S5 - IS MISSING(1)[37])(khung),

SolidBody 26( C:\THUVIENSOLIDWORKS\ALUMINUM FRAMES25102020\SERI 5 (20,40)\20X20S5 - IS MISSING(1)[43])(khung),

SolidBody 27( C:\THUVIENSOLIDWORKS\ALUMINUM FRAMES25102020\SERI 5 (20,40)\20X20S5 - IS MISSING(1)[25])(khung),

SolidBody 28( C:\THUVIENSOLIDWORKS\ALUMINUM FRAMES25102020\SERI 5 (20,40)\20X20S5 - IS MISSING(1)[28])(khung),

SolidBody 29( C:\THUVIENSOLIDWORKS\ALUMINUM FRAMES25102020\SERI 5 (20,40)\20X20S5 - IS MISSING(1)[9])(khung),

SolidBody 30( C:\THUVIENSOLIDWORKS\ALUMINUM FRAMES25102020\SERI 5 (20,40)\20X20S5 - IS MISSING(1)[27])(khung),

SolidBody 31( C:\THUVIENSOLIDWORKS\ALUMINUM FRAMES25102020\SERI 5 (20,40)\20X20S5 - IS MISSING(1)[38])(khung),

SolidBody 32( C:\THUVIENSOLIDWORKS\ALUMINUM FRAMES25102020\SERI 5 (20,40)\20X20S5 - IS MISSING(1)[19])(khung),

SolidBody 33( C:\THUVIENSOLIDWORKS\ALUMINUM FRAMES25102020\SERI 5 (20,40)\20X20S5 - IS MISSING(1)[32])(khung),

SolidBody 34( C:\THUVIENSOLIDWORKS\ALUMINUM FRAMES25102020\SERI 5 (20,40)\20X20S5 - IS MISSING(1)[45])(khung),

SolidBody 35( C:\THUVIENSOLIDWORKS\ALUMINUM FRAMES25102020\SERI 5 (20,40)\20X20S5 - IS MISSING(1)[24])(khung),

SolidBody 36( C:\THUVIENSOLIDWORKS\ALUMINUM FRAMES25102020\SERI 5 (20,40)\20X20S5 - IS MISSING(1)[35])(khung),

SolidBody 37( C:\THUVIENSOLIDWORKS\ALUMINUM FRAMES25102020\SERI 5 (20,40)\20X20S5 - IS MISSING(1)[17])(khung),

SolidBody 38( C:\THUVIENSOLIDWORKS\ALUMINUM FRAMES25102020\SERI 5 (20,40)\20X20S5 - IS MISSING(1)[34])(khung),

SolidBody 39( C:\THUVIENSOLIDWORKS\ALUMINUM FRAMES25102020\SERI 5 (20,40)\20X20S5 - IS MISSING(1)[41])(khung),

SolidBody 40( C:\THUVIENSOLIDWORKS\ALUMINUM FRAMES25102020\SERI 5 (20,40)\20X20S5 - IS MISSING(1)[4])(khung),

SolidBody 41( C:\THUVIENSOLIDWORKS\ALUMINUM FRAMES25102020\SERI 5 (20,40)\20X20S5 - IS MISSING(1)[13])(khung),

SolidBody 42( C:\THUVIENSOLIDWORKS\ALUMINUM FRAMES25102020\SERI 5 (20,40)\20X20S5 - IS MISSING(1)[30])(khung),

SolidBody 43( C:\THUVIENSOLIDWORKS\ALUMINUM FRAMES25102020\SERI 5 (20,40)\20X20S5 - IS MISSING(1)[33])(khung),

SolidBody 44( C:\THUVIENSOLIDWORKS\ALUMINUM FRAMES25102020\SERI 5 (20,40)\20X20S5 - IS MISSING(1)[18])(khung),

SolidBody 45( C:\THUVIENSOLIDWORKS\ALUMINUM FRAMES25102020\SERI 5 (20,40)\20X20S5 - IS MISSING(1)[20])(khung),

SolidBody 46( C:\THUVIENSOLIDWORKS\ALUMINUM FRAMES25102020\SERI 5 (20,40)\20X20S5 - IS MISSING(1)[29])(khung),

SolidBody 47( C:\THUVIENSOLIDWORKS\ALUMINUM FRAMES25102020\SERI 5 (20,40)\20X20S5 - IS MISSING(1)[14])(khung),

SolidBody 48( C:\THUVIENSOLIDWORKS\ALUMINUM FRAMES25102020\SERI 5 (20,40)\20X20S5 - IS MISSING(1)[39])(khung),

SolidBody 49( C:\THUVIENSOLIDWORKS\ALUMINUM FRAMES25102020\SERI 5 (20,40)\20X20S5 - IS MISSING(1)[15])(khung),

SolidBody 50( C:\THUVIENSOLIDWORKS\ALUMINUM FRAMES25102020\SERI 5 (20,40)\20X20S5 - IS MISSING(1)[1])(khung),

SolidBody 51( C:\THUVIENSOLIDWORKS\ALUMINUM FRAMES25102020\SERI 5 (20,40)\20X20S5 - IS MISSING(1)[51])(khung)

Curve Data:N/A

# Loads and Fixtures

Fixture name | Fixture Image | Fixture Details

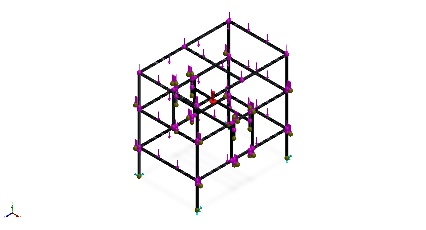
[picture p138: figure]

Fixed-1 | | Entities: 4 Joint(s) Type: Fixed Geometry

Load name | Load Image | Load Details

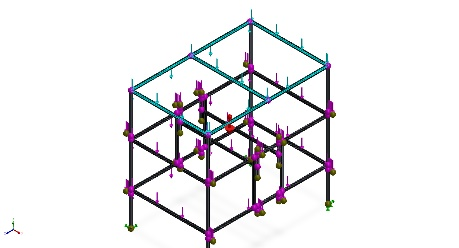
[picture p139: figure]

Force-11 | | Entities: 5 Beam (s) Reference: Edge< 1 > Type: Apply force Values: ---, ---, -60 N Moments: ---, ---, --- N.m

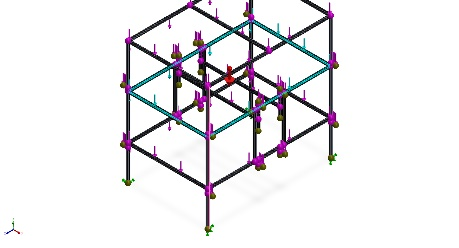
[picture p140: figure]

Force-12 | | Entities: 4 Beam (s) Reference: Edge< 1 > Type: Apply force Values: ---, ---, -70 N Moments: ---, ---, --- N.m

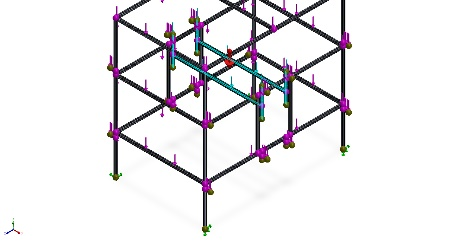
[picture p141: figure]

Force-13 | | Entities: 10 Beam (s) Reference: Edge< 1 > Type: Apply force Values: ---, ---, -20 N Moments: ---, ---, --- N.m

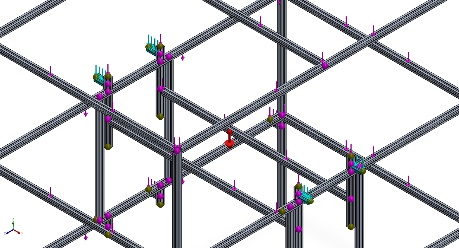
[picture p142: figure]

Force-14 | | Entities: 4 Beam (s) Reference: Edge< 1 > Type: Apply force Values: ---, ---, -2 N Moments: ---, ---, --- N.m

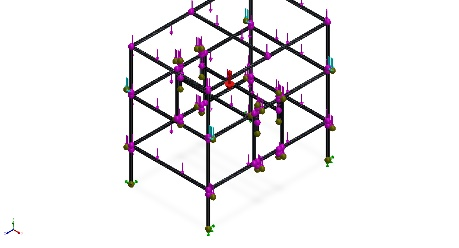
[picture p143: figure]

Force-15 | | Entities: 4 Beam (s) Reference: Edge< 1 > Type: Apply force Values: ---, ---, -2 N Moments: ---, ---, --- N.m

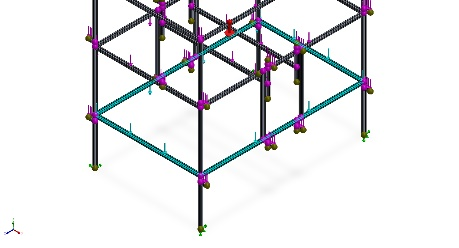
[picture p144: figure]

Force-16 | | Entities: 4 Beam (s) Reference: Edge< 1 > Type: Apply force Values: ---, ---, -80 N Moments: ---, ---, --- N.m

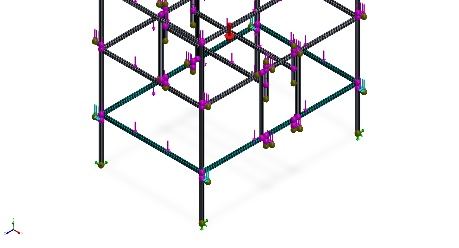
[picture p145: figure]

Force-17 | | Entities: 4 Beam (s) Reference: Edge< 1 > Type: Apply force Values: ---, ---, -2 N Moments: ---, ---, --- N.m

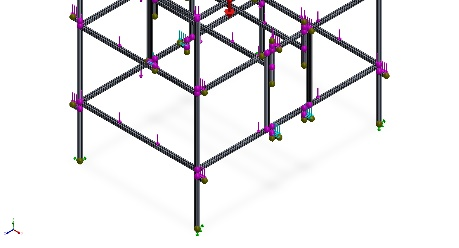
[picture p146: figure]

Force-18 | | Entities: 4 Beam (s) Reference: Edge< 1 > Type: Apply force Values: ---, ---, -2 N Moments: ---, ---, --- N.m

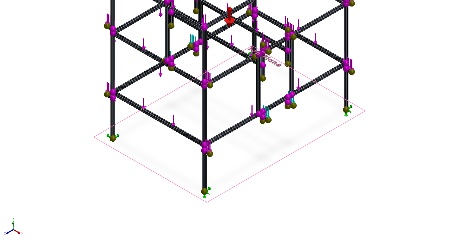
[picture p147: figure]

Gravity-1 | | Reference: Top Plane Values: 0 0 -9.81 Units: m/s^2

# Connector Definitions

No Data

# Contact Information

No Data

# Mesh information

Mesh type | Beam Mesh

## Mesh information - Details

Total Nodes | 687
Total Elements | 651
Time to complete mesh(hh;mm;ss): | 00:00:05
Computer name:

# Sensor Details

No Data

# Resultant Forces

## Reaction forces

Selection set | Units | Sum X | Sum Y | Sum Z | Resultant
Entire Model | N | 0 | 1,239.36 | 0 | 1,239.36

## Reaction Moments

Selection set | Units | Sum X | Sum Y | Sum Z | Resultant
Entire Model | N.m | 0.00114512 | -0.00135136 | 0.00288701 | 0.00338708

## Free body forces

Selection set | Units | Sum X | Sum Y | Sum Z | Resultant
Entire Model | N | 0 | 0 | 0 | 0

## Free body moments

Selection set | Units | Sum X | Sum Y | Sum Z | Resultant
Entire Model | N.m | 0 | 0 | 0 | 0

# Beams

## Beam Forces

Beam Name | Joints | Axial(N) | Shear1(N) | Shear2(N) | Moment1(N.m) | Moment2(N.m) | Torque(N.m)
Beam-1( C:\THUVIENSOLIDWORKS\ALUMINUM FRAMES25102020\SERI 5 (20,40)\20X20S5 - IS MISSING(1)[26]) | 1 | -0.779508 | 0.00557184 | 11.9601 | -0.448703 | 0.0169442 | 0.00060074
| 2 | 0.779508 | -0.00557184 | 11.9416 | 0.441283 | -0.0124867 | -0.000600739
Beam-2( C:\THUVIENSOLIDWORKS\ALUMINUM FRAMES25102020\SERI 5 (20,40)\20X20S5 - IS MISSING(1)[44]) | 1 | 0 | -1.59872e-13 | -1.87433e-08 | 1.8074e-11 | -4.52305e-13 | -1.02037e-11
| 2 | 0 | 3.30402e-13 | 2.22803 | -0.0557009 | 1.36136e-12 | 3.06112e-11
Beam-3( C:\THUVIENSOLIDWORKS\ALUMINUM FRAMES25102020\SERI 5 (20,40)\20X20S5 - IS MISSING(1)[7]) | 1 | -41.7756 | -0.104464 | 48.6039 | 10.2011 | 0.0365594 | 0.0887339
| 2 | 41.9438 | 0.144783 | 48.8487 | -10.3517 | 0.050513 | 0.0887524
| 3 | -41.9438 | -0.144783 | -16.0211 | -9.75798 | 0.0392525 | -0.0887524
Beam-4( C:\THUVIENSOLIDWORKS\ALUMINUM FRAMES25102020\SERI 5 (20,40)\20X20S5 - IS MISSING(1)[31]) | 1 | -2.82889e-08 | -3.41061e-13 | 2.27374e-13 | -1.27329e-11 | 9.43956e-12 | 5.96252e-13
| 2 | -12.3557 | 1.28459e-11 | -2.27374e-13 | -8.90736e-11 | 0.0557009 | 4.17402e-12
| 3 | 22.4834 | -1.28473e-11 | 2.27374e-13 | 8.90594e-11 | -0.0557009 | -4.17402e-12
Beam-5( C:\THUVIENSOLIDWORKS\ALUMINUM FRAMES25102020\SERI 5 (20,40)\20X20S5 - IS MISSING(1)[10]) | 1 | 39.3288 | 0.0121034 | 12.4983 | -3.50085 | -0.160077 | 0.0548392
| 2 | -1.84617 | -0.576697 | 70.7216 | -14.1438 | -0.110723 | 0.0101482
| 3 | 1.84626 | 0.575355 | -37.9101 | -11.6562 | -0.162829 | -0.0101481
| 4 | 39.3288 | 0.0121034 | -10.2108 | -3.88166 | -0.15699 | -0.0565626
| 5 | 1.9854 | -0.574135 | 71.0858 | 14.3234 | 0.104518 | 0.0104546
| 6 | 39.3287 | 0.0121336 | 7.53339 | -3.89598 | -0.159637 | -0.000861579
Beam-6( C:\THUVIENSOLIDWORKS\ALUMINUM FRAMES25102020\SERI 5 (20,40)\20X20S5 - IS MISSING(1)[23]) | 1 | 25.6214 | 0.586746 | -37.4236 | 8.16564 | -0.0442407 | -0.00813493
| 2 | -23.569 | -0.586746 | 37.4236 | 8.67498 | 0.308277 | 0.00813521
Beam-7( C:\THUVIENSOLIDWORKS\ALUMINUM FRAMES25102020\SERI 5 (20,40)\20X20S5 - IS MISSING(1)[40]) | 1 | 0 | 9.9476e-14 | -1.87353e-08 | 2.6219e-11 | -1.17284e-12 | 1.29707e-11
| 2 | 0 | 8.10019e-13 | 2.22803 | -0.0557009 | 3.52207e-12 | -3.89124e-11
Beam-8( C:\THUVIENSOLIDWORKS\ALUMINUM FRAMES25102020\SERI 5 (20,40)\20X20S5 - IS MISSING(1)[6]) | 1 | 13.9827 | -0.113474 | 32.1021 | -3.46542 | -0.0464223 | 0.000163954
| 2 | -13.9827 | 0.113474 | 31.5008 | 3.22788 | -0.0432224 | -0.000163954
Beam-9( C:\THUVIENSOLIDWORKS\ALUMINUM FRAMES25102020\SERI 5 (20,40)\20X20S5 - IS MISSING(1)[8]) | 1 | -13.7746 | 0.112128 | 31.8811 | 3.45742 | -0.0438625 | -6.78236e-05
| 2 | 13.7746 | -0.112128 | 31.7674 | -3.41193 | -0.0458397 | 6.78228e-05
Beam-10( C:\THUVIENSOLIDWORKS\ALUMINUM FRAMES25102020\SERI 5 (20,40)\20X20S5 - IS MISSING(1)[22]) | 1 | 25.776 | -0.585582 | 37.3433 | -8.14882 | 0.0444732 | -0.00805162
| 2 | -23.7238 | 0.585582 | -37.3433 | -8.65566 | -0.307985 | 0.00805106
Beam-11( C:\THUVIENSOLIDWORKS\ALUMINUM FRAMES25102020\SERI 5 (20,40)\20X20S5 - IS MISSING(1)[46]) | 1 | 0 | 2.77112e-13 | -1.87427e-08 | 1.94511e-11 | 6.25056e-13 | 7.72049e-12
| 2 | 0 | -4.9738e-14 | 2.22803 | -0.0557009 | -1.8775e-12 | -2.31616e-11
Beam-12( C:\THUVIENSOLIDWORKS\ALUMINUM FRAMES25102020\SERI 5 (20,40)\20X20S5 - IS MISSING(1)[2]) | 1 | 309.534 | -10.4436 | -29.0743 | 3.35078 | -1.15928 | -0.00468053
| 2 | -305.801 | 10.4436 | 29.0743 | 6.24375 | -2.34281 | 0.00468053
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
| 5 | -1.10981e+06 | -2.4765e+06 | -7.94779e+06 | 220,225 | 1.15341e+07
| 6 | -475,742 | 2.46377e+06 | 7.64744e+06 | -119,667 | 1.0587e+07
Beam-51( C:\THUVIENSOLIDWORKS\ALUMINUM FRAMES25102020\SERI 5 (20,40)\20X20S5 - IS MISSING(1)[51]) | 1 | -234.158 | 265,229 | 96,750.7 | -20,946.4 | 362,214
| 2 | -234.158 | 297,317 | -96,149.5 | -20,946.4 | 393,700

# Study Results

Name | Type | Min | Max
Stress1 | Upper bound axial and bending | 0.000e+00N/m^2 Element: 650 | 2.260e+07N/m^2 Element: 288

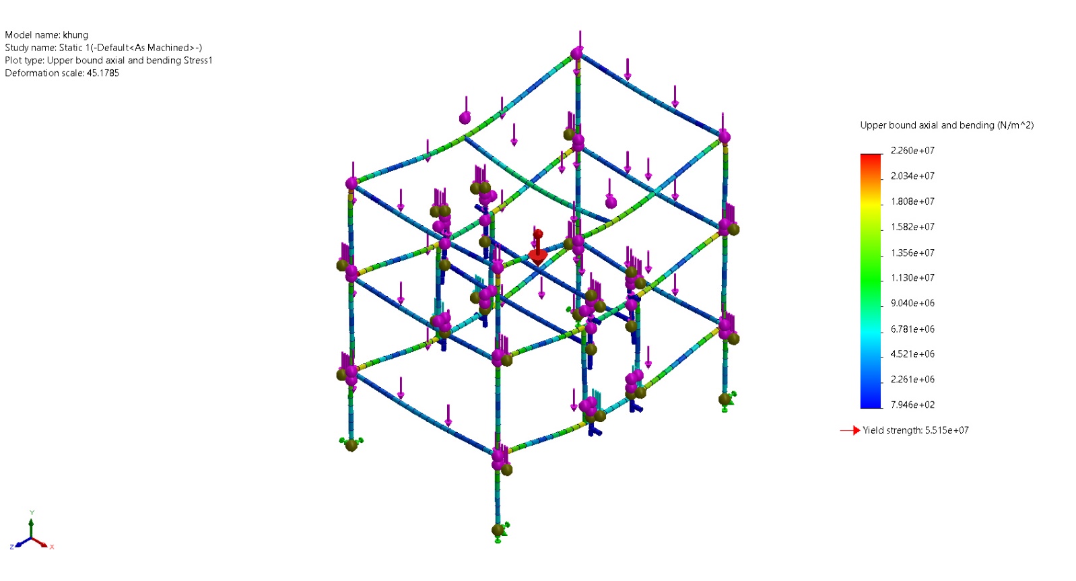
[picture p148: figure]

khung-Static 1-Stress-Stress1

Name | Type | Min | Max
Displacement1 | URES: Resultant Displacement | 0.000e+00mm Node: 170 | 2.966e+00mm Node: 627

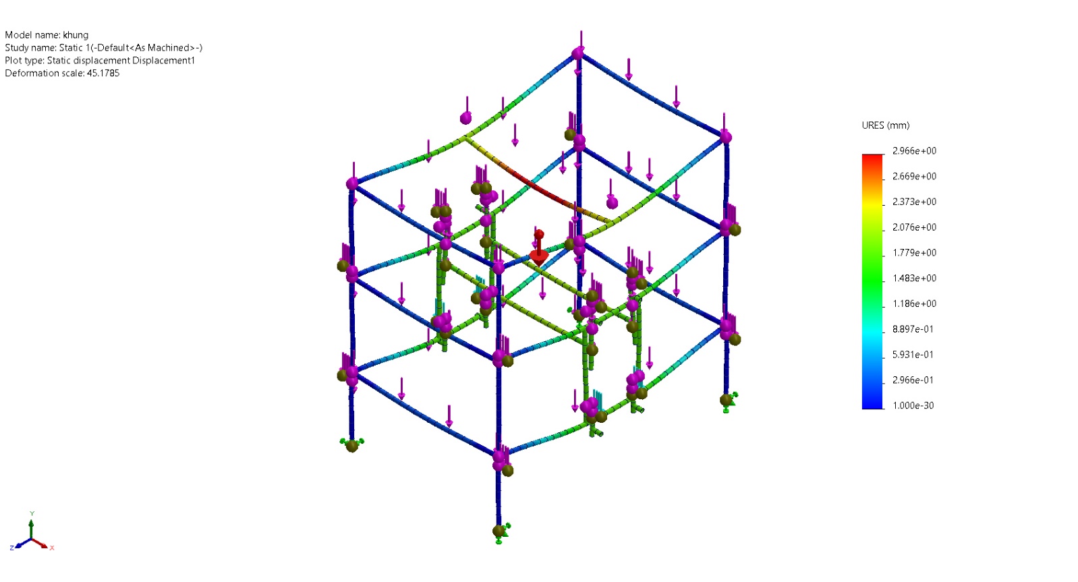
[picture p149: figure]

khung-Static 1-Displacement-Displacement1

Name | Type | Min | Max
Factor of Safety1 | Automatic | 2.440e+00 Node: 299 | 6.940e+04 Node: 394

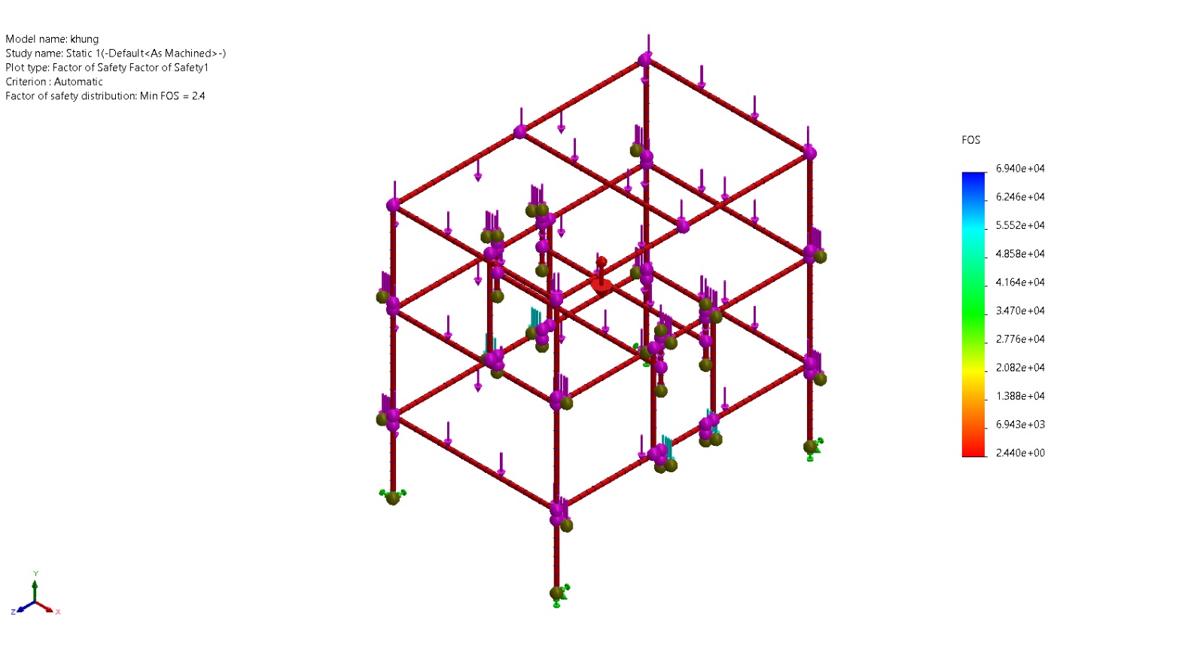
[picture p150: figure]

khung-Static 1-Factor of Safety-Factor of Safety1

# Conclusion

Analyzed with SOLIDWORKS Simulation Simulation of khung 16

Analyzed with SOLIDWORKS Simulation Simulation of khung 1
