MinhNhut223/Automated-Poultry-Farming-Machine/Print/CoOng1-V2.pdf

# Ngành CNKT Cơ điện tử NHỰA ¹²¹

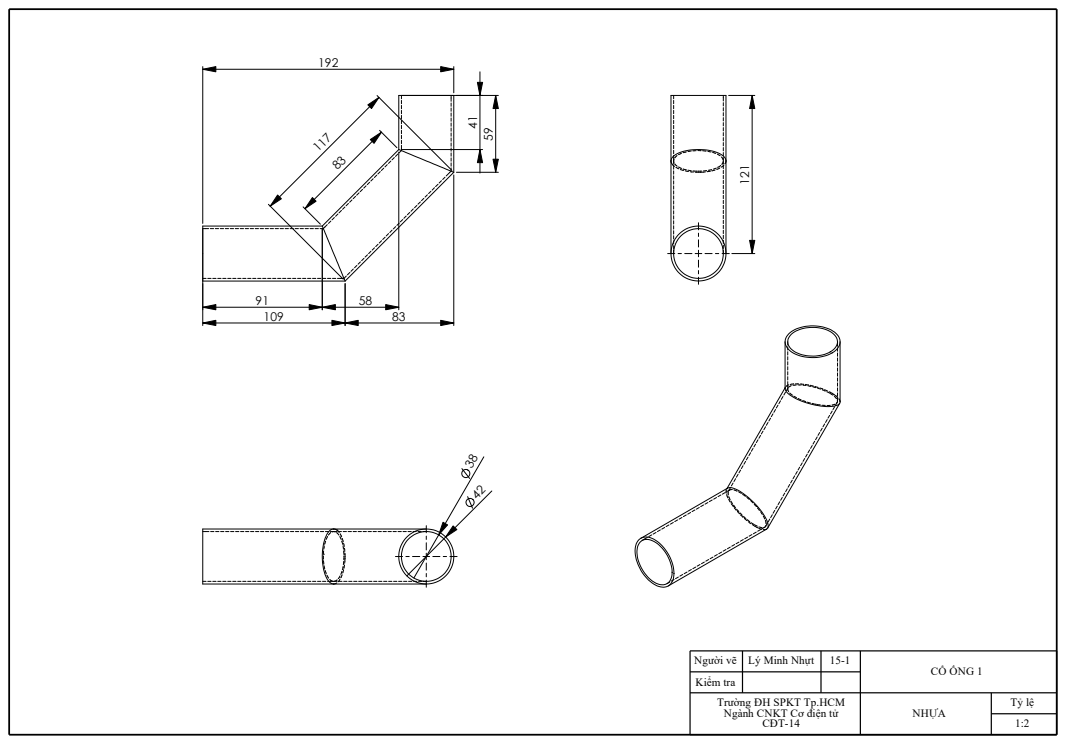
[picture p151: page 1]

Người vẽ | Lý Minh Nhựt | 15-1 | CỔ ỐNG 1
Kiểm tra
Trường ĐH SPKT Tp.HCM CĐT-14 | | Tỷ lệ
