MinhNhut223/Automated-Poultry-Farming-Machine/Print/CoOng2-V1.pdf

A

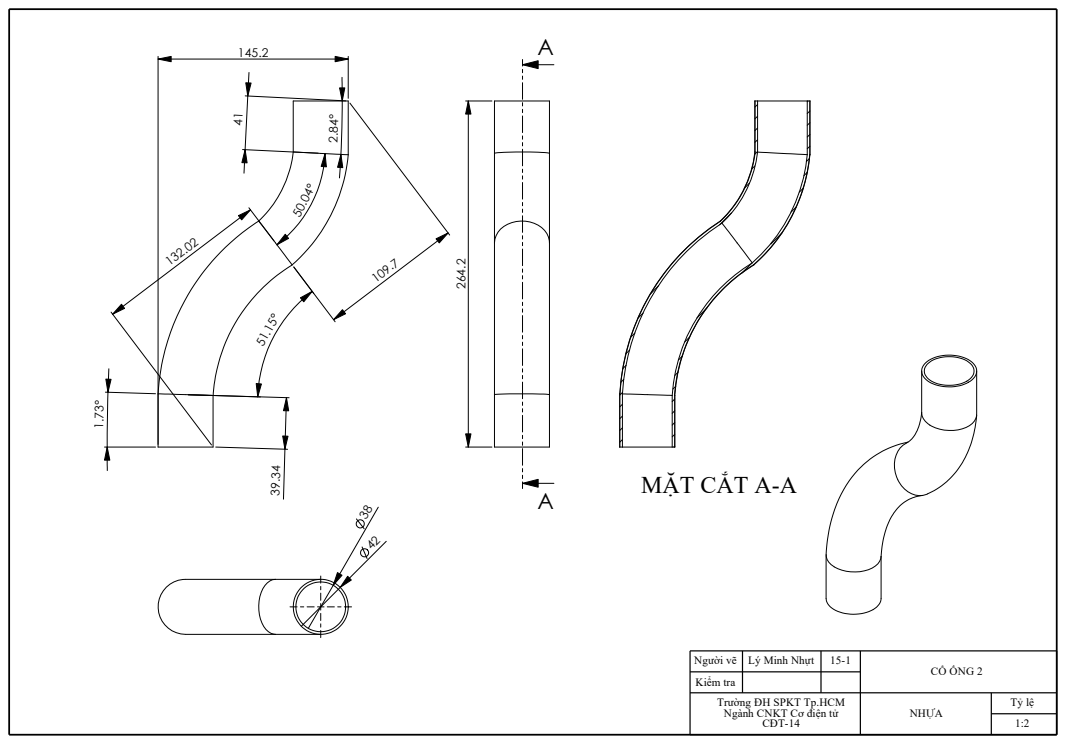
[picture p152: page 1]

MẶT CẮT A-A ²⁶⁴.2

Người vẽ | Lý Minh Nhựt | 15-1 | CỔ ỐNG 2
Kiểm tra
Trường ĐH SPKT Tp.HCM Ngành CNKT Cơ điện tử CĐT-14 | NHỰA | Tỷ lệ
