MinhNhut223/Automated-Poultry-Farming-Machine/Print/KhungThan-V2.pdf

492 ±2

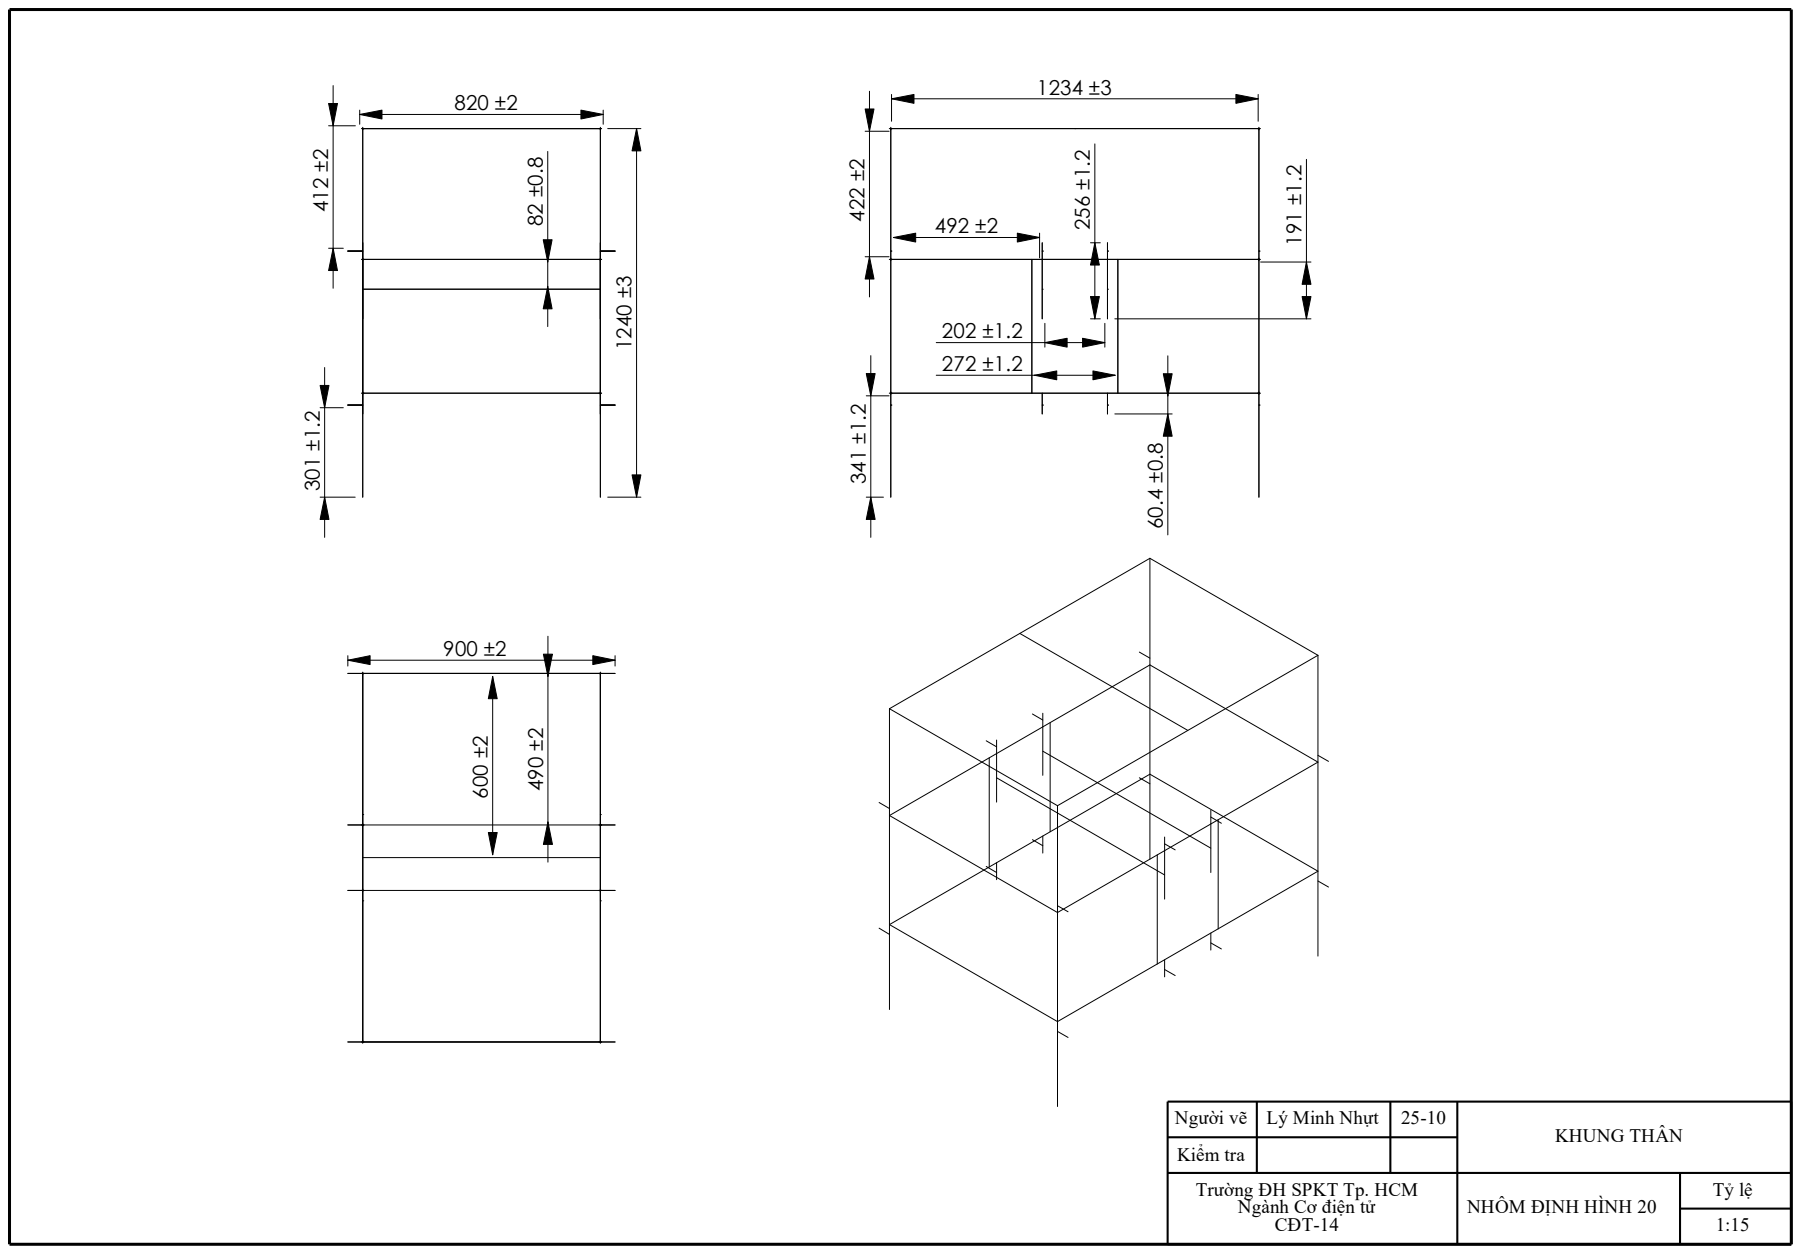
[picture p153: page 1]

Người vẽ | Lý Minh Nhựt | 25-10 | KHUNG THÂN
Kiểm tra
Trường ĐH SPKT Tp. HCM Ngành Cơ điện tử CĐT-14 | NHÔM ĐỊNH HÌNH 20 | Tỷ lệ
