MinhNhut223/Automated-Poultry-Farming-Machine/Print/MayChanNuoiGaTuDong-V2.pdf

# 820 ²⁸⁰ 1846 1260

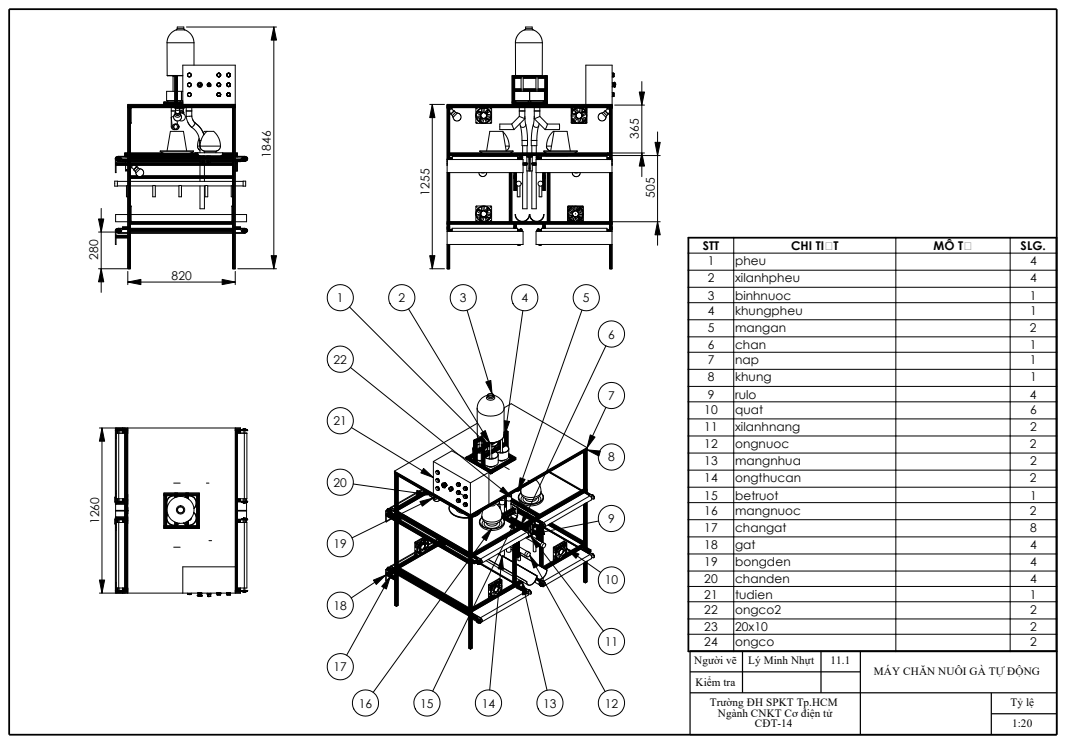
[picture p155: page 1]
STT; CHI TIẾT; SLG.; pheu; xilanhpheu; binhnuoc; khungpheu; mangan; chan; nap; khung; rulo; quat; xilanhnang; ongnuoc; mangnhua; ongthucan; betruot; mangnuoc; changat; gat; bongden; chanden; tudien; ongco2; ongco; 2 ³⁶⁵ ¹²⁵⁵

Người vẽ | Lý Minh Nhựt | 11.1 | MÁY CHĂN NUÔI GÀ TỰ ĐỘNG
Kiểm tra
Trường ĐH SPKT Tp.HCM Ngành CNKT Cơ điện tử CĐT-14 | | Tỷ lệ
