MinhNhut223/Automated-Poultry-Farming-Machine/Print/NapChuong-V3.pdf

A

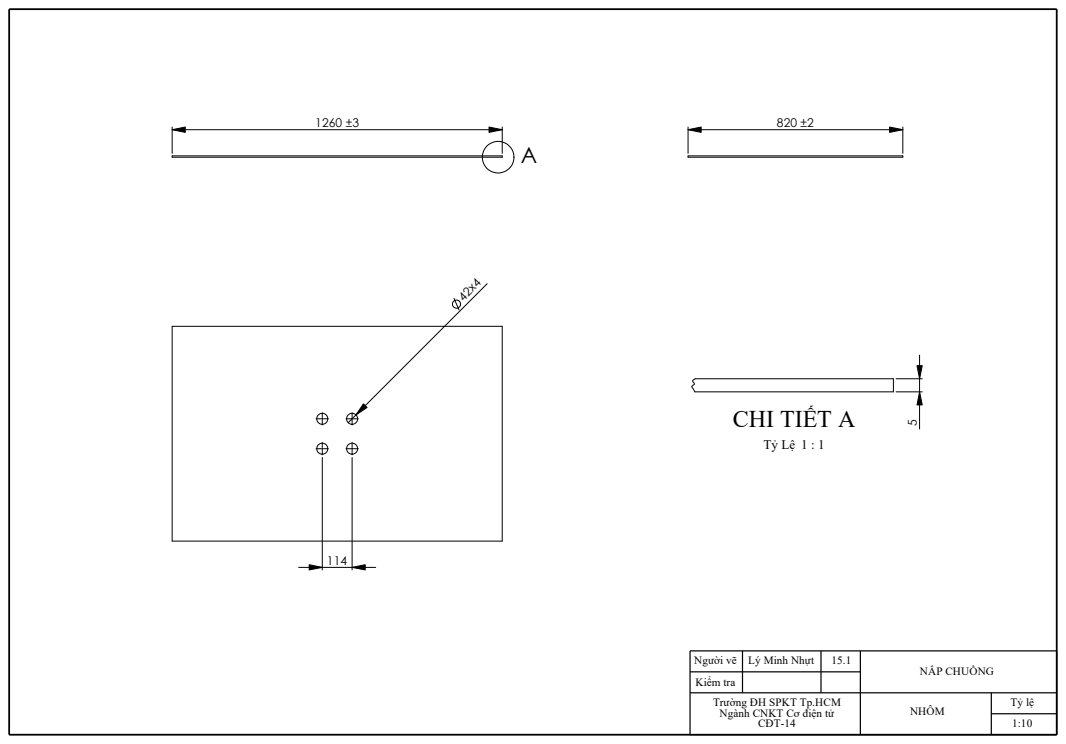
[picture p156: page 1]
CHI TIẾT A

Người vẽ | Lý Minh Nhựt | 15.1 | NẮP CHUỒNG
Kiểm tra
Trường ĐH SPKT Tp.HCM Ngành CNKT Cơ điện tử CĐT-14 | NHÔM | Tỷ lệ
