MinhNhut223/Automated-Poultry-Farming-Machine/Print/OngDanThucAnDuoi-V2.pdf

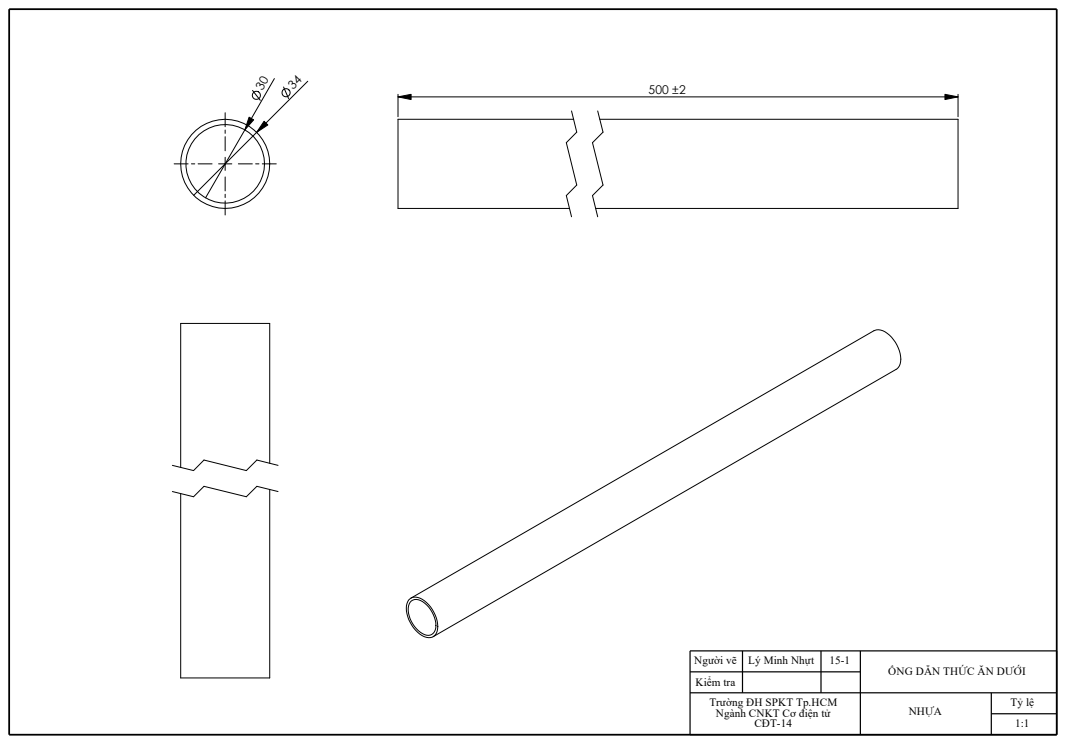
[picture p157: page 1]

Người vẽ | Lý Minh Nhựt | 15-1 | ỐNG DẪN THỨC ĂN DƯỚI
Kiểm tra
Trường ĐH SPKT Tp.HCM Ngành CNKT Cơ điện tử CĐT-14 | NHỰA | Tỷ lệ
