MinhNhut223/Automated-Poultry-Farming-Machine/Print/OngNuocDuoi-V4.pdf

A

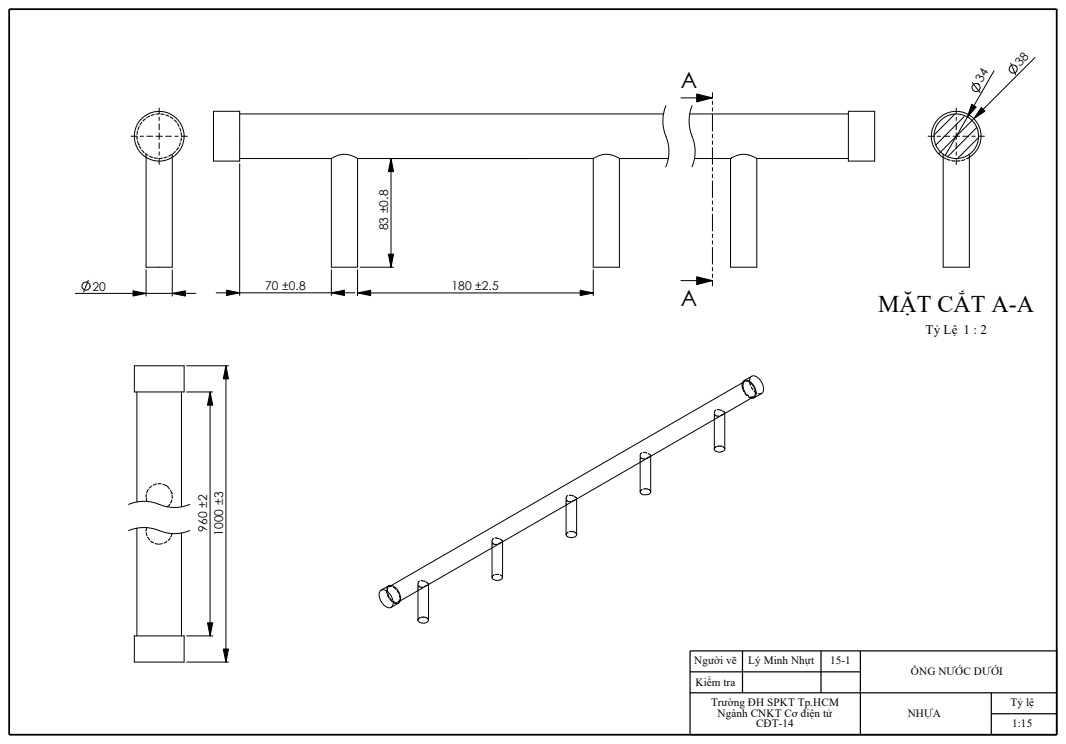
[picture p158: page 1]
MẶT CẮT A-A

Người vẽ | Lý Minh Nhựt | 15-1 | ỐNG NƯỚC DƯỚI
Kiểm tra
Trường ĐH SPKT Tp.HCM Ngành CNKT Cơ điện tử CĐT-14 | NHỰA | Tỷ lệ
