MinhNhut223/Automated-Poultry-Farming-Machine/Print/Pheu-V2.pdf

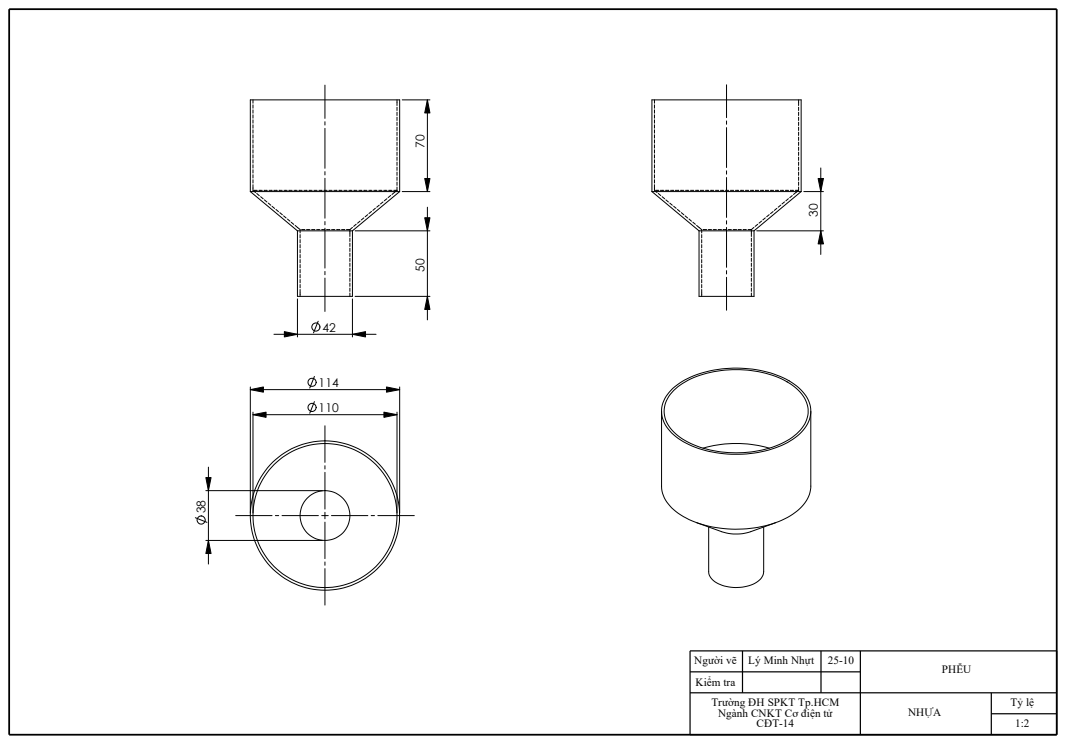
[picture p159: page 1]

Người vẽ | Lý Minh Nhựt | | PHỄU 25-10
Kiểm tra
Trường ĐH SPKT Tp.HCM Ngành CNKT Cơ điện tử CĐT-14 | NHỰA | Tỷ lệ
