MinhNhut223/Automated-Poultry-Farming-Machine/TapBanVe-Ver4(final).pdf

Người vẽ | Lý Minh Nhựt | 25-10 | KHUNG THÂN
Kiểm tra
Trường ĐH SPKT Tp. HCM Ngành Cơ điện tử CĐT-14 | NHÔM ĐỊNH HÌNH 20 | Tỷ lệ

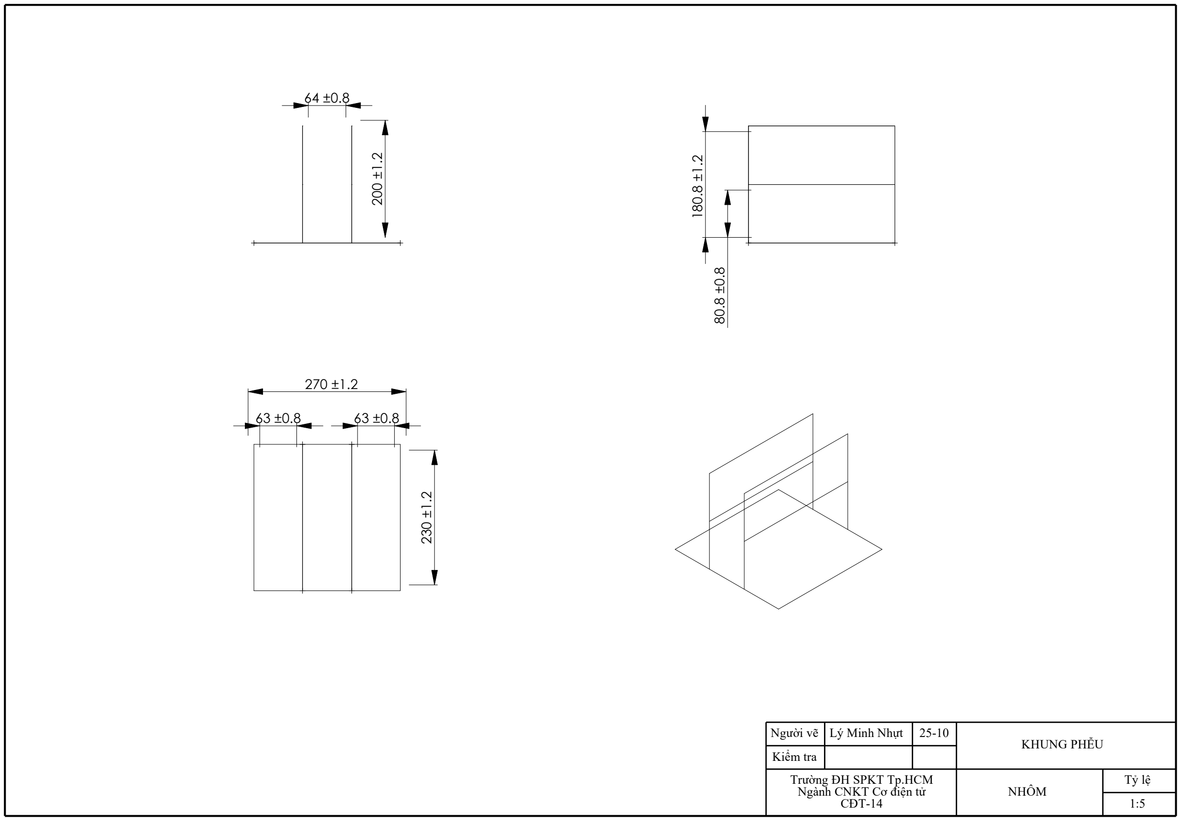
[picture p160: page 2]

Người vẽ | Lý Minh Nhựt | 25-10 | KHUNG PHỄU
Kiểm tra
Trường ĐH SPKT Tp.HCM
1:5
Ngành CNKT Cơ điện tử | NHÔM ²⁰⁰ ±1.2

64 ±0.8

63 ±0.8

270 ±1.2

63 ±0.8 | 230 ±1.2 | 80.8 ±0.8 180.8 ±1.2

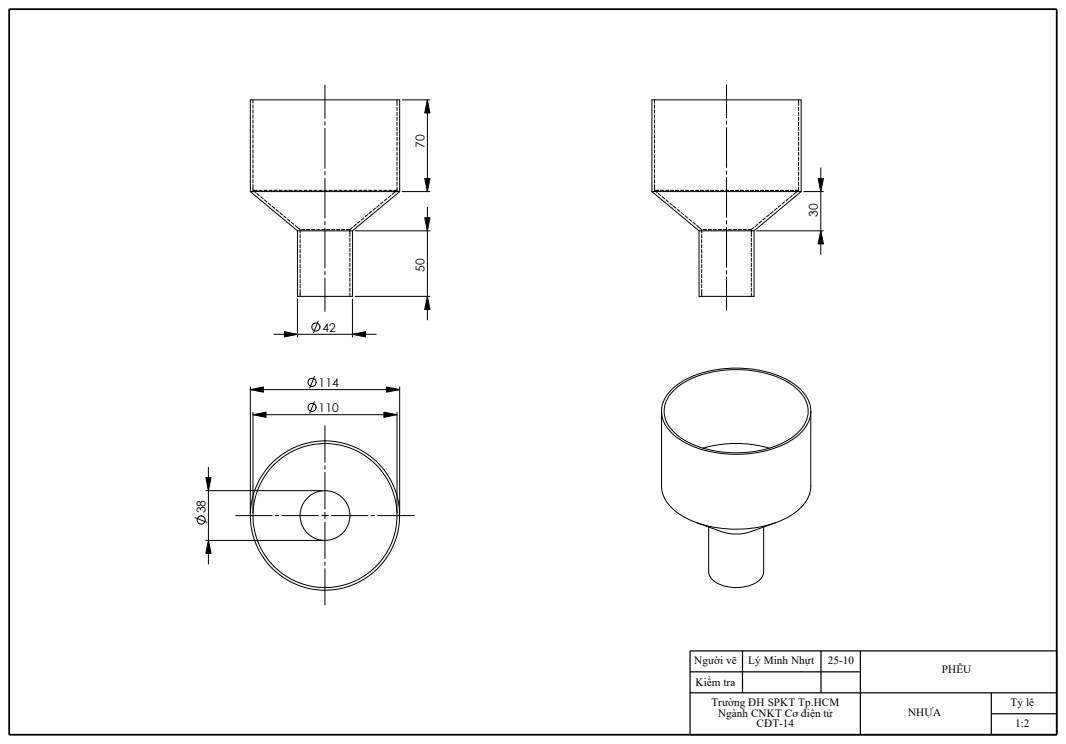
[picture p161: page 3]

Người vẽ | Lý Minh Nhựt | PHỄU 25-10
Kiểm tra

Ngành CNKT Cơ điện tử | NHỰA

# Ngành CNKT Cơ điện tử NHỰA ¹²¹

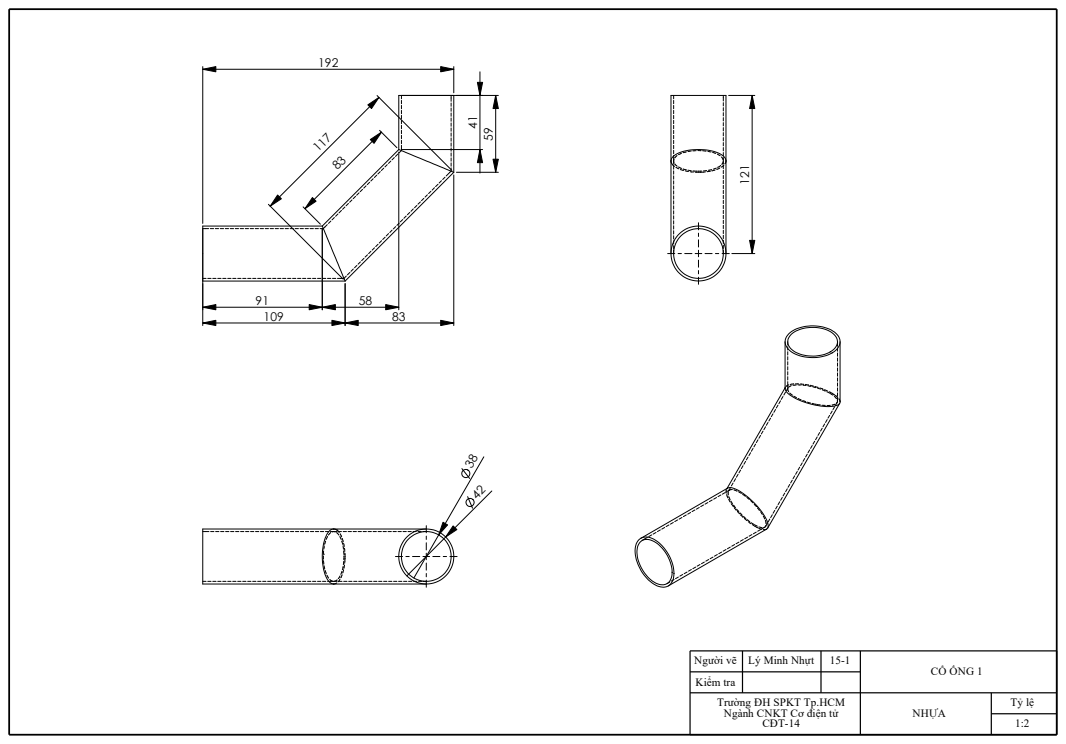
[picture p162: page 4]

Người vẽ | Lý Minh Nhựt | 15-1 | CỔ ỐNG 1
Kiểm tra

A

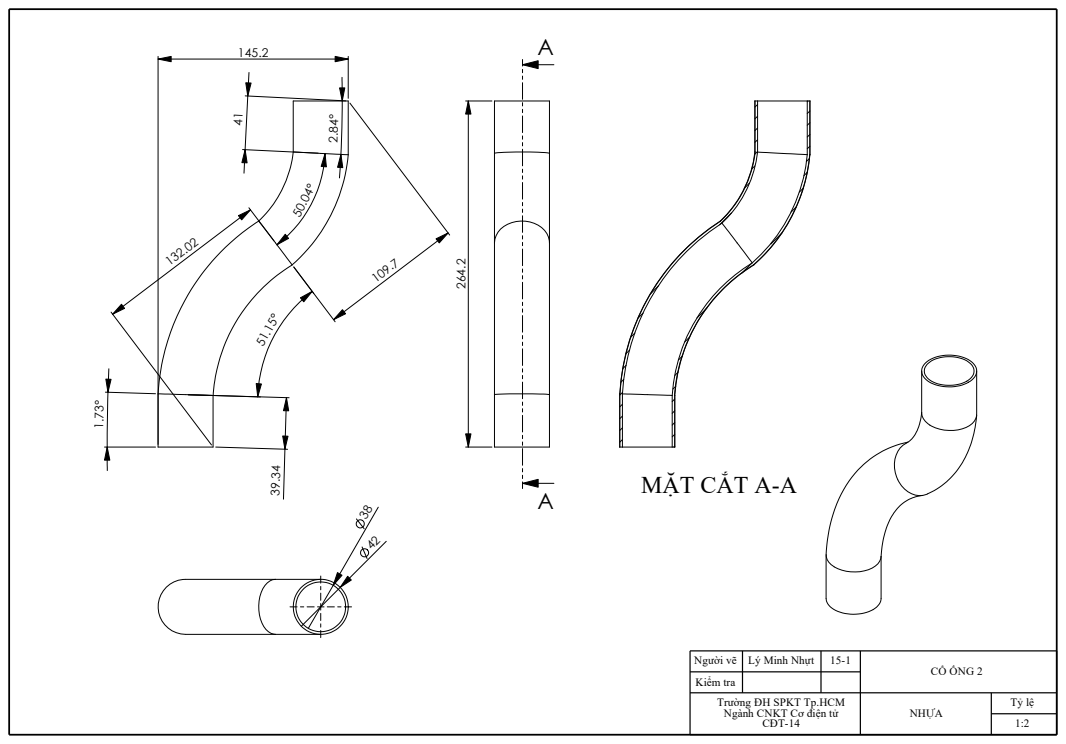
[picture p163: page 5]

MẶT CẮT A-A ²⁶⁴.2

Người vẽ | Lý Minh Nhựt | 15-1 | CỔ ỐNG 2
Kiểm tra

Ngành CNKT Cơ điện tử | NHỰA

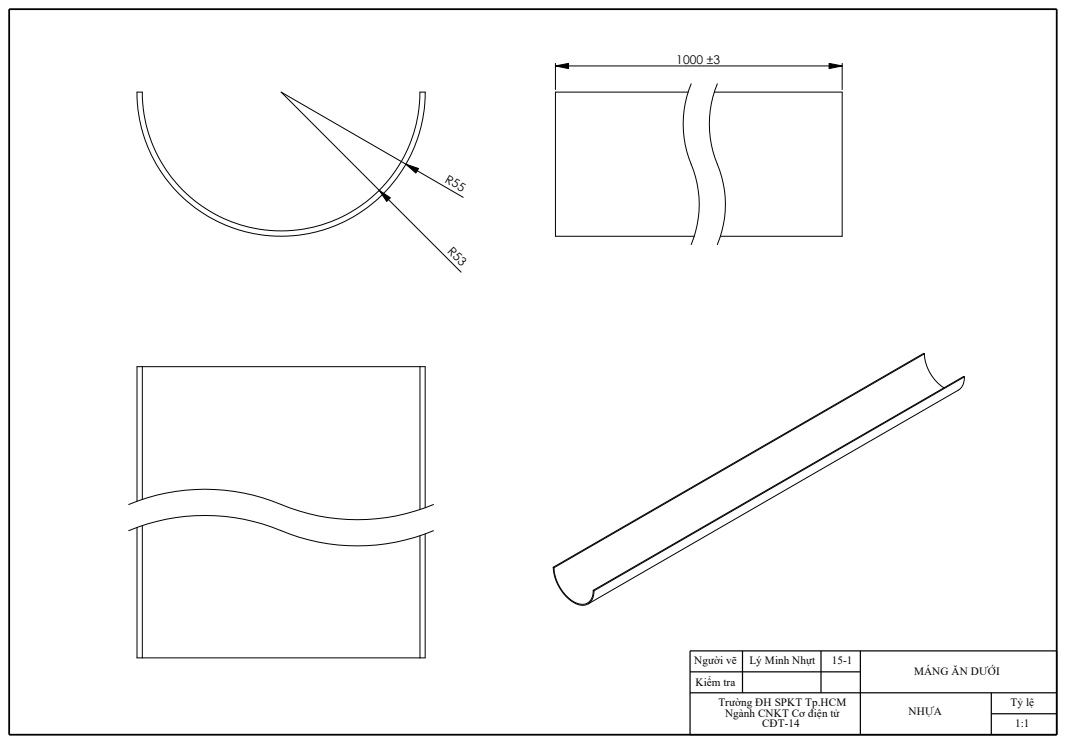
[picture p164: page 6]

Người vẽ | Lý Minh Nhựt | 15-1 | MÁNG ĂN DƯỚI
Kiểm tra

Ngành CNKT Cơ điện tử | NHỰA

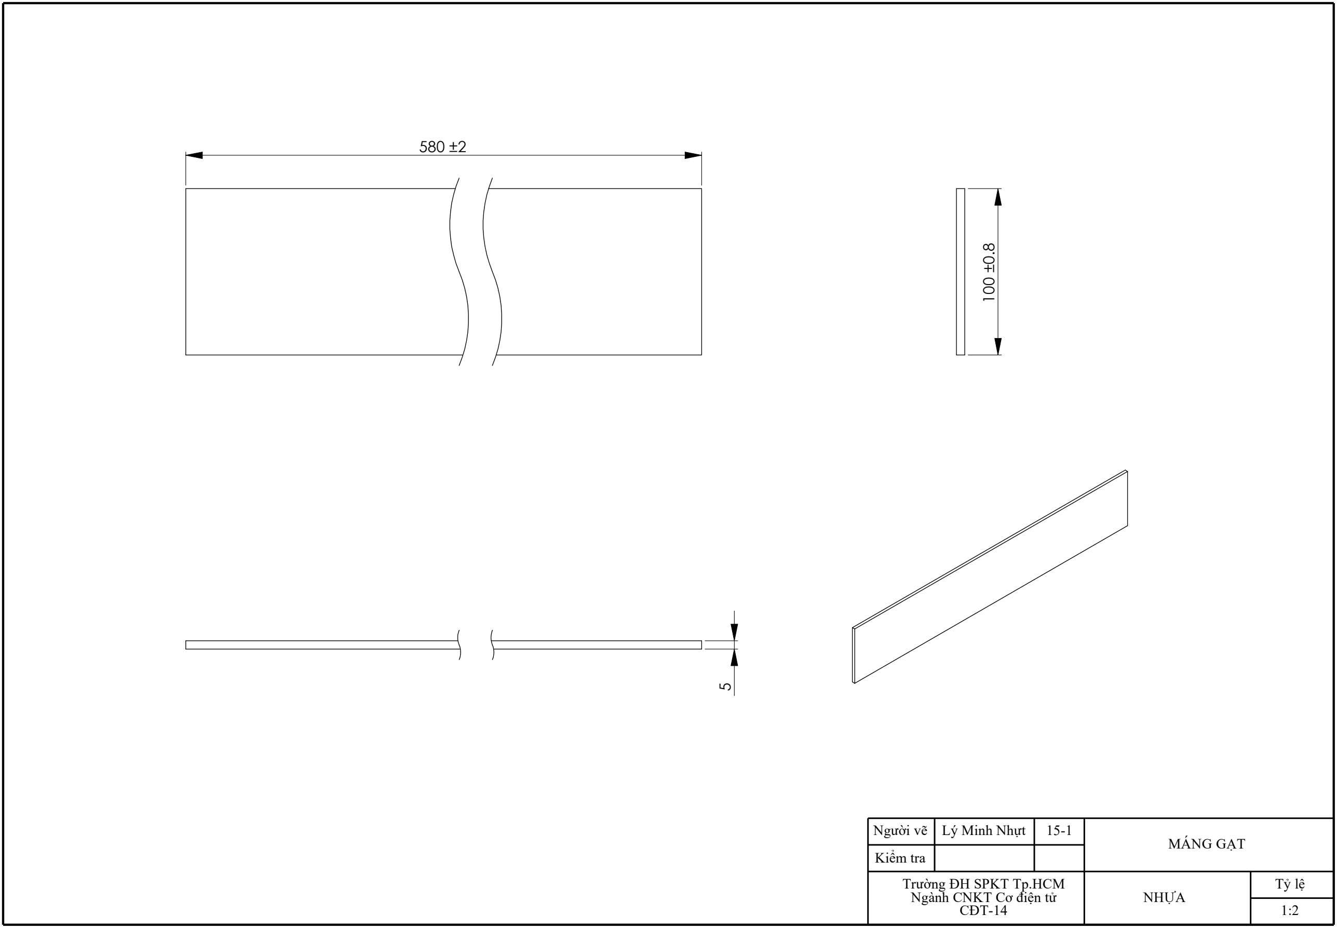
[picture p165: figure]
Người vẽ; Lý Minh Nhựt; MÁNG GẠT; Kiểm tra; Ngành CNKT Cơ điện tử; NHỰA ⁵

A

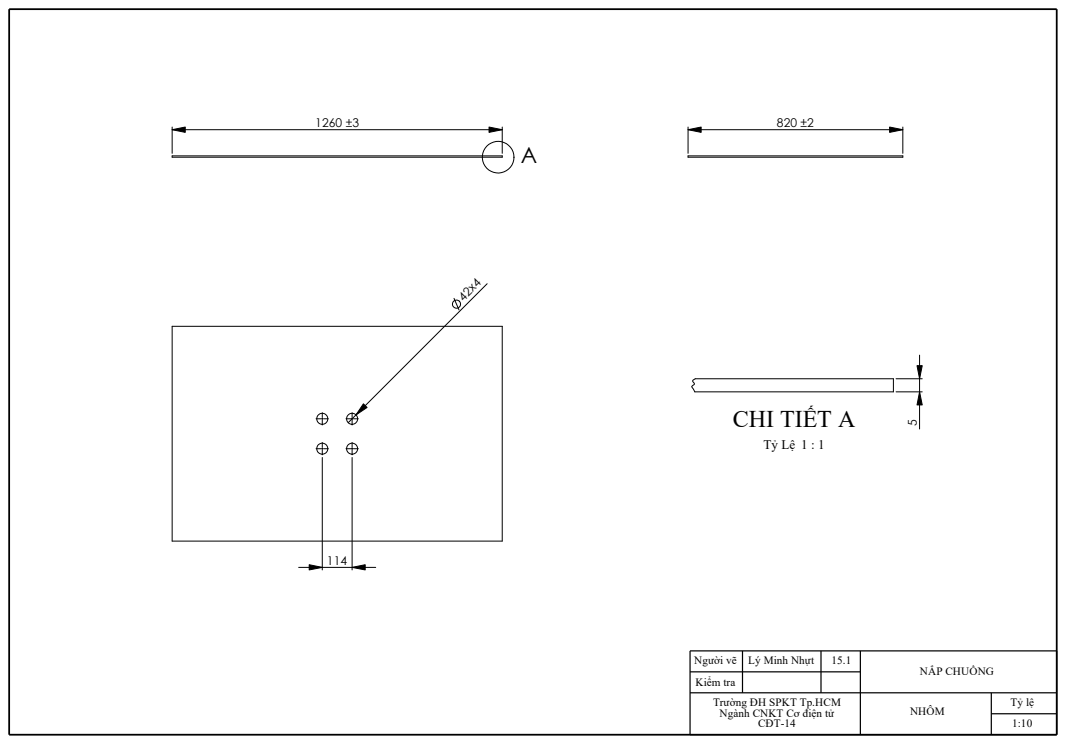
[picture p166: page 8]
CHI TIẾT A

Người vẽ | Lý Minh Nhựt | 15.1 | NẮP CHUỒNG
Kiểm tra

Ngành CNKT Cơ điện tử | NHÔM

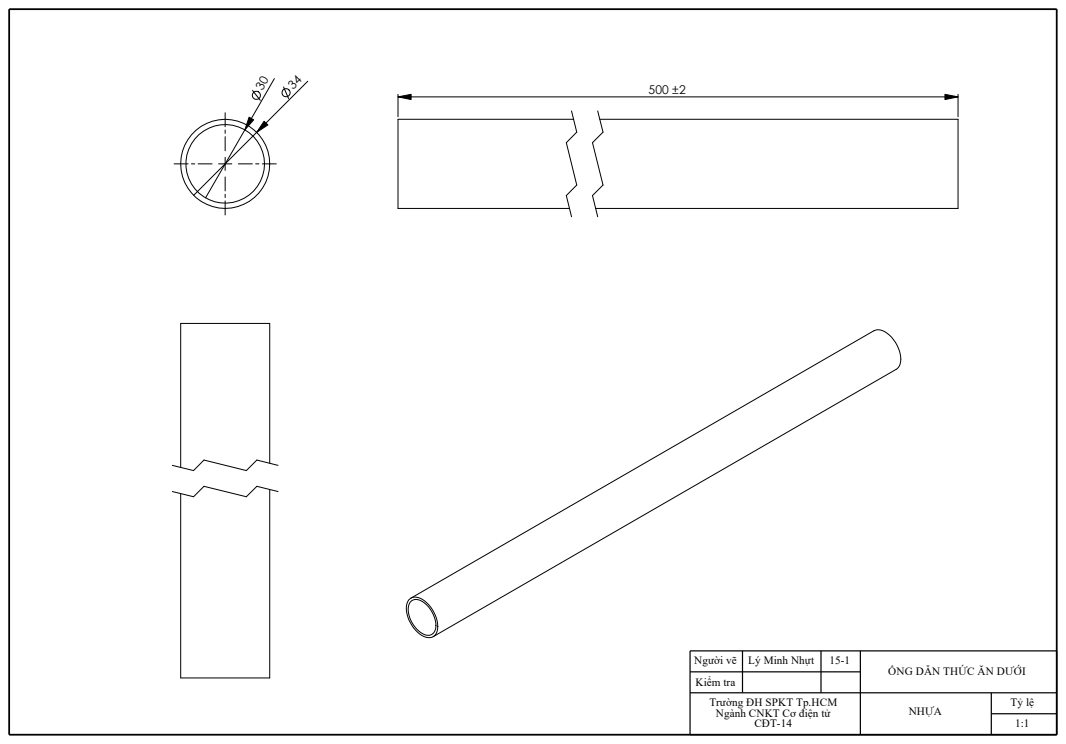
[picture p167: page 9]

Người vẽ | Lý Minh Nhựt | 15-1 | ỐNG DẪN THỨC ĂN DƯỚI
Kiểm tra

Ngành CNKT Cơ điện tử | NHỰA

A

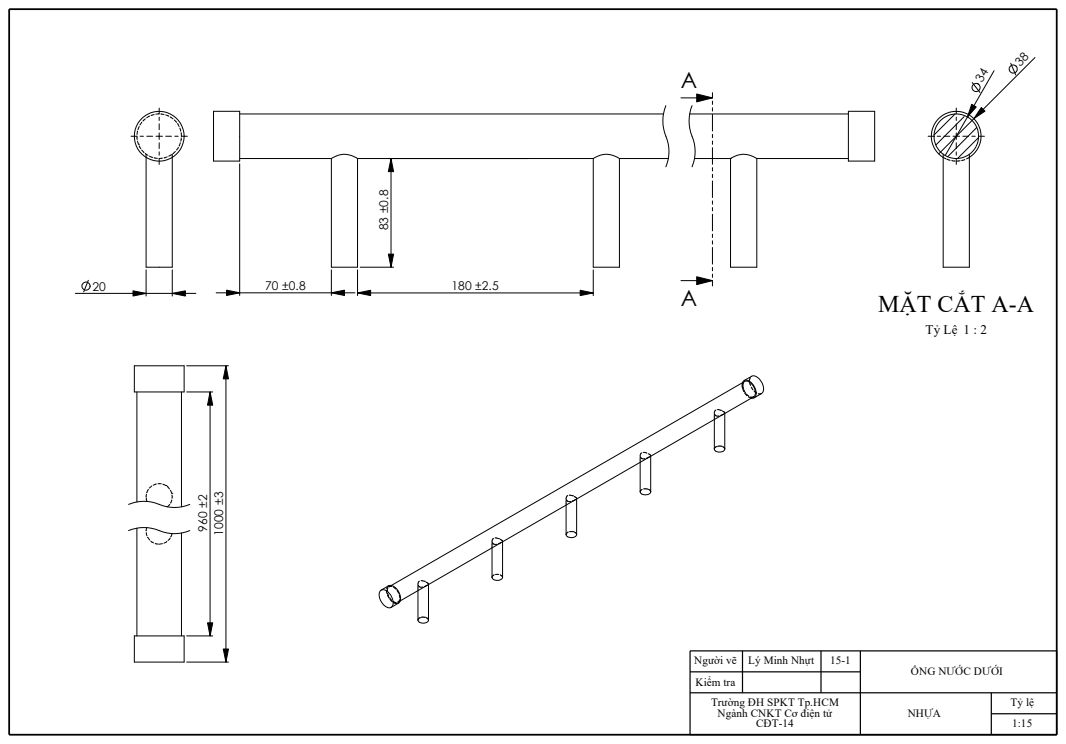
[picture p168: page 10]
MẶT CẮT A-A

Người vẽ | Lý Minh Nhựt | 15-1 | ỐNG NƯỚC DƯỚI
Kiểm tra

Ngành CNKT Cơ điện tử | NHỰA

# 820 ²⁸⁰ 1846 1260

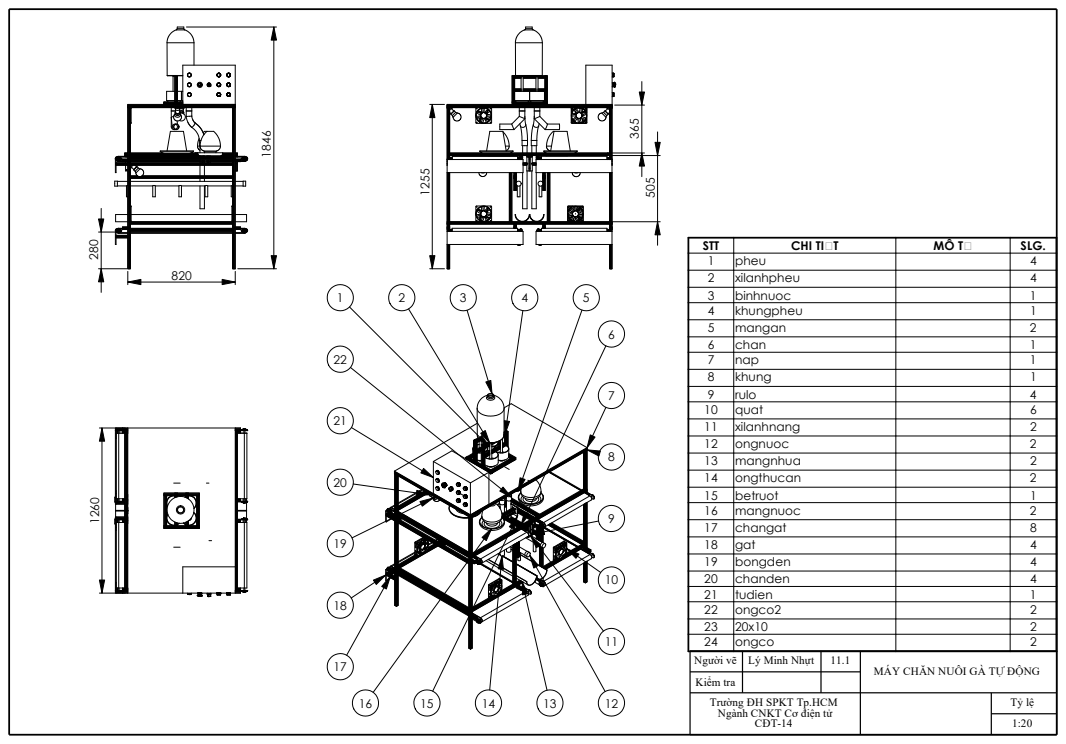
[picture p169: page 11]
STT; CHI TIẾT; SLG.; pheu; xilanhpheu; binhnuoc; khungpheu; mangan; chan; nap; khung; rulo; quat; xilanhnang; ongnuoc; mangnhua; ongthucan; betruot; mangnuoc; changat; gat; bongden; chanden; tudien; ongco2; ongco; 2 ³⁶⁵ ¹²⁵⁵

Người vẽ | Lý Minh Nhựt | 11.1 | MÁY CHĂN NUÔI GÀ TỰ ĐỘNG
Kiểm tra

Ngành CNKT Cơ điện tử
